pepechorva/Rabosa_micromouse/Documentacion/estado-del-proyecto.md

# 📊 Estado del proyecto — Rabosa-MVR

> **Última revisión:** 5 de octubre de 2026
> **Hito MVP:** 19 de septiembre de 2026 → **no alcanzado** (todo el hardware está validado;
> lo que falta es la capa de control)
> **Competición:** 🏁 **disputada y perdida el sábado 3-oct**: el robot se movió sin cable, pero se
> perdió en el laberinto (un pasillo de 8 celdas a tropezones hasta chocar con una pared). Lo que
> falló, **medido**, está en [plan-mejoras.md](./plan-mejoras.md), y la respuesta en
> [puesta-a-punto.md](./puesta-a-punto.md).
> **En curso:** se está acabando de **soldar el bloque analógico** (divisores de batería + 4 canales
> de sensores de pared). El **menú y la máquina de estados** pasaron de diseño a **implementados** el
> 2026-09-28: ver [maquina-estados-menu.md](./maquina-estados-menu.md).
> Este documento es un *snapshot*: se actualiza en cada revisión. El plan a largo plazo vive en
> [planificacion.md](./planificacion.md).

---

## 1. Resumen

| Área | Estado |
|:-----|:---:|
| Arquitectura por capas definida y compilando | ✅ |
| Capas HW / HAL / SENSOR y banco de pruebas | ✅ |
| Encoders (TIM2/TIM3) | ✅ |
| IMU MPU6500 por SPI2 | ✅ |
| Botones (4, pull-up interno, sin resistencias) | ✅ |
| Pantalla OLED SSD1306 128×32 por I2C1 | ✅ |
| Módulo de batería 2S (código + aviso) | ✅ (divisores soldados el 30-sep; **la celda 1 no se usa** mientras se alimente con fuente) |
| Telemetría Teleplot por USART3 | ✅ (+ **consola de órdenes** desde el 30-sep: `BAT`, `HELP`; + `PID` desde el 1-oct) |
| Sensores de pared IR y medida de batería por ADC | ⚠️ **Soldado** (30-sep) y **detección de paredes escrita (1-oct)**: `app/walls.c` con umbral por pared, **ajustable sin cable** (prueba 21). Pruebas **13–17 implementadas**, pendientes de ejecutar |
| Máquina de estados y menú con botones | ✅ **FSM (30-sep)**: menú y APP con el patrón `app/fsm.h` + árbol TEST/EXPLORE/RESOLVE/SETTINGS/DIAG/PARAR; el botón MENU va por **interrupción** (salida de emergencia) |
| Capa **CONTROL** (PID de velocidad + rampas) | ✅ **Implementada (28-sep), verificada en simulación y SINTONIZADA en el robot (1-oct)**: `Kp = 0,10` · `Ki = 0,50` · `Kd = 0` dan **0,5 % de error de régimen** y 0,6 s de asentamiento |
| Capa **FILTER** (odometría, filtros, IEKF) | ⚠️ **Odometría escrita (28-sep) y validada en el robot (1-oct)**: `filter/odometry.c` con la trocha efectiva ya medida · el resto (filtros, estimador de orientación) por escribir |
| Odometría (`odometry.c`) | ✅ **Validada en hardware (1-oct)**: recta de 1 m con **−0,3 %** de error, **trocha efectiva calibrada a 77,6 mm** y giro de 90° a mano **clavado (+90° / −90°)**. ⏳ Falta el cuadrado de cierre 4×300 mm |
| Pruebas de banco lanzables desde el menú | ✅ (28-sep) |
| Movimientos primitivos (`app/motion.c`) | ⚠️ **Escritos (1-oct)**: `MOTION_Avanzar(mm)` y `MOTION_Girar(grados)` con lazo cerrado sobre la odometría, y banco lanzable (**prueba 20**). Pendientes de medir en el robot |
| Navegación (wall follower / flood fill) | ❌ Pendiente |
| Chasis y montaje definitivo | ⚠️ Chasis impreso provisional + placa de prototipos (no breadboard) |
| Laberinto 4×4 | ⚠️ Pendiente de construir |
| PCB propia (KiCad) | ⏸️ **Aparcada a la V2** |
| Fotografías y capturas 3D | ⏳ Pendientes |
| Pinout oficial sincronizado desde `pinout.pdf` | ✅ |
| Lista de hardware (módulos reales + enlaces de compra) | ✅ |

---

## 2. Qué está hecho

### Código

| Capa | Módulos |
|:-----|:---|
| **CORE** | `profile` (perfil trapezoidal unit-agnóstico, validado en el PC) · `core_io.h` (el **contrato** con `drivers/`: lectura de pared, cuentas y velocidad por rueda, reloj, consigna y parada). ⚠️ Sin implementación todavía |
| **DRIVERS** | ❌ **Vacía a propósito**: el contrato se escribió antes que el driver para no descubrir la interfaz parcheando. Ver `firmware/drivers/README.md` |
| **HW** | `io.c/h`, `io_def.h` — acceso rápido a registros GPIO (BSRR/ODR) |
| **HAL** | `adc` (ADC1, 6 canales, polling) · `drv8833` (Init, SetSpeed −100..100, Brake, Coast) · `gpio` · `i2c` (I2C1 maestro 100 kHz) · `pwm` (4 canales TIM1) · `reset` (causa del último reinicio, de `RCC->CSR`) · `spi` (SPI2) · `systemclock` (72 MHz) · `timers` (TIM1 PWM) · `uart` (USART3 + helpers, **recepción por interrupción**) |
| **SENSOR** | `encoder` (TIM2/TIM3 modo encoder + `max_likelihood_counter_diff`) · `imu` (MPU6500 por SPI2 con `IMU_Init`/`IMU_Read`/`IMU_Detected`) · `battery` (divisores 22k/10k, media de 16 lecturas, clasifica OK/aviso/crítica) |
| **CONTROL** | `pid` (Kp/Ki/Kd con **anti-windup**, derivada sobre la medida y filtrada, `dt` validado) · `setpoint` (rampa de consigna) · `controller` (lazo de una rueda: consigna + PID → duty) — ver [control-pid.md](./control-pid.md) |
| **APP** | `application` (FSM de la APP + banco de **19** rutinas) · `menu` (FSM de navegación + tablas `const`) · **`fsm`** (macros del patrón de estados) · `telemetry` (formato Teleplot, **todo numérico**) · `console` (órdenes que llegan por USART3) · `buttons` (4 botones; MENU por interrupción) · `oled` (SSD1306 128×32 + framebuffer) |
| **Build** | `platformio.ini`, `extra_script.py`, `peripherals.h`, `pinout.h`, `main.c` |

### Pruebas de banco (confirmadas en hardware)

| # | Prueba | Estado |
|:-:|:---|:---:|
| 1 | ADC + sensores IR + telemetría | ✅ |
| 2 | Motores + encoders en bucle cerrado | ✅ |
| 3 | ADC → PWM | ➖ **Retirada** (28-sep): el robot no lleva potenciómetros |
| 4 | Encoders (solo lectura) | ✅ |
| 5 | IMU MPU6500 por SPI2 | ✅ |
| 6 | Loopback SPI2 (diagnóstico de bus) | ✅ |
| 7 | Calibración de encoders (PPR / µm por cuenta) | ❌ Pendiente |
| 8 | Botones MENU/UP/DOWN/OK | ➖ Sustituida por la 10 (botones + pantalla) |
| 9 | Rampa de PWM en lazo abierto **medida en ticks de encoder** (izq. PA8/PA9 · dcha. PA10/PA11) | ⚠️ v1 (temporal) validada con la rueda **izquierda** (18-sep) · v2 por ticks y rueda derecha, pendientes |
| 10 | Botones → pantalla OLED por I2C1 | ✅ 20-sep (pantalla girada 180° con `OLED_ROTACION_180`) |
| 11 | Diagnóstico del bus I2C1 (niveles en reposo + escaneo de direcciones) | ✅ 21-sep · `SCL=1`, `SDA=1`, `I2C_FOUND:60` (0x3C) ⇒ el módulo ya trae pull-ups |
| 12 | Batería 2S: pack + celda 1 con divisores **22 kΩ/10 kΩ** (montados 30-sep) | ❌ Pendiente de ejecutar |
| 13 | Chequeo de la **soldadura** del ADC (4 IR + 2 divisores), con veredicto por canal | ❌ Pendiente (función implementada 30-sep) |
| 14 | Emisores IR uno a uno, los cuatro y apagados (PB3/PB4/PB5/PB8) | ❌ Pendiente (función implementada 30-sep) |
| 15 | Receptores IR: **matriz 4×4** emisor↔receptor y elección de $R_L$ | ❌ Pendiente (función implementada 30-sep) |
| 16 | IR modulado: ON−OFF por software (cancela luz ambiente) | ❌ Pendiente (función implementada 30-sep) |
| 17 | Curva distancia↔ADC de los IR (3–15 cm), guiada por OLED | ❌ Pendiente (función implementada 30-sep) |
| 18 | **PID de velocidad por rueda** (capa CONTROL) | ✅ **Sintonizada el 1-oct**: `Kp = 0,10` · `Ki = 0,50` · `Kd = 0,00` → error de régimen **0,5 %** (298,5 mm/s pidiendo 300), asentamiento 0,6 s. `Kp` está limitado a ~0,2 por el **retardo del lazo**, no por la planta |
| 19 | **Odometría diferencial**: pose $(x, y, \theta)$ a partir de los incrementos de las ruedas (capa FILTER) | ✅ **Recta y giro validados (1-oct)**: 1 m con **−0,3 %** de error (confirma los 287,0 µm/cuenta); el giro medía un **7 % corto** y, tras poner la **trocha efectiva en 77,6 mm**, sale **clavado (+90° / −90°)**. ⏳ Falta el cuadrado de 4×300 mm |
| 20 | **Primitivas de movimiento**: avanzar una distancia y girar un ángulo (`app/motion.c`) | ⚠️ **Escritas (1-oct)**, con banco en la prueba 20 (OK avanza 180 mm, UP/DOWN giran ±90° y el error va **acumulado**). Pendiente de medir: celda < 5 mm y giro < 2°. Son la base del *wall follower* y del *flood fill* |

### Capacidades confirmadas

- Comunicación por USART3 y telemetría en formato Teleplot.
- Lectura de los **4** canales de sensores de pared por ADC (`WALL A1`–`WALL A4`) y de los **2** de batería (PB0 total, PB1 celda 1).
- Movimiento de motores por PWM a través del **DRV8833** y frenado.
- Lectura de encoders en modo hardware con detección de dirección y *overflow*.
- IMU MPU6500 respondiendo por SPI2 (se identificó el cruce `SDA/ADO` como causa de fallo típico).
- Diagnóstico de bus SPI con `App_Test_SPI2_Loopback()`.

---

## 3. Qué está pendiente

### 3.1 El *stash* es obsoleto (analizado el 2026-09-21)

`stash@{0}` se llama *«capas pendientes: control, filter, imu, sensor, menu, oled, spi»*, pero al
listar su contenido **no aparece ningún fichero de `control/`, `filter/`, `menu*` ni `oled*`**:

```bash
git stash show --name-only stash@{0} | grep -iE "control|filter|menu|oled"   # → (vacío)
```

Es una foto **anterior a la arquitectura por capas**, con versiones viejas de `application.c`,
`hal/*`, `src/main.c`, `encoder.c` y `platformio.ini`. **Decisión: se ignora.**

CONTROL y FILTER se escriben **de cero**, igual que ya se han escrito `oled.c`, `buttons.c`,
`battery.c` y `spi.c` (todos funcionando en hardware). Cuando ya no haga falta: `git stash drop`.

> Detalle de la comprobación en [pruebas-pendientes.md](./pruebas-pendientes.md) §8.

### 3.2 Pendiente de escribir

- ~~`filter/odometry.c` con la interfaz definida en [odometria.md](./odometria.md)~~ → ✅ **hecha el 28-sep**
  (integración de incrementos de arco; banco en el PC y prueba 19).
- Estimador de orientación (fusión IMU) y filtros de los sensores de pared, en la capa FILTER.
- ~~Máquina de estados en `application.c`~~ → ✅ **hecha el 28-sep** (`BOOT → MENU → {TEST, CAL, DIAG, EXPLORAR} → STOP/FAULT`).
- Movimientos primitivos: `avanzar_celda()`, `girar_90()`, `centrar_pasillo()`, `parar()`.
- Wall follower ("mano derecha") y, más adelante, flood fill.
- DMA para el ADC (lectura continua sin bloquear la CPU).

### 3.3 Pendiente de hardware
- ✅ **Botones cableados**: MENU=PC14 · UP=PB9 · DOWN=PC15 · OK=PA12, con **pull-up interno**
  (activo a bajo, sin resistencias externas). Pulsadores conmutados el 20-sep respecto al plan.
- ✅ **JTAG desactivado** (`__HAL_AFIO_REMAP_SWJ_NOJTAG()` + PB3/PB4/PB5 como salida, en `gpio.c`): los emisores IR ya pueden encender. Queda **verificarlo en hardware** con la prueba 14.
- **Montar los divisores de tensión** de la batería en PB0/PB1 y ejecutar la prueba 12 (⏳ **en soldadura**, 2026-09-28).
- **Medir** los parámetros que hoy son hipótesis: **trocha efectiva** (procedimiento en
  [pruebas-bringup.md](./pruebas-bringup.md) §15, prueba 19) y **radio de rodadura**. El PPR — **7** — y
  la reducción — **1:10** — ya los publica el fabricante ([hardware.md](./hardware.md#42-encoders)), y
  el radio efectivo va dentro de los µm/cuenta que verifica la prueba 7.
- Calcular las **resistencias de los emisores IR**: ✅ calculadas y montadas (22 Ω por emisor + transistor BC337, §4.4 de `hardware.md`), pendientes de la $R_L$ de los receptores (**3 kΩ**, a ajustar con las pruebas 1 y 15).
- **Montar los divisores de tensión** de la batería en PB0/PB1 y ejecutar la prueba 12.
- Decidir la **posición física** de los 4 canales IR.
- Rediseñar las **ruedas** (acercarlas al centro) y actualizar chasis/trocha.
- ✅ Montaje en **placa de prototipos** (se descarta la breadboard).
- Laberinto 4×4 de cartón pluma o DM.
- **Exportar los STEP** del montaje y del chasis a `mechanical/freecad/export/` y cerrar las cotas
  (hoy la trocha tiene tres valores distintos en la documentación).
- **Fotos** y capturas 3D del robot para la documentación (pendientes).
- ✅ **Rieles de alimentación confirmados (21-sep)**: los 3,3 V los genera el **regulador de la propia
  Blue Pill** (IMU, emisores IR y receptores IR); al riel de **5 V** cuelgan la **OLED** y los
  **encoders N20**. Los botones usan el **pull-up interno**. El módulo AMS1117 solo hace de soporte
  físico del display.
- ✅ **Encoders: riel y especificaciones (21-sep)**: van al riel de **5 V** (el módulo admite
  **3,3–5 V**), que es como se hicieron las pruebas de motores y encoders. La salida es de
  **colector abierto con pull-up de 3,3 kΩ** ⇒ el nivel alto acompaña al riel del pull-up.
  El código ya lleva las constantes del fabricante: **7 PPR**, **1:10**, **280 cuentas** por vuelta
  de rueda y **235,6 µm/cuenta**.
- ✅ **Nivel alto de los encoders medido (21-sep)**: con `VCC` = 5 V la salida de `C1`/`C2` da
  **≈3,6 V de pico a pico**, o sea que el módulo limita internamente la salida (el pull-up no va
  directo a `Vcc`). Queda dentro del **máximo absoluto** de 4,0 V de PA0/PA1/PA6/PA7 (pines `TTa`,
  sin `FT`) y muy por encima del umbral de lectura (2,31 V) ⇒ **se queda como está**.
  Opcional para la PCB V2: `VCC` del encoder a 3,3 V, que también está en su especificación
  ([hardware.md §4.2](./hardware.md#42-encoders)).
- **PCB propia en KiCad**: ⏸️ aparcada a la V2. Cuando se retome: **hay que sustituir el buck MP1584**
  (está **NRND**, *not recommended for new designs*) por uno activo de bajo Iq — criterios en
  [hardware.md §4.6](./hardware.md); y la **batería LiPo es provisional** (se actualizará cuando el
  usuario tenga una nueva).
- Completar los [cabos sueltos](./hardware.md#6-cabos-sueltos) de `hardware.md`.

### 3.4 Pendiente de calibración

- **Reducción del N20**: ✅ **1:10** según la tabla del fabricante; la prueba 7 lo verifica contando
  pulsos (10 vueltas de rueda ⇒ 2800 cuentas).
- `micrometers_per_count` (avanzar 1 m y dividir).
- Curva distancia IR (3–15 cm, error < 1 cm).
- Offset del giroscopio: ✅ **hecho el 2026-10-02**, pero **no a mano**: lo promedia el propio firmware (50 muestras con el robot parado) al entrar en las pruebas 20 y 21 (`motion_gyro_calibrar()`); el sesgo se queda en `Motion_t.gyro_sesgo`.
- Divisores de tensión de la batería: ✅ **montados y definitivos (30-sep)**: pack **22 kΩ + 10 kΩ** y celda 1 **3k9 + 10 kΩ** (no los 100 kΩ/56 kΩ calculados) → verificar la prueba 12 y **calibrar con `BAT CAL <mV>`** (`sensor/battery.c`).

---

## 4. Siguientes pasos

| # | Paso | Puerta de salida |
|:-:|:-----|:---|
| 1 | ~~**Terminar de soldar** el bloque analógico: divisores de batería + 4 canales IR~~ ✅ **hecho (30-sep)**: el robot está soldado; las 5 pruebas del bloque (13–17) están escritas | Soldaduras repasadas y 3.3 V del regulador de la Blue Pill verificados |
| 2 | ~~Ejecutar la **prueba 13** (chequeo de la soldadura del ADC)~~ ✅ **hecho (30-sep)**: los 4 receptores y PB0 `OK` (medida con sol: repetir con luz controlada) | Los 6 canales con veredicto `OK` |
| 3 | **Pruebas 14 y 15**: ✅ **pareja emisor↔receptor medida (30-sep)** — R0←IR3 · R1←IR1 · R2←IR2 · R3←IR0 — y posiciones físicas de emisores y receptores anotadas. ⏳ Falta cerrar la **14** por el lado eléctrico (caída en las 22 Ω, consumo y riel con los cuatro a la vez) | Los 4 pares identificados y la $R_L$ definitiva elegida |
| 4 | Ejecutar la **prueba 16** (modulado ON−OFF) — ⏳ **aplazada a la tarde (30-sep)**: necesita luz controlada | `DIF` estable al encender y apagar la luz de la sala |
| 5 | Ejecutar la **prueba 17** (curva IR) — ⏳ **aplazada a la tarde (30-sep)**: necesita luz controlada | Error < 1 cm entre 3 y 15 cm |
| 6 | 👉 **Siguiente (30-sep)**: ejecutar la **prueba 12** y **calibrar el divisor** con el multímetro (`BAT CAL <mV>`) | `VBAT` dentro del ±3 % |
| 7 | Ejecutar la **prueba 7** (PPR y µm/cuenta) | PPR entero y repetible; ≈660 mm |
| 8 | ~~Decidir los **glifos** y programar **M1**~~ ✅ **hecho (28-sep)**: glifos `F G R X + / >` añadidos a `oled.c` y menú programado en `app/menu.c/h` | Recorrer el árbol de menú con los 4 botones, sin PC |
| 8b | **Menú y APP como FSM** con el patrón `app/fsm.h` + árbol nuevo (✅ 30-sep) | Escribir estados y transiciones como el diagrama, con traza `>APP_EST`/`>MENU_EST` |
| 8c | **Pantallas de SETTINGS** (fase M6b): editor de valores con UP/DOWN/OK — BATERIA · VELOCIDAD · PID · LABERINTO · TELEMETRIA · GUARDAR/RESET | Cambiar un umbral o una ganancia con los botones y que sobreviva al reinicio |
| 9 | ~~Mover las pruebas a `bench.c` + `APP_Pump()`~~ ✅ **hecho de otra forma (28-sep)**: las pruebas siguen en `application.c` y salen con `while (!BUTTONS_SalidaSolicitada())` (MENU por interrupción) | Lanzar **y salir** de cualquier prueba desde la OLED |
| 10 | ~~Escribir `control/pid.c` + `setpoint.c` + `controller.c`~~ ✅ **hecho (28-sep)**: implementado y validado en simulación ([control-pid.md](./control-pid.md)) | PID de velocidad en ambos motores |
| 10b | **Sintonizar el PID sobre el robot** (prueba 18, Ziegler-Nichols) | Escalón sin sobreimpulso > 20 %; con la misma consigna en las dos ruedas, el robot va recto |
| 11 | Escribir filtros y `odometry.c` | Posición estimada con error < 5 % |
| 12 | Implementar la máquina de estados de misión + movimientos | 90° con error < 2° |
| 13 | Wall follower en laberinto 4×4 | Recorrido completo 10/10 |
| 14 | Validar la **prueba 9 v2** (rampas por ticks) en las dos ruedas | Ticks por vuelta repetible |
| 15 | ~~Completar la **prueba 3** (ADC→PWM)~~ ➖ **retirada** (28-sep): el robot no lleva potenciómetros | — |

---

## 5. Riesgos y bloqueos

| Riesgo | Impacto | Mitigación |
|:---|:---|:---|
| Reducción del N20 mal asumida | `micrometers_per_count` y odometría mal escalados | La tabla del fabricante da **1:10** y **7 PPR**; la prueba 7 lo verifica contando (2800 cuentas = 660 mm) |
| Cabos sueltos de hardware sin resolver | Compras equivocadas, firmware que no encaja | Resolver midiendo antes de comprar |
| CONTROL y FILTER hay que escribirlos **de cero** (el *stash* no los trae) | Es el camino crítico hacia el movimiento | Empezar por el PID de velocidad, con su prueba de banco |
| Sin DMA en el ADC | El bucle de control puede perder muestras a alta velocidad | Planificar DMA antes de subir la velocidad |
| Ruido en los sensores IR | Umbrales y PID inestables | Filtrar y calibrar antes de cerrar el lazo |
| El hito del 19-sep **no se alcanzó** | Hay que reencuadrar la fecha | El hardware está validado: priorizar control y movimiento, sin fecha cerrada |

---

## 6. Registro de decisiones

| Fecha | Decisión | Motivo |
|:---|:---|:---|
| 2026-07-23 | Migrar de estructura plana a arquitectura por capas | Aislar cambios de hardware en una sola capa |
| — | Telemetría por **USART3** en lugar de USART1 | Liberar pines y separar depuración de programación |
| — | IMU por **SPI2** en lugar de I2C | Mayor velocidad de lectura |
| — | Encoders en modo hardware (TI12, ×4) | Más resolución y sin *polling* de GPIO |
| 2026-09-10 | Documentar hardware/pruebas/estado y empaquetar el flujo como skill del agente | Trabajar de forma incremental y trazable |
| 2026-09-10 | Driver de motor confirmado: **DRV8833** | Resuelta la discrepancia con el BOM (TB6612FNG) |
| 2026-09-10 | Pinout actualizado desde `pinout.pdf` (3 sep) | Añade LEDs (PA12/PA15/PB9/PC13–15), doble medida de batería y 4 canales IR; PB1 deja de ser sensor de pared |
| 2026-09-10 | Reducción del N20 asumida como **desconocida (¿10:1?)** | Se determinará por prueba, no por datasheet |
| 2026-09-10 | **Lista de hardware completada** | Motores JGA12-N20B 6V, DRV8833, MT3608+MP1584, LiPo 2S 450mAh 80C, 4+4 IR |
| 2026-09-10 | Constantes cinemáticas actualizadas a $r = 10.5$ mm, $L \approx 83.6$ mm | Antes eran valores de ejemplo (16 mm / 50 mm) |
| 2026-09-10 | Añadida la prueba 7 de calibración de encoders + [calibracion-encoders.md](./calibracion-encoders.md) | Cerrar PPR, reducción y µm/cuenta por medición |
| 2026-09-10 | **4 botones** (MENU, UP, DOWN, OK) sobre pines de la lista de LED | Entrada de usuario para el menú; pines aún por asignar |
| 2026-09-10 | Detectado que **JTAG sigue activo** y PB3/PB4/PB5 como entrada | Los emisores IR L1–L3 no pueden funcionar así |
| 2026-09-10 | **Corregido**: `SWJ_NOJTAG()` + PB3/PB4/PB5 como salida en `gpio.c` | Habilita los emisores IR L1–L3 y libera PA15 |
| 2026-09-10 | Botones asignados: **MENU=PA12 · UP=PC15 · DOWN=PB9 · OK=PC14** | Se saca UP de PA15 para que ningún botón dependa del JTAG; PC13 se mantiene como LED |
| 2026-09-10 | Botones implementados en `app/buttons.c` (capa APP) | Es entrada de usuario y va parejo con el futuro `menu.c` |
| 2026-09-10 | `gpio.c` ya **no reconfigura PA13/PA14** | Eran SWDIO/SWCLK: ponerlos como GPIO dejaba sin depurador |
| 2026-09-10 | Depuración **solo por SWD** (SWDIO/SWCLK), JTAG desactivado de forma permanente | Los emisores IR necesitan PB3/PB4 como GPIO |
| 2026-09-19 | Prueba de banco 9: `App_Test_PWM_Rampa()` sobre **PA8/PA9** (canal A del DRV8833 = `motor1`) | Validar pinout de PWM, frenada en seco y sentido de giro sin encoders; identifica qué rueda cuelga del canal A |
| 2026-09-19 | **Ruedas identificadas**: canal A (PA8/PA9) = **izquierda** · canal B (PA10/PA11) = **derecha**; la prueba 9 pasa a elegir motor con `PWM_RAMPA_MOTOR` (1 izq · 2 dcha · 0 ambos) | Ya no hay que adivinar el montaje: el reparto se midió en banco moviendo cada par de pines por separado |
| 2026-09-19 | **Encoders cableados y confirmados**: izq. PA0/PA1 (TIM2) · dcha. PA6/PA7 (TIM3) — coincide con lo que ya esperaba `sensor/encoder.c`, sin cambios de configuración | El cableado estaba planificado así desde el pinout; se verifica que no hay que reasignar pines |
| 2026-09-19 | Prueba 9 rehecha con el **encoder como reloj**: rampas de 1500 ticks (500 ticks = 1 s) en vez de 3 s; las pausas de 2 s siguen en ms (parado no hay ticks) y se añaden timeouts anti-atasco | La rampa pasa a ser reproducible por distancia recorrida, no por tiempo, y de paso valida los encoders |
| 2026-09-20 | Eventos de botón con **potencias de dos**: 1 MENU · 2 UP · 4 DOWN · 8 OK (`BUTTONS_GetEvent()` + `>BTN:n`) | Coinciden con los bits de `BUTTONS_GetMask()`: evento y máscara se pueden combinar con `&` |
| 2026-09-20 | Freno de banco: `while(1){;}` en `main.c` antes de `APP_Run()` (preferencia del usuario; un define para elegir modo, más adelante) | Evita que los motores giren mientras se toca el hardware. Consecuencia anotada: `--gc-sections` elimina el banco de pruebas del binario |
| 2026-09-20 | **OLED SSD1306 128×32 en I2C1** (PB6/PB7, 0x3C) con driver propio `app/oled.c` (framebuffer de 512 B, sin librería externa) | Mostrar estado sin depender del PC. Prueba 10: cada botón enseña su nombre y su pin |
| 2026-09-20 | **Botones intercambiados**: MENU=PC14 · UP=PB9 · DOWN=PC15 · OK=PA12 (antes MENU=PA12 · UP=PC15 · DOWN=PB9 · OK=PC14) | El cableado real no coincidía con la asignación; se cuadra en firmware (`pinout.h` + `gpio.c` + nombres de `buttons.c`) |
| 2026-09-20 | Prueba 11: diagnóstico del bus I2C1 (niveles en flotante + escaneo de direcciones). Documentado que **en el F1 no hay pull-up interno en `AF_OD`** (el HAL ignora `Pull`) | Sin pull-ups nadie sube el bus; la prueba dice si hay que añadir 2× 4.7 kΩ |
| 2026-09-21 | **Divisores de batería calculados: 100 kΩ + 56 kΩ (1 %)** (pack en PB0, celda 1 en PB1; celda 2 = resta). k = 0.359 ⇒ 3.015 V a 8.4 V, 81 µA *(el filtro de 100 nF se retira ese mismo día: ver la fila «sin condensadores»)* | Pack de solo 450 mAh: se busca bajo consumo manteniendo resolución de 2.25 mV/cuenta |
| 2026-09-21 | **Reloj del ADC corregido a 12 MHz** (`RCC_ADCPCLK2_DIV6` en `HAL_ADC_MspInit`) y tiempo de muestreo a **239.5 ciclos** | El prescaler nunca se configuraba ⇒ 36 MHz, fuera de los 14 MHz máximos del F1. Y con 13.5 ciclos solo se admitían ~13 kΩ de fuente: los divisores (36 kΩ) y los fototransistores IR necesitan más |
| 2026-09-21 | **Datasheets añadidos al repo**: `Datasheets/sfh4550.pdf` (ams-OSRAM) y `Datasheets/st-1kl3a.pdf` (Kodenshi) | Sacar los números reales en vez de estimarlos |
| 2026-09-21 | **Resistencias IR calculadas**: emisores **220 Ω** (≈9.3 mA, 37 mA los cuatro); receptores **$R_L$ = 4.7 kΩ** *(sin condensador de filtro: ver la fila «sin condensadores»)* | La $I_L$ del ST-1KL3A (5 mA a 200 lx) hace que la luz ambiente sature el receptor en continua: hay que medir y ajustar, y modular más adelante |
| 2026-09-21 | **Sin condensadores** (decisión del usuario: **no queda espacio** en el chasis): se quitan los 2× 100 nF de los divisores de batería y los 4× 10 nF de los receptores IR. Se mantienen los valores de resistencia (100 kΩ/56 kΩ y $R_L$ = 4,7 kΩ) | El ADC no los necesita: la carga del nodo (36 kΩ × 8 pF ≈ 0,3 µs) es 70× más rápida que el muestreo de 21 µs. El ruido se combate con la **media de 16 lecturas** (`BAT_MUESTRAS`) y, en los IR, con la futura **modulación por PWM**, que ahora no tiene límite de frecuencia |
| 2026-09-21 | **Aviso de batería baja**: módulo `sensor/battery.c` (SENSOR, mide y clasifica) + `app_aviso_bateria()` (APP: LED a 1/4 Hz y mensaje en la OLED) | Separar medida de presentación; listo para llamarlo desde el bucle de la futura máquina de estados |
| 2026-09-21 | **Lista de módulos reales con enlaces de compra** (`hardware.md` §7) y **reparto de rieles confirmado**: 3,3 V del regulador de la Blue Pill (IMU, emisores y receptores IR), **OLED y encoders a 5 V**, botones con pull-up interno. El módulo AMS1117 **no regula**: es el soporte físico del display | Saber qué hay montado de verdad y de dónde cuelga cada carga |
| 2026-09-21 | **Encoder alimentado a 5 V** (como está montado y probado en banco). **Medido: la salida da ≈3,6 V de pico a pico**, así que el módulo limita internamente el nivel alto (el pull-up no va directo a `Vcc`) | Queda dentro del máximo absoluto de 4,0 V de PA0/PA1/PA6/PA7 (pines `TTa`, sin `FT`) aunque en el límite de `VDD + 0,3 V` ⇒ **no se cambia nada**; para la PCB V2 se puede pasar `VCC` a 3,3 V por margen |
| 2026-09-21 | **Especificaciones del motor+encoder volcadas al repo** (imágenes en `images/motor-encoder/`): familia **GA12-N20 (B1215)**, modelo `GA12-N20-S0310D-E`, 6 V 1500 RPM, caja GA12 **1:10**, encoder **7 PPR** / 100 kHz / AB · ⇒ **280 cuentas** y **235,6 µm/cuenta** con rueda Ø21 mm | Teníamos «1:10 hipótesis» y «PPR desconocido»: ahora la odometría arranca con números del fabricante y la prueba 7 solo verifica |
| 2026-09-21 | Constantes **`ENCODER_PPR_MOTOR`, `ENCODER_REDUCCION`, `ENCODER_CUENTAS_POR_VUELTA`, `RUEDA_DIAMETRO_MM`, `ENCODER_UM_POR_CUENTA`** en `sensor/encoder.h`, y `micrometers_per_count` se **siembra** con ese valor en `ENC_Init()` | La odometría deja de depender de que alguien llame a `set_micrometers_per_count()` a mano |
| 2026-09-21 | **Renombrado de la raíz del workspace descartado** (decisión del usuario): se deja `Rabosa-MVR.code-workspace` con las dos raíces (`"."` y `"firmware"`), documentado en [README.md](../README.md) | La extensión PlatformIO reconoce el proyecto y la duplicidad en el explorador no molesta |
| 2026-09-21 | **`Datasheets/` completado: 20 PDF** (~33 MB) y **índice** `Datasheets/README.md`. Añadido `!Datasheets/*.md` al `.gitignore` | Tener la documentación de los componentes en el repo; faltó solo el MP1584 (su web bloquea la descarga) |
| 2026-09-21 | **El buck MP1584 está NRND** y su hoja de datos lo dice con el sello «NOT RECOMMENDED FOR NEW DESIGNS · **REFER TO MP2338**»: el módulo sigue en el prototipo, pero **para la PCB V2 hay que elegir otro** buck (5 V @ ≥1 A, bajo Iq, ciclo de vida activo; candidato natural el **MP2338**; valorar buck-boost) | No diseñar la placa con un componente que el fabricante desaconseja para diseños nuevos |
| 2026-09-21 | **Batería LiPo provisional**: se sustituirá por una más nueva; las especificaciones se actualizarán cuando lleguen | No cerrar el diseño de alimentación con una batería que va a cambiar |
| 2026-09-21 | **`Obsidian/` eliminado** del repositorio: era un cuaderno personal y estaba desactualizado (TB6612FNG, otro pinout…) | Lo útil ya está volcado: receta de Ziegler-Nichols y *wall follower* en [pruebas-pendientes.md](./pruebas-pendientes.md), el 220 Ω de los emisores IR en [hardware.md](./hardware.md) §4.4 |
| 2026-09-21 | Se versionan **solo los `mechanical/freecad/*.FCStd`** (los ZIP de GrabCAD, 784 MB, siguen ignorados) | Guardar los diseños propios sin inflar el repo |
| 2026-09-21 | **PCB propia en KiCad aparcada a la V2** | Primero un robot que funcione |
| 2026-09-21 | La documentación se amplía con **`calculos-diseno.md`, `historial-pruebas.md` y `pruebas-pendientes.md`** | Trazabilidad: qué se hizo, qué falta y con qué números |

| 2026-09-28 | **Pruebas 13–17 dadas de alta** para el bloque analógico: 13 = chequeo de la soldadura del ADC, 14 = emisores IR uno a uno, 15 = receptores y elección de $R_L$, 16 = modulado ON−OFF, 17 = curva distancia↔ADC | Se está terminando de **soldar** el ADC (divisores + paredes): el bring-up se planifica **antes** de tener el hierro montado |
| 2026-09-28 | **Diseño de la máquina de estados y el menú** documentado en [maquina-estados-menu.md](./maquina-estados-menu.md): estados `BOOT/MENU/TEST/CAL/DIAG/INFO/RUN/STOP/FAULT`, `APP_Update()` a 1 kHz, `APP_Pump()` para las pruebas bloqueantes, ficheros (`menu.c`, `bench.c`), bocetos de API y fases **M0–M5**. **Sin programar todavía** | El banco actual obliga a tener el PC y el ST-Link al lado; el robot debe manejarse con los 4 botones y la OLED. Se documenta antes de codificar, como marca la skill |
| 2026-09-28 | ✅ **Cabo suelto cerrado**: el comentario de `App_Test_Bateria()` en `application.c` citaba `VBAT_K_DIVISOR`, que no existe; ahora apunta a **`BAT_K_DIVISOR`** (`sensor/battery.c`) | Evitar que la próxima calibración se haga sobre un nombre que no existe |

| 2026-09-28 | **Menú + máquina de estados implementados** (M0/M1/M2): `app/menu.c/h` con tablas `const`, FSM en `application.c`, glifos nuevos en `oled.c` y **el botón MENU por interrupción** (EXTI PC14 → `EXTI15_10_IRQHandler`) | El banco de pruebas ya no necesita el PC: cada prueba se lanza y se sale con los botones. La interrupción era la única forma de que MENU respondiera dentro de un `while(1)` |
| 2026-09-28 | **Prueba 3 retirada** (`App_Test_ADC_PWM`), borrada de `application.c` y de `application.h` | El robot no lleva potenciómetros: era un banco de la primera fase, con la Blue Pill sola |

| 2026-09-28 | **Capa CONTROL implementada**: `control/pid.c` (anti-windup, derivada sobre la medida y filtrada, `dt` validado), `setpoint.c` (rampas) y `controller.c` (lazo por rueda) + **prueba 18** `App_Test_PID()` en el menú (TEST → PID VELOCIDAD, CAL → SINTONIA PID) y **verificación en el PC** con una planta simulada (sobreimpulso −0.2 %, error 0.2 %) | Es el camino crítico hacia el movimiento y **no depende del ADC** (que está en soldadura): se podía adelantar y validar sin hardware |
| 2026-09-28 | **Repaso de estilo de las 17 pruebas heredadas** de `application.c` según §4 de [entorno-desarrollo.md](./entorno-desarrollo.md): un bloque Doxygen por función, fuera comentarios línea a línea y fuera banners `/* ===== */`. De paso se partieron las funciones que hacían dos cosas (prueba 7 en referencias/mano/motores, prueba 9 en `pwm_rampa`/telemetría/frenada). Compila **sin avisos** | La APP era el último fichero con estilo antiguo; ahora todo el firmware se lee igual. Se aprovechó para **corregir dos bucles sin salida** que dejó el incidente de ediciones en paralelo (pruebas 5 y 7) |
| 2026-09-28 | **Odometría escrita** (capa FILTER): `filter/odometry.{h,c}` + banco en el PC `firmware/test/odometry_sim.c` + **prueba 19** `App_Test_Odometria()` en el menú. Se **integra por incrementos de arco** (no $v\cdot dt$): sin `dt`, con la fórmula exacta del centro de rotación instantáneo. El módulo es matemática pura (no lee encoders: se los pasa la APP) | FILTER era la única capa vacía y no dependía del ADC en soldadura. El banco del PC cierra recta, cuadrado y círculo **con error 0**, así que al robot solo le queda la trocha y el deslizamiento. De paso: `BAT_K_DIVISOR` corregido y `App_RunLoop*` borrados |
| 2026-09-28 | **Presupuesto de Flash**: el banco de pruebas (menú + 19 pruebas) ocupa buena parte del binario (61 %). Decisión del usuario: **cuando haga falta espacio se recortan las pruebas**, que son temporales, en vez de optimizar el código de las capas | El banco solo sirve hasta tener los datos básicos y la conexión de cada periférico; descarta derivados como una tabla propia de seno/coseno para ahorrar los ≈3,3 KB de `sinf`/`cosf` de newlib |
| 2026-09-28 | **Emisores IR: 22 Ω + transistor BC337** (el usuario tenía 22 Ω montada) y **solo un emisor encendido cada vez** (barrido, decisión suya). Se añaden 5 datasheets de transistores que cubren los 10 de su caja | Con 22 Ω cada emisor pide **75 mA**, que un pin del STM32 no da (≈20 mA) ⇒ el transistor no es opcional; con un emisor por vez el riel de 3,3 V solo soporta 75 mA y se puede levantar la matriz 4×4 emisor↔receptor. Detalle en `hardware.md` §4.4 y `calculos-diseno.md` §2.1 |
| 2026-09-30 | **Pruebas 13–17 implementadas** (el robot ya está soldado): 13 = veredicto **automático** por canal (mide con los 4 emisores apagados y encendidos, así que ya no hay que tapar nada con la mano), 14 = secuencia `1→4→5(todos)→0`, 15 = **matriz 4×4** que publica `>IRn_DIF` de los cuatro receptores con cada emisor, 16 = diferencia de 8 pares con su dispersión `>IRn_VAR`, 17 = calibración guiada por OLED con `UP`/`DOWN` y estimación en vivo `>IRn_CM`. Las macros de los emisores van a `pinout.h` (APP ya lo incluye) | El bring-up del bloque analógico se ejecuta **una vez soldado** el hierro: hace falta que el banco diga *qué* está mal (pin mudo, saturado, crosstalk) sin PC ni depurador. `ir_pareja_emisor[]` queda como el sitio donde anotar la pareja medida en la prueba 15 |
| 2026-09-30 | **La celda 1 sin divisor ya no bloquea** (petición del usuario: en el banco alimenta con **fuente de alimentación** y la celda 1 no se usa): `sensor/battery.c` añade `BAT_V_CELDA_PRESENTE`/`BAT_V_PACK_PRESENTE` (0,5 V), `BATTERY_Celda1Presente()` y `BATTERY_PackPresente()`. Si PB1 lee ≈0 V se clasifica **solo con el pack** (`VCELL2` y `VBAT_DESEQ` a 0, sin aviso de desequilibrio); si es PB0 el que no mide (placa por USB/ST-Link) **no se clasifica nada** y el estado queda en `OK`. La prueba 13 estrena el veredicto `NO USADA` y la 12 publica `>PACK_PRESENTE`, `>CELDA1_USADA` y `>CELDA_AVISO` | Un 0 en un canal **sin medida** daba `BATTERY_CRITICA` ⇒ el robot quedaba clavado en **FAULT** (la única salida del FAULT exige que el estado ya no sea crítico) y **no se podía ni entrar al menú** para hacer las pruebas |
| 2026-09-30 | **La celda pasa a ser monitorización, no protección** (aclaración del usuario: «la celda solo se usa para monitorizar; no es crítico que no dé valor, porque igual uso otra batería o una fuente»): se borra `BAT_V_CRIT_CELDA` y la clasificación queda **`estado = pack`**, y después la celda solo puede **subir de `OK` a `AVISO`** (nunca a CRÍTICA). El FAULT queda reservado al pack | Solo el pack bloquea. Con otra química, con fuente o con el divisor de la celda sin montar, los umbrales por celda no significan nada, así que no pueden encerrar el robot. Es la separación **protección (pack) / monitorización (celdas)** |
| 2026-09-30 | **Consola de órdenes por USART3** (petición del usuario: «configurables por telemetría»): recepción **por interrupción** en `hal/uart.c` (anillo de 64 B, `UART_RxStart/RxGet`) + módulo nuevo **`app/console.c/h`** que monta la línea y la ejecuta. Órdenes: `HELP`, `BAT LIST`, `BAT <UMBRAL> <valor>`. `BATTERY_SetUmbral()`/`GetUmbral()` en SENSOR (índice + `BATTERY_UMBRAL_NOMBRES`, con el typedef de tamaño negativo que comprueba que cuadran) y los `#define` pasan a `_DEF` (valores de arranque). Los umbrales **no se guardan en Flash**: al reiniciar vuelven a los `_DEF` | Ajustar los umbrales sobre el robot sin recompilar ni flashear: el valor bueno se descubre mirando la tensión en Teleplot (la prueba 12 atiende órdenes dentro de su bucle). Coste: **+2,6 KB de Flash** (69,7 %), asumible según el presupuesto de recorte de pruebas |
| 2026-09-30 | **El FAULT se abandona con `OK`** (petición del usuario): con una batería que no sea 2S LiPo, una fuente o los umbrales sin ajustar, la crítica es lo normal y no puede encerrar el robot. `fault_reconocido` evita el bucle FAULT→MENU→FAULT (no se reintenta hasta que la medida se recupere) y al salir se apaga el LED. La pantalla del FAULT dice `MOTORES PARADOS` y `OK: VOLVER AL MENU` | Un aviso que no se puede reconocer es un bloqueo, no una protección: el robot sigue frenado y avisando por telemetría |
| 2026-09-30 | 🐛 **BUG ARREGLADO: la recepción por `HAL_UART_Receive_IT()` colgaba el robot.** Síntoma: el menú aparecía en la pantalla y **no respondía a ningún botón** (ni salía telemetría). Causa verificada en `stm32f1xx_hal_uart.c` (línea 3594): `UART_Receive_IT()` sale **sin leer el registro de datos** si `RxState != HAL_UART_STATE_BUSY_RX`, así que con `RXNEIE` activo el flag `RXNE` se queda puesto y **la interrupción se repite sin fin**; el bucle principal no avanza nunca. Arreglo: ISR propia en `hal/uart.c` (`UART_RxIRQHandler()`) que **siempre** lee `SR` y `DR` (eso limpia `RXNE/ORE/NE/FE`) y arma **solo `UART_IT_RXNE`**. De paso se añadió el `BATTERY_Init()` que faltaba en `APP_InitAll()` (los umbrales son variables desde el cambio de arriba y arrancaban a 0) | Regla general: **una interrupción tiene que limpiar siempre su flag en todas las ramas**, y el modo de recepción del HAL no garantiza eso. Lección: al añadir una ISR nueva, comprobar el camino por el que se puede salir sin limpiar el flag |
| 2026-09-30 | 🐛 **BUG ARREGLADO: el menú no respondía a los botones.** El antirrebote se medía en **llamadas** (30 muestras suponiendo 1 kHz) y `MENU_Update()` redibujaba cada 40 ms con un `OLED_Update()` de ~50 ms ⇒ el bucle caía a ~20 Hz ⇒ hacían falta **1,5 s** de pulsación. Arreglo: antirrebote por **tiempo real** (30 ms) y el menú **solo repinta al navegar** | Dos cosas aprendidas: el antirrebote **nunca** se mide en número de llamadas, y un dibujo bloqueante dentro del bucle es una bomba de relojería para los tiempos |
| 2026-09-30 | **Menú y APP como máquinas de estados** (`app/fsm.h`, patrón de Remo Dentato): `START` como **despachador** (se reanudan de llamada en llamada) y guardas globales dentro de `START`. Estados del menú: `LISTA/MOVIENDO/ENTRANDO/VOLVIENDO`; de la APP: `BOOT/MENU/TEST/STOP/FAULT/RUN`. Cada transición publica `>MENU_EST`/`>APP_EST` | El código se lee como el diagrama, el depurador salta entre etiquetas y **se puede reconstruir la sesión por Teleplot** sin estar delante de la pantalla. Árbol nuevo: TEST (4 bloques) · EXPLORE · RESOLVE · SETTINGS · DIAG · PARAR |
| 2026-09-30 | **El FAULT por batería deja de cortar el banco** (síntoma reportado: «el LED parpadea sin parar, puedo moverme por el menú pero las acciones no hacen nada»): la guarda de batería crítica ahora exige `app_state == RUN`, así que en el **menú y las pruebas** una batería baja (fuente de laboratorio) **no** tapa la pantalla, ni parpadea el LED, ni interrumpe nada. Además, al lanzar una prueba se pinta un **cartel** (`PRUEBA / <nombre> / MENU: SALIR`) porque las pruebas de banco solo mandan telemetría y parecía que OK no hacía nada | Dos lecciones: (1) una **alarma que interrumpe** en el banco convierte cada prueba en «no funciona»; la protección de la LiPo pertenece a la **misión**, no al banco; (2) una acción que no **cambia la pantalla** parece que no ha ocurrido |
| 2026-09-30 | **Toda la telemetría pasa a ser NUMÉRICA** (petición del usuario: «por Teleplot solo debe salir una etiqueta y un número»): fuera los textos (`>BOOT:init`, `>ADC_EST0:OK`, los mensajes de ayuda) y dentro **códigos enteros** con su tabla en la documentación (`>BOOT:1`, `>IMU:1`, `>OLED:1`, `>APP_EST:1`, `>ADC_EST0:3`). Se borra `adc_estado_nombre()` y las ayudas habladas de las 19 pruebas | Teleplot dibuja **todas** las etiquetas, en vez de descartar las que no son números. Coste: −1,2 KB de Flash. Las ayudas viven en la documentación y las órdenes de la consola en `comandos-serie.md` (los errores de la consola también son código: `>CMD_ERR:1..4`) |

| 2026-09-30 | **Calibrado de la medida de batería por consola** (`BAT CAL <mV>`): el factor del divisor pasa de `#define` a variable (`k_divisor`, con `BAT_K_DIVISOR_DEF` de arranque) y `BATTERY_CalibrarConPack()` lo recalcula con la tensión que se mida a mano. Se publican `>BAT_K` y `>VBAT` | Sin calibrar, `>VBAT` arrastra la tolerancia de las resistencias y la de VDDA (±5 %), que es justo lo que decide si el pack está «crítico». Síntoma que lo motivó: fuente a 7,4 V y el robot creyendo que estaba por debajo de 6,6 V. Tabla de diagnóstico por `>ADC_B0` en [comandos-serie.md §2](./comandos-serie.md#2-calibrar-la-medida-de-la-batería-bat-cal) |

| 2026-09-30 | **El divisor de batería montado es 22 kΩ/10 kΩ, no 100 kΩ/56 kΩ** (deducido al ver que el firmware medía 6,22 V con la fuente a 7,4 V): `BAT_K_DIVISOR_DEF` pasa a **0,3125** y se corrige toda la documentación (hardware §4.6, cálculos §4, comandos-serie §2, BOM). ⚠️ El orden importa: **22 kΩ arriba y 10 kΩ abajo**; al revés el pin se iría a 5,09 V, y PB0 **no** es tolerante a 5 V (aparece `I/O` **sin** `FT` en el datasheet: máximo 4,0 V) | Con estas resistencias el pin queda al **80 % del fondo de escala** y la **impedancia de fuente baja a 6,9 kΩ** (mejor para el ADC); el consumo sube a 0,39 mA, irrelevante frente a los 44 mA del robot. Confirmado con `>ADC_B0` ≈2772 cuentas = 2,23 V en el pin, que es lo que da esta pareja de resistencias |
| 2026-09-30 | **La prueba 12 publica `>BAT_K`** (el factor del divisor en uso) y se cierran los últimos restos del divisor viejo en el código: la cabecera de `battery.h`/`battery.c`, los `#define BAT_R_ARRIBA_K`/`BAT_R_ABAJO_K` y la nota de `App_Test_Bateria()` seguían diciendo 100 kΩ/56 kΩ, y la sección 12 de `pruebas-bringup.md` aún daba las cuentas esperadas del divisor viejo (3742/1648 en vez de 3258/1435) | Con `>BAT_K` se ve **sin consola** con qué factor está convirtiendo el ADC el firmware que corre: si sale 0,35897 es que el chip todavía tiene un binario anterior al cambio. Un comentario que dice 100 kΩ cuando hay 22 kΩ convierte el diagnóstico en una pérdida de tiempo: la constante era la correcta y la pista falsa la daba el comentario |
| 2026-09-30 | 🐛 **BUG ARREGLADO: la prueba 12 «no hacía nada».** Síntoma del usuario: el cartel `PRUEBA / BATERIA / MENU: SALIR` se quedaba fijo. No estaba colgada: la prueba solo pinta en pantalla cuando hay **aviso**, así que con el pack sano —ya mide 7,17 V con el divisor corregido— no escribía nada y el cartel se quedaba a la vista. Arreglo: `app_pantalla_bateria()` pinta cada 200 ms el pack, la celda 1 y el factor `>BAT_K` en uso, con `MENU: SALIR` en la última línea | Tercera vez en la sesión que muerde el mismo patrón: **una prueba que solo habla por telemetría parece muerta** si estás delante del robot sin el Teleplot abierto. Y confirma el diagnóstico anterior: el síntoma desapareció al corregir el divisor, o sea que el firmware nuevo **sí** está flasheado. El mismo criterio se aplica al **bloque IR**: veredicto por canal en la 13 y cartel con latido en la 14, 15 y 16 (la 17 ya tenía pantalla propia) |
| 2026-09-30 | **Posición física de los 4 emisores IR medida** (en la prueba 14, con la cámara del móvil): `L1` **frontal izquierdo** · `L2` **lateral derecho** · `L3` **lateral izquierdo** · `L4` **frontal derecho**. Anotada en `hardware.md` §4.4 y como comentario en `ir_emisor_pin[]` (`application.c`) | ⚠️ El orden `L1`..`L4` **no es geométrico** (dos frontales y dos laterales entremezclados), así que ni la telemetría de los emisores ni el emparejamiento emisor↔receptor se pueden leer «por número». Los **receptores** siguen sin posición física: la fija la prueba 15 |
| 2026-09-30 | **Renombrados los canales IR de la prueba 15** (petición del usuario: «no sé cuál es cuál»): emisores `>IR0`..`>IR3` (1 = encendido) y receptores `>R0`..`>R3` con las **cuentas crudas del ADC**, en vez de `>IR_EMISOR` más `>IRn_OFF`/`_ON`/`_DIF` (12 etiquetas). Barrido **continuo** (emisor cada `IR_PASO_MS` = 2 s) y pantalla propia con los 8 valores, sin latido | Doce etiquetas con nombres parecidos —`IRn_*` eran los **receptores** y `IR_EMISOR` el emisor— no hay quien las siga en Teleplot. Queda como regla: **`IR` = emisor, `R` = receptor** en todo el proyecto, y la 15 ya no resta ON−OFF (eso es cosa de la 16). ⏳ Renombradas también las etiquetas de canal de la 13 (`>ADC_Rn`, `>ADC_Rn_DIF`, `>ADC_Rn_EST`), la 16 (`>Rn_OFF/ON/DIF/VAR`) y la 17 (`>Rn_CAL`, `>Rn_CM`) |
| 2026-09-30 | **Cuatro submenús `VER R0`..`VER R3`** en el bloque IR (petición del usuario: «será mucho más fácil de ver»): son la prueba 15 vista por un receptor —mismo barrido de emisores, pero la pantalla se queda con su valor (`IR 1 0 0 0` / `R1 3960` / `MENU: SALIR`)—. Una función común `app_test_receptor(canal)` y cuatro envoltorios de una línea, porque el menú llama funciones **sin parámetros** | Sirven para emparejar emisor↔receptor y para ver moverse un canal al acercar la pared, en vez de cuatro números a la vez. El bloque IR pasa de 4 a 8 filas (se navega con scroll, como MOTORES). Cada `VER Rn` publica `>IR0`..`>IR3` y **solo** su `>Rn`: en Teleplot queda limpio |
| 2026-09-30 | ✅ **Prueba 15 ejecutada: pareja emisor↔receptor medida** con los submenús `VER Rn` (pared a 10 cm): **R0←IR3, R1←IR1, R2←IR2, R3←IR0**, anotada en `ir_pareja_emisor[]` **en la numeración de la telemetría** (0..3) y `ir_medir_par()` pasa a usar esa misma numeración (antes 1..4) | Con esto quedan **situados los receptores** (`hardware.md` §4.4): R0 frontal derecho, R1 lateral derecho, R2 lateral izquierdo, R3 frontal izquierdo ⇒ cerrado el último cabo suelto del bloque IR. ⚠️ Ni receptores ni emisores siguen un orden geométrico: **`R0..R3` no es un recorrido por el robot**, hay que mirar las tablas |
| 2026-09-30 | **Prueba 16 con pantalla de valores** (`app_pantalla_modulado()`): el `DIF` y el `VAR` de los cuatro canales, sin latido. El usuario **aplaza las pruebas 16 y 17 a la tarde** porque a esas horas hay sol directo | Las pruebas 16 y 17 son las de **luz ambiente**: con sol el fondo sube y el `DIF` se queda corto ⇒ darían un suspenso falso. Las 13 y 15 sí se hicieron con sol (el emparejamiento emisor↔receptor no depende del fondo, solo del `DIF`) y la condición queda anotada en el registro de §3 |
| 2026-09-30 | 🔧 **`BAT_K_DIVISOR_DEF` = 0,3015** (el calibrado contra el multímetro: pin a 2,241 V con la fuente a 7,40 V y el ADC leyendo 2,231 V ⇒ 2,231/7,40). Con 0,3125 marcaba 7,14 V (−3,5 %, la tolerancia de las resistencias y de VDDA). La **validación del canal de la celda 1** (puentear su divisor a 3,3 V) queda **opcional**: decisión del usuario, ahora no puede hacerla y no es crítica | El robot **arranca calibrado** sin depender de la consola (`BAT CAL` sigue disponible para afinar, pero no sobrevive al reinicio). La tabla de diagnóstico de `>ADC_B0` de `comandos-serie.md` pasa a estar en **tensión de pin**, que no depende de `k` (antes mezclaba las cuentas teóricas con la interpretación del firmware) |
| 2026-09-30 | **Prueba 7 (encoders) en marcha**: `PPR A MANO` da **2707 pulsos en 10 vueltas** (repetible) y **2993 en 11** ⇒ ratio 1,106 ≈ 11/10. El contador es **lineal y no pierde pulsos**, pero salen **≈271 cuentas por vuelta de rueda** frente a las **280 nominales** (−3,1 %) y el PPR implícito (6,77) **no es entero** | Hay que decidir entre dos hipótesis y lo hace la regla: **`UM MOTORES`** avanza 2800 cuentas y, con rueda Ø21 mm, debe recorrer **660 mm** si el factor nominal vale o **681 mm** si el real es 271. Para la odometría y el PID manda el **µm/cuenta medido**, no el PPR |
| 2026-09-30 | **Arranque suave en `UM MOTORES`** (prueba 7): cuenta atrás de `CAL_ARRANQUE_MS` (2 s, pantalla `SUELTA EL ROBOT`, abortable con MENU) + **rampa de duty del 8 % al 20 % en 500 ms**, y `CAL_DUTY_MOTOR` baja de 30 % a 20 % | Arrancar a duty fijo con el robot sujeto disparaba la **protección de la fuente** y reiniciaba la placa (pantalla en blanco). Regla que queda para el banco: **toda prueba que arranque motores debe dar margen para soltar el robot y subir el duty en rampa** |
| 2026-09-30 | **Tres pruebas nuevas de duty mínimo de arranque** (`MIN M1`, `MIN M2` y `MIN AMBOS`, en TEST → MOTORES): suben el PWM desde el 5 % en pasos del 2 % cada 400 ms y paran cuando el **encoder** de ese motor cuenta ≥3 cuentas ⇒ el mínimo con el que vence la fricción estática (`>ARR_DUTY`, `>ARR_M1`, `>ARR_M2`) | Con la rampa empezando al 8 % los motores **solo zumbaban**: por debajo del mínimo de arranque el PWM no mueve nada. El valor medido es el que hay que poner en `CAL_RAMPA_DUTY_INI` |
| 2026-09-30 | **Duty mínimo de arranque medido** con `MIN M1`/`MIN M2`/`MIN AMBOS`: `MIN M2` da **25 · 21 · 19 · 21 · 19 %** (seis pasadas, **peor caso 25 %**), `MIN M1` **21 %** y `MIN AMBOS` **19 / 17 %**. ⚠️ **La mesa inclinada y los cables** que tiran del robot cambian la medida (una pasada dio 11 % y hubo que descartarla): medir con el robot **nivelado** y los cables recogidos. La rampa de `UM MOTORES` queda en **20 % → 35 %**. Y se **invierte el motor 1**, que va montado al revés: se cruzan sus dos canales del DRV8833 en `APP_InitAll()` | Por debajo del mínimo el PWM no vence la fricción estática: por eso con la rampa al 8 % los motores solo zumbaban. La inversión de M1 afecta a **todo** lo que mueva motores (pruebas 2, 9, 18 y esta rampa), así que se arregla en el único sitio donde se configuran los motores |
| 2026-09-30 | **Rampa de arranque escalonada** en `UM MOTORES`: primero sube el motor 1 y después el 2 (dos tandas de `CAL_RAMPA_PASOS` pasos). ⚠️ **Revertida el mismo día** (ver última fila) | El robot **se reinició** al arrancar: los dos motores pedían su pico de corriente a la vez y la fuente entraba en limitación; separarlos en el tiempo reparte el pico. ⚠️ Detalle: con la rampa escalonada el robot arranca **torcido** durante medio segundo (una rueda sola), así que hay que darle espacio |
| 2026-09-30 | 🔍 **Rueda derecha: descartada la mecánica** (el usuario comprobó que las dos ruedas giran **suaves a mano**). Nueva prueba **`COMPARA M`** en TEST → MOTORES: mismo duty a los dos motores (rampa + `COMP_MS` = 2 s) y publica las cuentas de cada rueda (`>COMP_P1`, `>COMP_P2`) y su **desviación en %** (`>COMP_DESV`) | Es el número que explica la **curva** del robot: a lazo abierto los motores nunca son iguales. Si el desvío es grande hay que mirar motor, conexión o canal B del DRV8833, o compensar el duty por rueda hasta que el PID (prueba 18) cierre el lazo |
| 2026-09-30 | 🚨 **`COMPARA M` con el mismo duty da `>COMP_P1:1467` y `>COMP_P2:-849`** ⇒ la rueda derecha **cuenta al revés**: o el **encoder derecho está invertido** (hilos A/B cruzados) o lo está **el motor 2**. Se distinguen mirando hacia dónde gira la rueda; la comprobación limpia es girar la rueda derecha **a mano hacia adelante** con `PPR A MANO` y ver si `>CAL_P2` sube o baja | Si está invertido el **encoder**, afecta a la odometría (creería ir hacia atrás) y al PID (realimentación con el signo cambiado ⇒ inestable), así que hay que arreglarlo **antes** de las pruebas de movimiento. La medida de la desviación (|849| frente a 1467) todavía no vale: con las ruedas en sentidos opuestos el robot derrapa |
| 2026-09-30 | 🎯 **BUG DE RAÍZ ARREGLADO: el encoder de la rueda derecha contaba al revés.** Comprobado girando cada rueda **hacia adelante a mano**: `P1` subía y `P2` bajaba ⇒ el invertido era el **encoder**, no el motor (por eso **no** se cruzan los canales del DRV8833). Arreglo en `sensor/encoder.c`: se invierte `right_diff_count`, para que **positivo = hacia adelante** en las dos ruedas | Explicaba los tres síntomas de la tarde: la **curva** (el frenado por pulsos de `UM MOTORES` no se cumplía nunca, así que la rueda derecha **no paraba**), el **choque** y el **reinicio** que parecía de corriente. Y era una bomba para la odometría (signo) y el PID (realimentación). 📌 Lección: **comprobar el signo de los encoders antes de culpar a los motores** |
| 2026-09-30 | ✅ **Arreglado el signo del encoder derecho** (`PPR A MANO`: `P1` y `P2` suben las dos girando hacia adelante). `UM MOTORES` con las ruedas en el aire da **`P1 4941` y `P2 2964`** con el objetivo en 2800: la **derecha frena donde debe** (2964 = 2800 + inercia) y la **izquierda se pasa 2141 cuentas** ⇒ el **frenado de la izquierda no está cortando el motor**. Quitada la **rampa escalonada** (era la causa de que el motor derecho arrancara 500 ms más tarde y el robot saliera torcido) y añadido `>CAL_P1`/`>CAL_P2` a 10 Hz durante el avance para ver cuál se aplana y cuál sigue | ⚠️ **No se compensan velocidades a lazo abierto todavía**: los números no muestran un motor más lento (la derecha cumple clavada) sino un fallo de frenado en la izquierda; compensar taparía el síntoma. La igualdad de verdad entre ruedas la da el **PID** (prueba 18) |
| 2026-09-30 | 🔎 **Diagnóstico del reinicio de `UM MOTORES`**: **descartada la fuente** (7,4 V **5 A** y se reinicia igual). Se reinicia al **forzarse un motor** (al torcerse y chocar, o al sujetar el robot) y la **rueda derecha gira poco** ⇒ se investiga el motor/rueda derecha (mecánica o conexión al canal B del DRV8833). Añadido a la prueba un **corte por subtensión** (`CAL_VBAT_MIN` = 6 V) que frena y avisa (`VBAT SE CAE`, `>CAL_AVISO:3`) en vez de reiniciarse, y publica `>VBAT` a 10 Hz | Sin este corte, cuando el riel se cae la placa se reinicia y se pierde el diagnóstico. Si se reinicia **sin** el aviso, la causa es ruido eléctrico (⇒ condensadores de desacoplo en los motores) y no una caída sostenida |
| 2026-09-30 | 📏 **`COMPARA M` medido con el robot en el aire: `>COMP_P1:14387`, `>COMP_P2:13093`, `>COMP_DESV:-8`.** Los dos motores con **el mismo duty**: la **izquierda cuenta un 9 % más** que la derecha. En la mesa eso es exactamente el síntoma que se ve: **el robot gira a la derecha**. ❓ Falta el dato que lo cierra: **nunca se ha medido el `PPR A MANO` de la rueda derecha** (hasta hoy no salía por el signo invertido). Si 10 vueltas a mano en la derecha dan ≈2707 pulsos, **los encoders son iguales** y el desvío es del **motor**; si dan ≈2450, **el encoder izquierdo cuenta de más** y compensar con estos números sería un error | Se separa «el motor va más rápido» de «el encoder cuenta más» **antes** de tocar ninguna ganancia. Decidido **no compensar el duty a lazo abierto**: el lazo abierto solo vale para una velocidad y una carga, y la igualdad real la da el **PID** ya escrito en `control/controller.c` (prueba 18) |
| 2026-09-30 | 🔎 **Módulo nuevo `hal/reset.c/h`: la causa del último reinicio.** Lee las banderas de `RCC->CSR` (`RESET_LeerCausa()`) y `APP_InitAll()` las publica al arrancar como `>RESET:n` (1 = tensión/brownout, 2 = pin NRST, 3 = software, 4 = watchdog, 5 = bajo consumo) | Es la herramienta que cierra el diagnóstico del reinicio: el firmware **no tiene watchdog ni llama a `NVIC_SystemReset()`**, y el `HardFault_Handler` **no reinicia** (parpadea el LED onboard a 3 Hz), así que un reinicio espontáneo **solo puede ser eléctrico**. `PORRSTF` (tensión) y `PINRSTF` mandan a sitios distintos: el riel o el cable de NRST. 📌 El caso «se reinicia al **tocarlo con suavidad**» es la pista fuerte: un toque suave **no** bloquea los motores, así que no puede ser corriente |
| 2026-09-30 | ✅ **`PPR A MANO` en la rueda DERECHA: 2707 pulsos en 10 vueltas, igual que la izquierda** ⇒ **los dos encoders son idénticos**. Por tanto el `DESV -8` de `COMPARA M` **es del motor** (el izquierdo gira ~9 % más rápido), no de la cuenta. Y **mover cables no reinicia nada** ⇒ descartado el contacto mecánico. Forzando las ruedas hasta bloquearlas, la fuente marca **243 mA como máximo** ⇒ **descartada la corriente** | Con las dos ruedas medidas y la mecánica descartada, el trabajo se divide: **el 9 %** lo arregla el **PID** (prueba 18, lazo cerrado por rueda) sin compensar duty a lazo abierto; **el reinicio** es un transitorio eléctrico (condensadores en VM / filtro en NRST, `hardware.md` §4.6). 📌 Lección: **medir las dos ruedas antes de concluir que un encoder cuenta distinto** |
| 2026-09-30 | 🛠️ **`UM MOTORES` ya no es imprescindible para calibrar los encoders**: el **modo 1 de la prueba 7** (`PPR A MANO`) calcula también los **µm por cuenta** empujando el robot a mano `CAL_N_VUELTAS` vueltas y apuntando la distancia de la regla en `CAL_DISTANCIA_MEDIDA_MM` (pantalla `UM/C`, telemetría `>CAL_UM_CUENTA`). Y la pantalla de espera de las pruebas de motor muestra la **causa del último reinicio** (`RST n`) | Desbloquea la calibración: mientras el robot no vaya recto y se reinicie al forzar un motor, la pasada con motores no se puede hacer. Además, empujando **no hay deslizamiento de rueda** y la distancia incluye el **aplastamiento del neumático**, así que el µs/cuenta sale mejor que con motores |
| 2026-09-30 | 🔌 **Presupuesto de corriente por riel** (hojas de datos): **9 V** → MT3608 (switch **4 A**) con los dos motores: **1,4 A** de peor caso (*stall* 0,7 A por motor, `ga12-n20-especificaciones.jpg`). **5 V** → MP1584 (**3 A**) con Blue Pill + OLED + encoders: **<0,1 A**. **3,3 V** → AMS1117 de la placa: ≈0,3 A con los cuatro emisores. **Ningún riel va falto de corriente** ⇒ descartada la hipótesis «el boost no entrega» en régimen permanente. Y del `drv8833.pdf`: `IIH`/`IIL` de las entradas `xIN` = **1 µA**, `IVM` = 1,7–3 mA ⇒ **el driver no consume corriente de los PWM** (no hacen falta transistores) | 🎯 El problema del boost **no es la corriente, es que un *boost* no absorbe**: el `Brake` del DRV8833 devuelve la energía del motor al riel de 9 V y **la sube**, con solo **1,8 V de margen** hasta el máximo absoluto de `VM` (11,8 V). **Recomendación: `VM` directo del pack (7,4 V)** y el MT3608 fuera del camino de los motores (está en rango 2,7–10,8 V, la batería absorbe el frenado y es cambiar **un cable**) |
| 2026-09-30 | ✅ **RESUELTO EL REINICIO: era la fuente de laboratorio.** Repitiendo `UM MOTORES` **con la batería LiPo** y parando un motor a mano, **la placa ya no se reinicia**: se para la prueba por el corte de subtensión y sigue. Con la fuente regulada se reiniciaba siempre | El transitorio no era del robot: una fuente de banco tiene el **lazo lento** y su salida se hunde ante un escalón de corriente (y el cable hasta la fuente añade inductancia); una LiPo 2S de 80C a 10 cm no. ➡️ **Regla del banco: los motores se prueban con la batería**; la fuente se queda para medidas de tensión estables (divisores, prueba 12) y pruebas sin motores. 📌 Costó una tarde entera descubrirlo: **sospechar de la instrumentación antes que del robot** |
| 2026-09-30 | ⚠️ **RECTIFICADA en la fila siguiente.** Se atribuyó el desajuste del 15 % µm/cuenta a la goma. Los STEP del repo dan **llanta Ø20** (radio 10, `llanta-no-engranaje-Cuerpo.step`) y **goma Ø20 interior / Ø24 exterior** (`Goma-Goma003.step`), no los «Ø21 con goma» que decía la documentación. Empujando 1 000 mm salieron 3 694 cuentas ⇒ 13,65 vueltas ⇒ **circunferencia efectiva 73,3 mm (Ø23,3)**, por debajo de los 24 de la goma en reposo porque **se aplasta** en el contacto. `CAL_DIAMETRO_RUEDA_MM` corregido a **23,3** y las cotas de la rueda y de la tabla de conversión del encoder actualizadas en `hardware.md` §4.1 y §4.2 | El «nominal» de Ø21 mm daba 235,6 µm/cuenta y el medido es **270,7**: un 15 % de error en cada distancia y cada mm/s del lazo. ⚠️ **Las ruedas actuales entran torcidas en el eje** (lo vio el usuario) y eso infla la medida y mete oscilación una vez por vuelta ⇒ **el usuario las rediseña** (agujero **en D**, cubo más largo, concentricidad y perpendicularidad) y **después hay que repetir la medida** |
| 2026-09-30 | ⚠️ **RECTIFICADA otra vez (ver dos filas más abajo).** Se creyó que la rueda montada no llevaba goma. lo que hay puesto es la **`llanta` con engranaje, de Ø21 mm, PLA duro y sin goma** (diseño anterior), y con el **agujero redondo** (el eje del N20 lleva *D-cut* de 2,5 × 9,5 mm). El diseño nuevo del repo (`llanta-no-engranaje` Ø20 + `Goma` Ø20/Ø24) **no está montado**. Consecuencia: el µm/cuenta de 270,7 **no cuadra** con la geometría (Ø21 ⇒ 66 mm ⇒ **243,7 µm/cuenta**), así que ese 11 % es **patinaje** de la rueda de PLA sin goma (o que rueda sobre el borde por ir torcida), no diámetro. `hardware.md` §4.1 y §4.2 y `CAL_DIAMETRO_RUEDA_MM` corregidos; `ENCODER_UM_POR_CUENTA` **se queda con el nominal** | 📌 **Lección de método: antes de casar modelos 3D con medidas, preguntar qué está montado.** Se dedujo que la rueda llevaba goma a partir del STEP de `Goma`, y la montada es otra. Y esto **refuerza** el rediseño: agujero **en D**, goma para tener tracción y concentricidad. El **valor bueno del µm/cuenta saldrá de la rueda nueva** |
| 2026-09-30 | ⚠️ **RECTIFICADA (ver la última fila): el Ø es 24, no 23.** En su momento se cerró el factor con **Ø23 mm CON GOMA** (dato del usuario, con calibre). Ahora todo encaja: π × 23 = **72,3 mm** de circunferencia y 270,7 cuentas por vuelta ⇒ **≈267 µm/cuenta** teórico frente a los **270,7 medidos** empujando 1 m (1,4 % de diferencia: aplastamiento y tolerancia). El firmware **arranca con el valor medido**: `ENCODER_UM_POR_CUENTA_DEF = 270,7f` nuevo en `sensor/encoder.h` y `RUEDA_DIAMETRO_MM` a 23,0; `ENCODER_UM_POR_CUENTA` (258,0) queda como nominal. `hardware.md` §4.1, §4.2 y el resumen corregidos | Sin esto, la odometría y el PID iban con un factor **5 % bajo**. El agujero **redondo** sobre el eje con *D-cut* sigue siendo el problema a arreglar en el rediseño: es lo que hace que la rueda se incline y que la velocidad oscile una vez por vuelta. 📌 **Lección: preguntar con qué está montado antes de casar un modelo 3D con una medida** (hoy pasó dos veces: la fuente y la rueda) |
| 2026-09-30 | 🔋 **Celda 1: una $k$ por canal.** El usuario montó **3k9/10k** en el divisor de la celda (el pack lleva 22k/10k) y el firmware, que usaba **una sola $k$**, dividía la celda por el factor del pack: la celda 1 salía ≈9 V y la celda 2 —que sale por **resta**— daba **−1,29 V** con 2,733 V reales en el pin, disparando un aviso de batería inexistente. Arreglado con `BAT_K_DIVISOR_PACK_DEF` (0,3015) y `BAT_K_DIVISOR_CELDA_DEF` (**0,6941** = 0,7194 teórico corregido por el mismo factor del ADC), `BATTERY_CalibrarConPack()` reescala también la celda, y **una comprobación de coherencia** evita clasificar por celdas cuando la resta no cuadra (los valores crudos se siguen publicando) | El aviso de batería habría estado encendido para siempre con divisores asimétricos, y en el banco con fuente la celda 2 negativa daba un FAULT falso. 📌 **Lección: una sola constante solo vale si los dos divisores son idénticos** — y aquí no lo son |
| 2026-09-30 | 🔔 **Umbrales de batería bajados a 3,30 V/celda**, por petición del usuario: `AVISO_PACK` de 7,00 a **6,60 V**, `AVISO_CELDA` de 3,45 a **3,30 V**, `CRIT_PACK` de 6,60 a **6,00 V** y `DESEQ` de 0,15 a **0,40 V**. Y la pantalla de la prueba 12 enseña ya **el estado y las tres tensiones** (antes solo se pintaba sin aviso, así que con un aviso de celda desaparecía el total) | Con las celdas a 3,80 y 3,97 V (batería sana) el robot se pasaba el rato en AVISO y **parpadeaba entre OK y AVISO**: el desequilibrio de 0,17 V rozaba el umbral de 0,15 V y el ruido del ADC (±20 mV) lo cruzaba. ⚠️ El crítico se baja a 6,00 V para que el aviso no quede tapado por el FAULT, que se comprueba antes |
| 2026-09-30 | 🔋 **Prueba 12 completa: pack 7,77 V · celda 1 3,80 V · celda 2 3,97 V**, con los divisores definitivos (22 kΩ/10 kΩ y 3k9/10 kΩ) y una $k$ por canal | Las tres tensiones cuadran con el multímetro y el desequilibrio (0,17 V) es real: la batería pide un **ciclo de balanceo** |
| 2026-09-30 | 🛞 **RECTIFICADO EL DIÁMETRO DE RUEDA: es Ø24 mm con goma, no Ø23.** La medida de Ø23 era errónea (``esta tarde debo haber medido mal el diámetro, porque la llanta y la goma son iguales'', dijo el usuario), y el STEP de la goma era **orientativo**, no medido. Con **Ø24** el modelo y la medida **se confirman mutuamente**: nominal = π × 24 × 1000/280 = **269,3 µm/cuenta** y medido empujando 1 m = **270,7** ⇒ **0,5 %** de diferencia (que es el aplastamiento de la goma: el Ø efectivo de rodadura son **23,3 mm**, un 2,8 % menos). `RUEDA_DIAMETRO_MM` y `CAL_DIAMETRO_RUEDA_MM` puestos a **24,0**; corregidos `hardware.md` §4.1/§4.2, `mechanical/README.md`, `sensor/encoders.md` | ✅ **El factor 270,7 queda validado por dos vías independientes** (la medida empujando y la geometría), que es justo lo que no pasaba con el Ø21 viejo (daba 235,6, un 13 % bajo). Y las **ruedas nuevas están montadas**: llanta Ø20 con **agujero en D** de Ø3,15, goma Ø24 y ancho 8 mm (§5 de `mechanical/README.md`) |

| 2026-09-30 | 🧭 **Contador de posición en la cabecera del menú** (`menu_dibujar_cabecera()`): si la lista no cabe entera (`n > MENU_FILAS_VISIBLES`), el título va seguido de `i/n` — `TEST MOTORES 8/11`. Corregido de paso que [maquina-estados-menu.md](./maquina-estados-menu.md) decía que el cursor se marca con `-` cuando el código usa `>` | El usuario **no encontraba la prueba 19**: `TEST → MOTORES` tiene **11 entradas** y la OLED enseña **3**, y como las listas **dan la vuelta** por los extremos no había ni un indicio de que quedara algo por debajo. Las pruebas nuevas caen al final de la lista, que es justo donde nadie mira |
| 2026-09-30 | 📐 **Pantalla para la prueba 19** (`app_pantalla_odometria()`, refresco a 5 Hz): `D` (camino en mm), `ANG` (grados) y `X`; `OK` repinta al instante al poner el origen a cero. La `Y` y los µm de cada rueda siguen solo en telemetría | Era **la única prueba que no escribía nada en la OLED**: su cartel se quedaba fijo y parecía que OK no había hecho nada. ⚠️ La fuente de `oled.c` no tiene glifo de `H`, `Y` ni `Z`, así que el ángulo va como `ANG` (no `TH`) y la `Y` no se puede escribir |

| 2026-10-01 | 📐 **Trocha efectiva medida: 77,6 mm** (`ODOM_TROCHA_MM_DEF`, era 83,6 = distancia entre ejes de motor). Con la prueba 19, un giro de 90° a mano se estimaba en **83° y −84°** —7 % corto y con el **mismo sesgo en los dos sentidos**— ⇒ $L = 83{,}6 \times 83{,}5/90 = 77{,}6$. Sale **menor que la geométrica**, como corresponde a ruedas que arrastran al pivotar. Actualizados `hardware.md` (§4.1 tabla + aviso reescrito), `odometria.md` §6, `cinemáticas.md` §4.1, `pruebas-bringup.md` (§3, §6 y §15), `mechanical/README.md`, `README.md` y los digests del skill | ⚠️ **Un error del 7 % en los giros hacía inservible todo lo que venga después** (giros de 90°, muros, flood fill), y el sesgo simétrico descartaba los encoders: el único parámetro que queda en $\Delta\theta = \Delta s/L$ es $L$. 📌 **Lección: un parámetro geométrico no se mide con el calibre, se deduce del comportamiento del robot** |
| 2026-10-01 | ✅ **El factor de 287,0 µm/cuenta queda validado**: empujando 1 m recto, `>ODO_D` da **997 y 995 mm** (−0,3 % y −0,5 %). Se cierra la duda de si la mesa inflaba la medida (que habría bajado el factor a ≈270). También se confirma que **los dos encoders van en el mismo sentido** (θ positivo al girar a la izquierda y negativo a la derecha) | El factor venía de una única pasada recta de la prueba 7 y se sospechaba del roce con la mesa; ahora está **confirmado por una vía independiente** (la prueba 19). Se deja el valor sin tocar: un −0,3 % está dentro del ruido de la marca del suelo |

| 2026-10-01 | ✅ **Giro de 90° confirmado con la trocha nueva: +90° y −90°**, clavados a mano. Se cumple el criterio de la prueba (< 2° de error) en una sola iteración de ajuste | El valor de 77,6 mm era una **predicción** (83,6 × 83,5/90); ahora está **verificado en el robot**. La odometría ya sirve de base para los giros de 90° y el *wall follower*, que era el objetivo de la prueba |

| 2026-10-01 | 🎛️ **La prueba 18 (PID) se sintoniza en caliente por consola**: orden nueva `PID KP\|KI\|KD <valor>` / `PID VEL <mm/s>` / `PID LIST`, con los `#define` convertidos en variables de arranque (`PID_TEST_*_DEF`). API en la APP (`APP_PID_SetGanancia()`) y el lazo aplica el cambio con `CTRL_SetGanancias()` en su paso siguiente; **hay que llamar a `CONSOLE_Update()` dentro del bucle de la prueba**, que es bloqueante. Añadida también la **pantalla** de la prueba 18 (`SET`, las dos velocidades, los dos duties y `KP`/`KI`) | Ziegler-Nichols exige **barrer `Kp` muchas veces**: sin esto, cada tanteo es recompilar + flashear + un reinicio que **borra la observación en curso**. Es el mismo motivo por el que los umbrales de batería son ajustables en caliente. Con la pantalla, la prueba deja de parecer colgada |

| 2026-10-01 | 📐 **La prueba 19 se puede usar sin Teleplot**: la pantalla muestra `D` (camino), `ANG` (ángulo) y **`CIE`** (cierre, distancia al origen = $\sqrt{X^2+Y^2}$), y **UP congela** la lectura para apuntarla. Motivo: al hacer el cuadrado el robot va **en el suelo**, y ahí el cable de la UART estorba → la prueba quedaba inservible justo cuando más falta hacía. Se publica `>ODO_HOLD` (0/1) | El cierre es además lo único que cabe en pantalla: la fuente de `app/oled.c` **no tiene glifo de `Y`**, así que la posición en X/Y no se puede escribir y hay que darla como distancia al origen |

| 2026-10-01 | 🚶 **Primitivas de movimiento escritas** (`app/motion.c/h`, capa APP): `MOTION_Avanzar(mm)` y `MOTION_Girar(grados)`, con lazo cerrado sobre la odometría y **corrector de rumbo** al avanzar. Banco nuevo: **prueba 20 `MOVIMIENTO`** (OK avanza 180 mm, UP/DOWN giran ±90°, y la pantalla da el **error acumulado**, que es lo que dice si los errores se suman o se cancelan). Las ganancias del lazo de velocidad **no se duplican**: se cogen de la prueba 18 | Sin ellas no hay *wall follower* ni *flood fill*: son el cuello de botella de todo lo que queda. Se hacen **bloqueantes y despacio** porque aquí lo que importa no es la velocidad, es que 180 mm sean 180 mm y 90° sean 90° **hoy y con la batería a la mitad**. ⚠️ El **mínimo de velocidad al girar** (`MOTION_GIRO_VEL_MIN_MM_S`) es la constante crítica: por debajo de ella el duty no vence la fricción estática y el robot se queda a medio giro |

| 2026-10-01 | 🧱 **Detección de paredes** (`app/walls.c/h`) con **umbral por pared ajustable sin cable** (prueba 21 `PAREDES`: OK cambia de pared, UP/DOWN el umbral). La medida es `encendido − apagado`, así que **no depende de la luz de la sala**, y el veredicto lleva **histéresis** (60 cuentas) para que no parpadee con una medida que oscila alrededor del corte | El laberinto del sábado es **ajeno**: si sus paredes no reflejan como las de casa, el umbral de casa no vale, y **allí no se puede calibrar con el portátil enchufado**. El ajuste con botones es la única forma de dejarlo bien en dos minutos. ⚠️ Deuda anotada: la conmutación de emisores está duplicada respecto a la de `application.c`; lo suyo es que la medida cruda viva en `sensor/ir.c` |

| 2026-10-01 | ⚡ **BUG GORDO: la velocidad del encoder estaba cuantizada a 287 mm/s.** `update_encoder_readings()` calculaba `v = cuentas_del_último_ms × 287 µm × 1000 Hz`, así que **cada cuenta valía 287 mm/s**: a 300 mm/s (≈1,05 cuentas por ms) la medida saltaba entre **0, 287 y 574 mm/s**. Arreglado con una **media móvil de 20 muestras** (≈14 mm/s de resolución, ~10 ms de retardo) que promedia **cuentas y tiempo medido**, no velocidades ya calculadas, para que salga bien tanto a 1 kHz (el lazo) como a 100 Hz (las primitivas) | El PID no estaba mal sintonizado: **la realimentación era ruido** y el motor iba a bandazos (“se mueve completamente aleatorio”). ⚠️ El `dt` también se **suponía** constante (1 ms) cuando no lo era: en `app/motion.c` se llama cada 10 ms y la velocidad salía **10 veces menor**. Ahora el `dt` se mide con el reloj |

| 2026-10-01 | 🎯 **Modo 3 de la prueba 18: barrido automático de `Kp` para encontrar `Ku`.** Escalón **único** (el modo 1 alternaba cada 2 s y **cortaba la oscilación** justo cuando hay que ver si es sostenida), `Kp` subiendo 0,05 cada 3 s y medida de la **amplitud pico a pico**; cuando supera el 40 % de la consigna se para, publica `>PID_KU`/`>PID_TU` y deja puesta la `Kp = 0,6·Ku` | El usuario no tenía claro qué buscaba (“¿hasta que se mueva suave?”): **en Ziegler-Nichols no se busca suavidad, sino el punto de oscilación sostenida**. Y hacer el barrido a mano son 10-15 tanteos mirando cada uno |
| 2026-10-01 | 🐛 **BUG DE RAÍZ ARREGLADO: el integrador del PID no se reseteaba al cambiar ganancias.** `pid->integrador` guarda un **término de SALIDA en %**, no un acumulador del error: con `Ki = 0` deja de acumular pero **conserva su valor** y ese valor **sigue sumándose a la salida**. Consecuencia real: «dejar solo la P» **no dejaba solo la P**, y con `KP = KI = KD = 0` el duty seguía en 17,6 % y 60 % en vez de irse a cero. `PID_SetGanancias()` ahora llama a `PID_Reset()` | Se descubrió **leyendo el puerto serie desde el PC** (`PID LIST` devolvía `>PID_KP:0.000` pero el duty no bajaba). La tarde entera de sintonía estaba contaminada por ese duty fantasma |
| 2026-10-01 | 🎯 **El motor invertido era SOLO el izquierdo** (no los dos). Medido **en régimen** (con el integrador congelado, que da duty constante): `>DUTY_IZQ:+17,6 → >VEL_IZQ:+667` (**bien**) y `>DUTY_DER:+60 → >VEL_DER:-2500` (**invertido**). Arreglo: `motor1.invertido = 1`, `motor2.invertido = 0` — en un diferencial los motores van **en espejo**, así que **solo uno** necesita inversión | El diagnóstico anterior, hecho sobre una captura de Teleplot, era **precipitado**: eran datos de un lazo **oscilando** y el duty y la velocidad no estaban correlacionados en el mismo instante. **Lección de método: no se diagnostica un lazo oscilando; para averiguar un signo hay que congelar el lazo y medir en régimen.** ⚠️ Y ojo: cruzar los canales del PWM e invertir el signo son **la misma** inversión; hacer las dos a la vez se cancela |
| 2026-10-01 | ✅ **PID de velocidad SINTONIZADO: `Kp = 0,10` · `Ki = 0,50` · `Kd = 0,00`.** Método: **respuesta al escalón** (Ziegler-Nichols queda descartado, ver la fila del modo 3). Planta medida: `K ≈ 15 mm/s` por 1 % de duty, `tau ≈ 45 ms`. Resultado: **298,5 mm/s de mediana pidiendo 300 (0,5 % de error)**, asentamiento 0,6 s. Lo que limita `Kp` es el **retardo del lazo** (~25 ms: la media móvil del encoder + los 10 ms del lazo), que agota el margen en `Kp ≈ 0,2` — con 0,3 el lazo **satura y las dos ruedas se desincronizan**. Como `Kp` no puede subir, **el error de régimen lo quita el integrador** (con solo la P se quedaba en 180 mm/s, un 40 % de error). Valores grabados en `PID_TEST_*_DEF` para que el robot **nazca** con ellos | Las ganancias de la consola viven en **RAM y se pierden al apagar**: para el evento del sábado el robot tiene que arrancar ya sintonizado |
| 2026-10-01 | 🔌 **El agente lee el puerto serie del robot desde el PC** (`/dev/ttyUSB0`, adaptador Prolific, con `pyserial` del venv de PlatformIO): lee la telemetría **y manda órdenes** en el mismo script, así que la sintonía es un lazo cerrado desde el PC. Requiere que el usuario **cierre Teleplot** (un puerto serie solo lo abre un programa; se comprueba con `fuser -v /dev/ttyUSB0`) | ⚠️ El **ST-Link v2 original no expone puerto serie virtual** (solo el V2-1), así que por SWD no hay telemetría en vivo: la única vía es el adaptador USB-Serie |

| 2026-10-01 | 🎛️ **Orden `MOV` de la consola: las primitivas de movimiento se manejan a distancia** (`MOV OK\|UP\|DOWN [n]`). La consola deja la petición escrita en la APP (`APP_MOV_Pedir()`), el bucle de la prueba 20 llama a `CONSOLE_Update()` y la recoge (`APP_MOV_Recoger()`), y **botones y consola llaman al mismo `mov_test_ejecutar()`** | Las primitivas son **bloqueantes** y los botones son físicos: un cuadrado de cuatro celdas y cuatro giros son ocho pulsaciones que hay que repetir enteras cada vez que se toca una constante de `app/motion.h`. Con esto las pruebas se guionizan desde el PC, que es lo que hacía falta para llegar al laberinto del sábado |
| 2026-10-01 | 🐛 **BUG DE PRESENTACIÓN ARREGLADO en la prueba 20: `MOV_E_ANG` salía −360° a partir del tercer giro.** La odometría normaliza $\theta$ a $(-180, 180]$ (girando a la izquierda: 90 → 180 → **−90** → 0) y el error se calculaba restando el teórico acumulado, así que el desfase era de una vuelta **con el robot perfecto**. Se normaliza la diferencia (`mov_test_error_angulo()`) | El giro nunca estuvo mal (`MOTION_Girar()` ya normaliza su objetivo): era solo el número que se enseña, y habría hecho creer que la prueba suspende cuando aprueba. Mismo tipo de trampa que en la prueba 19 con la `Y` |

| 2026-10-01 | 🔴 **PRIMERA PASADA DE LA PRUEBA 20 Y BUG GORDO ENCONTRADO: el corrector de rumbo de `MOTION_Avanzar()` tenía el signo al revés.** La celda de 180 mm terminó con `>MOV_E_D:+53,6` y **`>MOV_ANG:35,8°`**: el robot **se fue en curva**. Causa: `motion_paso(m, vel + correccion, vel - correccion, …)` — con $\theta$ positivo = izquierda, y $d\theta = (ds_{der} - ds_{izq})/L$, sumarle la corrección a la izquierda **y restársela a la derecha** refuerza el desvío en vez de corregirlo. Es decir, **realimentación positiva**: $\dot\theta = (2K_p/L)\\,\theta$, un crecimiento $e^{4,43t}$, y cualquier desvío inicial —por pequeño que sea— acaba en decenas de grados. Arreglado **intercambiando los dos argumentos** | ⚠️ Es de los que **no se ven leyendo el código**: el signo «parece» razonable y el error se manifiesta como un robot que se va torcido, que es justo lo que se achaca al rozamiento o a los motores. Lo encontró **medir con motores**, no empujar a mano. 📌 Y es la justificación de la orden `MOV`: la prueba se pudo lanzar y medir **sin nadie delante**, con el robot en la mesa, y el dato de los 35,8° no habría salido de un «creo que se va un poco» |
| 2026-10-01 | ✅ **El corrector de rumbo de `MOTION_Avanzar()`, arreglado y verificado: la celda pasa de 35,8° / 100,7° de desvío a `>MOV_ANG:-2,5°`.** Medido en el suelo con la orden `MOV OK`: `D 196,6` · `ANG -2,5` · `OK 1`. Se añadió también `seguridad`: el error de rumbo se **normaliza** con `motion_error_angulo()`, porque `theta_0` y `odo.theta` están las dos en $(-\pi,\pi]$ y restarlas en crudo puede dar un salto de $2\pi$ — con el robot a 170° la corrección pedía diez veces la velocidad máxima | La primera pasada dio **35,8°** y la segunda **100,7°** para el **mismo comando**: esa dispersión es la firma de una **realimentación positiva** ($e^{4,43t}$), porque el ángulo final depende de un desvío inicial diminuto. Un lazo con el signo bien da siempre lo mismo |
| 2026-10-01 | 🐛 **La celda se pasaba 16,6 mm, y era el integrador del PID.** El movimiento no termina cuando la consigna llega a cero: el integrador, que valia ~13 % de duty para mantener la velocidad de salida, se descarga a `Ki·error` ≈ 25 %/s y **sigue empujando ~0,4 s más**, y la odometria lo sigue contando. Añadido `MOTION_FRENADA_MM` (19,6 mm medidos, que se descuentan del objetivo) | `196,6 = 177 (donde cortó el lazo) + 19,6 (la frenada)`. El número encaja **exacto**, así que no era ni la odometria ni el µm/cuenta: era el lazo siguiendo una consigna que ya era cero |
| 2026-10-01 | 🔬 **Los giros medidos son de fiar a partir de ahora: el guion del PC se comía líneas de telemetria.** Cuando se perdía un `>MOV_D`, el parser mezclaba dos movimientos en un grupo y **se saltaba una impresión**, dando deltas que parecian plausibles pero no lo eran ("3 de 4 movimientos" sin avisar). Reescrito el guion para leer bytes, partir por saltos de linea con buffer propio y **validar que cada movimiento trae sus cinco valores** | Un instrumento que no avisa cuando le falta un dato es peor que no tenerlo: los "giros erráticos" de −15°, −85°, −117° **no se pueden atribuir al firmware** hasta repetir la medida con el guion corregido |

| 2026-10-01 | ✅✅ **LA CELDA CUADRA: 178–181 mm, y `>MOV_X` vuelve a −11 mm.** Medido en el suelo: ocho movimientos entre **177,7 y 181,1 mm** (error ≤ 2,3 mm, criterio < 5 mm) y la deriva de rumbo durante el avance **+0,2° por celda** (antes +2…+9°). Ida y vuelta de dos celdas: **vuelve al sitio** | ⚠️ **La causa era el rodaje del asentamiento, no la odometría.** Descontar la frenada no servía (medida en cuatro celdas salió de 2, 20 y 44 mm, porque depende de cuánto le quedara al integrador). Lo que había que quitar era **el empuje del integrador después de llegar**: `CTRL_Parar()` + freno dinámico en `motion_asentar()` |
| 2026-10-01 | 🐛 **BUG ARREGLADO: `MOTION_Avanzar()` con distancia negativa no movía una rueda — y estaba roto por dos sitios.** **(1)** `falta_mm <= MOTION_TOL_MM` con `falta_mm` empezando en −180 ⇒ `−180 <= 3` ⇒ se daba por llegado en la primera vuelta. **(2)** El tope inferior `vel < MOTION_AVANCE_VEL_MIN_MM_S` convertía cualquier velocidad negativa en **+50**, y el cambio de signo posterior la dejaba en −50 ⇒ **retrocedía siempre a la velocidad mínima**, ignorando lo que le faltara. Arreglado con `fabsf(falta_mm)` y recortando los topes por los dos lados | ⚠️ **Retroceder no se había probado nunca**, y el código *parecía* contemplarlo (`if (mm < 0) vel = -vel;`). Una rama que solo se puede ejercitar con un argumento que nadie pasa está **sin probar por mucho que esté escrita** |
| 2026-10-01 | ➕ **Orden `MOV BACK [n]` y telemetría `>MOV_X` / `>MOV_Y`.** El retroceso **no tiene botón** (la prueba no tiene un cuarto botón libre) y existe para hacer ida y vuelta sin que el robot acabe cruzando la mesa. La posición hacía falta porque `>MOV_D` es el **camino recorrido** y solo sube: en una ida y vuelta vale el doble y no dice si el robot ha vuelto | Las dos cosas las pidió el usuario por el mismo motivo práctico: **el cable tira y el robot acaba contra el monitor del PC** |
| 2026-10-01 | ⚠️ **Residuo conocido de los giros: se desplazan ~15-19 mm y el ángulo sale ±4-7°.** Con el asentamiento frenando pasan de **+109° a +83,3° / +90,7°**, pero siguen trasladándose ~15 mm. Causa: **asimetría en el transitorio de arranque y frenada** (una rueda responde antes que la otra), y el corrector de centro es proporcional a lo ya desplazado, así que **reacciona tarde**. Pendiente: subir `MOTION_GIRO_CENTRO_KP` o añadir un integral | Para el *wall follower* del sábado es tolerable —las paredes corrigen la posición— pero es el siguiente número a mejorar. Medido: la vuelta de 360 mm acaba con `Y` desviada +36 mm, y de ahí sale la mayor parte |

| 2026-10-01 | 🧭 **`app/wall_follower.c` + prueba 22: el algoritmo de la mano.** Va en **EXPLORE**, no en TEST (es navegación, no banco). Decide en el **centro de la celda** con `WALLS_Hay()` y ejecuta con `MOTION_Avanzar`/`MOTION_Girar`; **se para sola si un avance agota sus 8 s sin llegar** (`>WF_ATASCO:1`). La **traza** se amplía con un cuarto canal (`>TR_EXTRA`) y graba **una muestra por celda**: es lo único que permite depurar un recorrido que se hace **sin cable** | ⚠️ **No se puede probar sobre la mesa**: necesita un laberinto o al menos un pasillo con cruces. Y la protección de atasco no es un adorno: sin ella, un umbral mal puesto hace que el robot «recorra» un laberinto que no existe, sin avanzar, hasta quedarse sin batería |
| 2026-10-01 | 🔌 **Módulo ESP8266 por AT (`hal/esp8266.c`) + prueba 23.** Va en HAL por el mismo motivo que `hal/drv8833.c`: es un chip de fuera gobernado por un periférico del MCU. La prueba manda `AT`, `AT+CWMODE=1` y `AT+CWLAP`, y enseña las redes en la pantalla (en mayúsculas y con puntos, porque la fuente de `oled.c` no tiene minúsculas ni `H/J/Q/Y/Z`) | **Es la única prueba que NO publica telemetría**, y es a propósito: el módulo ocupa la **USART3**, que comparten la telemetría y la consola, así que publicar sería mandarle `>ETIQUETA:valor` al ESP y leer sus respuestas como si fueran órdenes. Con el módulo puesto ya **no hay cable al PC**, y por eso el resultado sale solo en la pantalla |
| 2026-10-02 | ✅ **Puente WiFi transparente (prueba 24): el robot ya se controla y se mira SIN CABLE.** El ESP8266 se pone en modo transparente (`AT+CIPMODE=1`) y la **USART3 entera viaja por TCP** hasta un servidor de banco en el PC: la telemetría sale hacia fuera y las órdenes entran hacia dentro. Latido `>PUENTE_T` a **1 Hz** para saber que el enlace vive. Está en **TEST → VARIOS → WIFI AL PC**, *antes* del test del ESP: la prueba 23 averigua si el módulo habla y esta lo pone a trabajar. Los datos de la red (SSID, clave e IP del PC) van en `firmware/include/wifi_secrets.h`, que está **en `.gitignore`** —hay plantilla `wifi_secrets.h.example` versionada— porque lleva la contraseña | **Es lo que hacía falta para el sábado**: el objetivo es «moverse sin chocar» y el cable estorbaba justo en el suelo. Comprobado en los dos sentidos (`BAT LIST` y `>VBAT:7.394` leídos por WiFi, robot en **192.168.2.198**). Se descubre además que **el módulo se reconecta solo** al reiniciar el servidor del PC, así que no hay que volver a pulsar OK |
| 2026-10-02 | 🐛 **DOS BUGS ARREGLADOS, y los dos solo se veían con el módulo puesto.** **(1) Bucle de eco**: el ESP8266 **viene con `ATE1`** y repite todo lo que recibe; como la telemetría va por la **misma línea**, el STM32 oía su propia salida, la interpretaba como orden y volvía a contestar — `>CMD_ERR:4` rebotando, `REDES 0` y botones muertos. Arreglado **por los dos lados**: `ATE0` en `ESP_Preparar()` y la consola **ignorando las líneas que empiezan por `>`**. **(2) `FALLO EN ATE0` con el módulo contestando `OK`**: `esp_linea[]` no llevaba terminador **en cada byte**, así que quedaba el rabo de la anterior y `OK` + `E0` se leía como **`OKE0`** | Con `AT` funcionaba **por casualidad**, porque las dos cadenas miden lo mismo. Lo cazó la pantalla al enseñar la respuesta **en crudo**: por eso el veredicto de fallo lleva debajo lo que contestó el módulo |
| 2026-10-02 | ⚖️ **Recorte de Flash: 88,3 % → 74,2 % (−9 212 B), sin un solo aviso de compilación.** Se desconectan catorce pruebas de banco **ya validadas y sin uso previsto** (2, 3, 4, 5, 6, 7, 9, 10, 11, 12, 13, 14, 15 y 19) **comentando su fila del menú**, que es lo que libera la Flash: con `-ffunction-sections` + `--gc-sections`, una función que nadie referencia **se queda fuera del binario**. Los **cuerpos se quedan compilados**, con su Doxygen, a un descomentario de distancia. Se conservan `ADC` (prueba 1, pendiente de revalidar a 4 canales) y `BUS I2C` (el diagnóstico si la OLED no responde) para que **ninguna tabla quede vacía y no haya que renumerar `submenus[]`**, cuyos índices son un contrato | ⚠️ El código de banco ocupaba **~23 KB**, un tercio del mapa, cuando el sábado solo hace falta *moverse sin chocar*. Verificado en el ELF: de todas las funciones de banco quedan **diez `App_Test_*`** (1, 11, 16, 17, 18, 20, 21, 22, 23 y 24) más sus seis pantallas |
| 2026-10-02 | 🐛 **La prueba 8 (botones) nunca fue ejecutable.** `App_Test_Botones()` estaba declarada y definida pero **no figuraba en ningún menú**, así que el enlazador la llevaba tirando desde el principio: figuraba como «pendiente» cuando en realidad **no había forma de lanzarla**. Aparece al medir qué funciones están de verdad en el ELF | Se veía venir de que **nunca se anotó** en el registro de resultados pese a que los botones funcionan toda la noche. **Una prueba que no está en el menú no está en el firmware**, por mucho que el `.c` la tenga |
| 2026-10-02 | ❌ **`-flto`: se probó, liberaba 5 372 B (74,2 % → 66,0 %) y hubo que QUITARLO el mismo día, porque ROMPE LAS INTERRUPCIONES.** ⚠️ **NO PONERLO.** Los manejadores que define `src/main.c` son overrides de funciones `__weak` de la HAL, y esas `__weak` vienen **dentro del `.a` del framework**: el LTO resuelve el conflicto **al revés** y el vector table acaba apuntando **todos** los manejadores a `Default_Handler`. Sin `HAL_IncTick()` **`HAL_Delay()` se cuelga**, y el robot **se queda mudo en el arranque** (ni los tres destellos del LED); sin EXTI no hay botón MENU y sin USART3 no hay consola. **Compilaba sin un solo aviso** | ⚠️ **Diagnóstico sin flashear, y obligatorio antes de dar por bueno un cambio de enlazado**: `arm-none-eabi-nm firmware.elf \| grep -E "_IRQHandler\|_Handler"`. Los del proyecto tienen que salir **`T`** y **cada uno en su dirección**; si salen **`W`** y **todos en la misma**, están en el stub y no existen. Comparado: `SysTick_Handler` pasa de `T 08007aa0` a `W 08008818`. **Lección: medir el tamaño no es medir la corrección** |\n| 2026-10-02 | 📏 **Medido lo que cuesta el `%f`: 8 596 B, el 13 % de la Flash** (sin él el firmware se queda en **34 676 B = 52,9 %**). No lo usa solo la telemetría: lo usan las **pantallas de la OLED** (`%.2f V`, las ganancias del PID, `UM/C`, `PPR`), así que no es cuestión de quitar una opción sino de **formatear con enteros** (`%d.%02d`) y cambiar `%f` por `%s` | **Queda como grifo pendiente y no se toca ahora**: con el **74,2 %** hay 16,9 KB libres, y es un refactor con **salida visible** (todas las pantallas), que es justo lo que no apetece la víspera del evento. Es el mayor ahorro que queda |
| 2026-10-02 | 🐛 **«El botón OK no hace nada» en la prueba 21: era el SONDEO, no el botón.** El bucle miraba los botones cada `WALLS_PANTALLA_MS` = **250 ms**, con el antirrebote en **30 ms**: una pulsación corta caía **entre dos muestreos** y el firmware **no llegaba a ver el nivel pulsado**. Arreglado **separando los dos ritmos**: botones a **100 Hz** (`WALLS_PANTALLA_PASO_MS` = 10 ms) y pantalla a 4 Hz, porque el `OLED_Update()` se lleva ~50 ms por I²C. El ritmo lento era de la pantalla y se había contagiado a la lectura de botones | ⚠️ **No afecta a MENU**, que va por **interrupción** y por eso responde siempre — y eso es lo que despistaba. Sí afecta a OK/UP/DOWN de cualquier prueba que sondee más despacio que el antirrebote. **Si un botón «no hace nada» en el banco, mirar la cadencia del bucle antes de sospechar del hardware** |
| 2026-10-02 | 🐛 **En `IR MODULADO` solo se veían R0, R1 y R2: faltaba el `R3`.** `app_pantalla_modulado()` pintaba **una fila por canal** (1, 2, 3 y 4) y la OLED es 128×32 ⇒ **solo hay 4 filas (0..3)**: el `R3` caía en la **fila 4** y `OLED_Print()` **sale sin dibujar nada** (`y >= OLED_ALTO`) **en silencio, sin error ni aviso**. Arreglado **de dos en dos** —`R0 1250  R1 1240` / `R2 1350  R3 1600`— y **quitando el `VAR`** de la pantalla (para seguir el `DIF` estorbaba; como indicador sigue en telemetría) | ⚠️ **Regla nueva, anotada en el Doxygen de `oled_print_line()`: solo hay 4 filas; de la 4 en adelante el texto desaparece sin decir nada.** El mismo defecto tenía la pantalla de la prueba 13, con `VER TELEPLOT` y `MENU: SALIR` en las filas 4 y 5: nunca se vieron y se han borrado (allí las cuatro filas ya están ocupadas) |
| 2026-10-02 | 🔎 **La prueba 17 (curva distancia↔ADC) mide luz ambiente, no reflejo: los emisores están apagados.** `App_Test_CalibracionIR()` y `ir_cal_guardar_punto()` leen con un `adc_leer_media()` **pelado** y **en todo el fichero no hay una sola llamada a `ir_emisor_seleccionar()` entre el `while` de la prueba** (la única está al salir, apagándolos). Y como la 14 y la 16 también los apagan al salir, **al entrar en la 17 los cuatro están apagados**: la `tabla[][]` que se guarda es de fondo, y una curva de fondo no depende de la distancia. En el registro se ve: `>R0_CAL` = 4, 8, 14, 15, 15 (una pasada) y 0, 0, 0 (otra), todas a **emisores apagados** (3, 5 y 8 cm). | ⚠️ **Los números de la «curva IR» que se dieron por hechos no valen**: la curva hay que rehacerla con el emisor del canal encendido, que es un cambio de dos líneas en `ir_cal_guardar_punto()` (encender `ir_pareja_emisor[canal]` antes de leer y apagarlo después). No está en el camino crítico del sábado —los umbrales de pared salen de la prueba 21— pero invalida lo ya medido ✅ **ARREGLADO el mismo día**: helper nuevo `ir_cal_emisor(canal)` que enciende la pareja del canal **al entrar**, **al cambiar de canal** con `UP`/`DOWN` y **antes de congelar cada punto**, más el modo vivo (`ir_cal_estimar_vivo()`) conmutando por canal antes de cada lectura; al salir con `MENU` se apagan los cuatro |
| 2026-10-02 | 🐛 **El *wall follower* llamaba «atasco» a una parada con MENU.** `MOTION_Avanzar()` devuelve **0 tanto si agota los 8 s** (`MOTION_TIMEOUT_MS`) **como si se pulsa MENU** —el `break` de `BUTTONS_SalidaSolicitada()` deja `llegado` a 0— y `WF_Paso()` hacía `wf_atascado = 1U` sin mirar quién había cortado. Como MENU es **la forma normal de parar el robot**, la pantalla iba a decir `PARADO: ATASCO` (y `>WF_ATASCO:1`) cada vez que el usuario lo parase a mano, que es justo el diagnóstico que existe para distinguir un choque de una parada voluntaria. Arreglo: `wf_atascado = (BUTTONS_SalidaSolicitada() != 0U) ? 0U : 1U;` | ⚠️ Se encontró **leyendo** `motion.c` (el `@return 1 si llegó … 0 si agotó el tiempo **o se pidió salir**` del Doxygen lo delata), no ejecutándolo: **la prueba 22 nunca se ha corrido en hardware**. 📌 Lección: cuando una función devuelve un código de error, hay que mirar **si hay más de un motivo** para ese mismo código antes de etiquetarlo |
| 2026-10-02 | 🔬 **Medido con pared blanca de madera: R0 FUNCIONA y R3 SATURA.** Con el fototransistor de PA2 girado, R0 pasa de `OFF 184 · DIF +166` (al aire) a `OFF 2049 · ON 3473 · **DIF +1424**` con la pared delante: **contraste 8,6×** y estable al ±0,5 % en 47 ciclos. ⇒ **Se retira la sospecha de «R0 muerto»**, y de paso la de que el giro fuese la causa: el registro de la mañana ya tenía `R0_DIF` hasta 1390, así que lo que se puede afirmar es que **el canal vale ahora**, no que estuviera roto antes. Y aparece lo contrario de lo esperado: **R3 (el frontal que sí daba buena cuenta) está saturado**, con el `ON` a **3889 de 4095 = 95 %** y el `DIF` que incluso **baja** (1208 → 1026) cuando le llega más luz | ⚠️ Con luz fuerte el frontal que pierde sensibilidad es **R3**, no R0: su punto de trabajo está pegado al techo y la reflexión de la pared cae en la zona comprimida del fototransistor. Arreglo barato: **bajar su $R_L$ de 3 kΩ a 1,5 kΩ** (dos de 3 kΩ en paralelo, que el usuario tiene) para bajar el fondo y recuperar margen. 📌 Y la lección de método del día: en `walls.c` la frente es **`max(R0, R3)`**, así que **un número bueno de la frente no dice nada de ninguno de los dos por separado** — atribuir «los frontales van bien» a ese número fue el error que costó media tarde |
| 2026-10-02 | 🔌 **El puente WiFi se cae con CADA reflash, y su servidor se quedaba ciego con un socket zombi.** Al resetear el MCU el ESP **sale del modo transparente** (o se reinicia): el socket que queda en el PC está `ESTAB` pero **mudo**, y no llega **ni el `>BOOT:1` del arranque** (medido tres veces en la tarde). Encima `puente.py` **solo hacía `accept()` si no había ningún cliente**, así que con un zombi delante se quedaba en `select()` para siempre: la telemetría se **acumulaba sin leer** en el búfer del kernel —visto **17 030 B en `Recv-Q`**— mientras el registro no crecía ni un byte, y el síntoma parecía «el robot no envía». Arreglado: `select` incluye **siempre** el socket de escucha y atiende **todos** los clientes vivos | 📌 **Dos reglas nuevas**: (1) **después de flashear, volver a `TEST → VARIOS → WIFI AL PC`**, siempre; (2) si «el puente no funciona», **mirar `Recv-Q` con `ss -tn` antes de tocar el robot** — si hay bytes ahí, el robot está enviando y el que no lee es el servidor. Coste real del día: **una curva IR entera perdida**, porque los valores de la calibración viven en RAM dentro de la prueba |

| 2026-10-02 | 🔬 **EL `>WF_GYR` DE 272° ERA UN SESGO DEL GIROSCOPIO MAL MEDIDO, y es la causa del fallo en el laberinto.** El robot se atascaba **antes de cruzar la primera celda** chocando de lado, y el giroscopio acumulaba **272° y luego 257° más** mientras el robot, comprobado por el usuario, estaba **parado empujando contra la pared** (la odometría decía −26° y el desplazamiento iba a −36°, coherente consigo misma ⇒ la que mentía era el giroscopio). Causa: el **sesgo** se mide promediando 50 muestras al **entrar** en la prueba, y si en ese medio segundo están colocando el robot en el laberinto el sesgo sale falseado; con él, el integrador crece solo, el lazo cree que hay desvío y **corrige a tope (±60 mm/s) permanentemente** ⇒ el robot se va de lado y choca. En la prueba 20 no pasó porque ahí el robot ya estaba quieto al calibrar (el avance midió **−0,13°**). ✅ Dos protecciones, las dos en `app/motion.c`: **(1)** la calibración mira la **varianza** de la tanda y, si supera **2 °/s**, da por hecho que están moviendo el robot, tira la tanda y **repite hasta 3 veces**; **(2)** `motion_asentar()` —que ya dura 250 ms con el robot **frenado**— re-mide el sesgo en su bucle (no cuesta tiempo de más) y lo corrige con un filtro lento. La segunda hace que **el arreglo se autocure**: aunque la calibración inicial falle, el sesgo converge en los primeros movimientos | 📌 **El modo de fallo que más cuesta ver es una medida que se va sin que se mueva nada**: un sesgo de decenas de °/s integrado durante segundos son cientos de grados de giro **inventados**, y el lazo los obedece. La pregunta que lo desatasca no es del firmware sino del suelo: **«¿y el robot qué hace?»** — parado empujando, no girando. ⚠️ Y encaja con la otra observación del día: en el avance de la prueba 20 el giroscopio dio **−0,13°** porque ahí sí se calibró quieto. **+168 B** de Flash (78,4 % → 78,6 %). ⚠️ **Y el refinamiento tenía su propia trampa**: con las muestras tomadas **desde el primer milisegundo** del asentamiento —cuando el robot **aún gira por inercia** tras el frenazo—, el sesgo se llevaba el giro del movimiento. Medido esa noche: **16 °/s** de sesgo falso, con el giroscopio **sin ver la media vuelta** (marcó 3,5° donde el robot giró 146°) ⇒ como el giro se cierra con el giroscopio, el lazo **siguió pidiendo girar** hasta agotar los 8 s y el robot acabó **parado empujando** contra la pared (`>WF_ATASCO:1`). Corregido **muestreando solo en la segunda mitad** del asentamiento y **topando el paso** de cada refinamiento a 5 °/s, más telemetría **`>WF_SESGO`** para poder verlo (por encima de 1 °/s con el robot quieto es un fallo) |

| 2026-10-02 | 🧭 **El rumbo al avanzar pasa a corregirlo el GIROSCOPIO, porque el corrector por odometría era 13 veces más lento que una celda.** Medido en el pasillo con el *wall follower* y `>WF_DEC` = avanzar en todas las celdas, `>WF_ANG` fue **30,3 → 26,3 → 29,9 → 41,1°**: un desvío que **crecía** en vez de apagarse. Causa: la odometría saca el giro de la **diferencia de arcos de las ruedas** y `theta_0` se toma **al empezar cada avance**, así que cada celda **hereda** el desvío de la anterior; y el lazo, con $\tau = L/(2K_p) = 77{,}6/(2 \times 3)$, tarda **12,9 s** en corregir, frente a los **1 s** que dura la celda, así que dentro de una celda solo apaga el **7 %** del desvío. Ahora la referencia es el giroscopio —`motion_gyro_leer()` integra el eje Z, con el sesgo medido una vez en `MOTION_Init()` (50 muestras) y el integrador puesto a **cero en cada avance**—, con `MOTION_GYRO_KP` = **40** ($\tau$ = **1,0 s**) y tope de corrección `MOTION_GYRO_CORR_MAX_MM_S` = **60 mm/s** (24 % de la velocidad de crucero). Si la IMU no responde, o falla a mitad de movimiento, se cae al respaldo por odometría y `>MOV_GYROK`/`>WF_GYROK` lo dicen. Cuesta **+648 B** de Flash (77,3 % → 78,3 %) | 📌 **Ampliado más abajo, el mismo día**: los **giros** también pasan a cerrarse con el giroscopio (la odometría sobreestima el pivote un 44 %) y `MOTION_GYRO_KP` acaba en **12**, no en 40, porque con 40 el lazo saturaba con 1,5° de error y hacía **zigzag**. Y el sesgo hubo que hacerlo robusto: ver la fila del 🔬 | 📌 **Y el mismo día se midió que los giros van con la odometría MAL**: con `>MOV_GYR` como testigo, la odometría dijo **+125,4°** donde el robot había girado **+87,1°** (sobreestima el pivote un **44 %**), porque al girar sobre el centro las ruedas **deslizan lateralmente** para pivotar. Consecuencia práctica: `MOTION_Girar(90)` cortaba a los **62°** reales — un **30 % menos** en cada esquina. ⇒ **El ángulo del giro también se cierra con el giroscopio** desde ese día. ⚠️ Y **no se arregla tocando la trocha**: el factor 1,44 es del pivote, y en el **avance** la odometría es buena (medido el mismo día: **+2,3°** frente a **−0,1°** del giroscopio) ⇒ un solo parámetro no puede servir para los dos |

| 2026-10-02 | ✅ **EL ROBOT YA VA RECTO, y se mide: tres celdas seguidas con el giroscopio en −2,4 · −0,9 · −0,6°** (avances de **179,3 · 180,2 · 177,4 mm**) y **detectando la pared** en la celda 4 (`>WF_FRENTE:1`). Es la primera vez que el *wall follower* cruza un pasillo sin torcerse: antes de hoy el mismo recorrido daba **30 → 26 → 30 → 41°** de desvío. Con el rumbo resuelto, el fallo se mudó al **giro**: en la celda sin salida el robot se quedaba empujando contra la pared (`>WF_ATASCO:1`), y eran **dos causas**, las dos del giro. **(1) El corrector de centro no tenía tope**: `centro_mm_s = -MOTION_GIRO_CENTRO_KP × desplazamiento_mm` es un término **común** a las dos ruedas, así que no toca la diferencia —que es lo que gira— pero **mueve el robot**; y girando **rozando las paredes** la odometría cuenta desplazamiento falso, así que con 100 mm de cuenta falsa y $K_p = 8$ pedía **800 mm/s a las dos ruedas** y el robot **salía disparado contra la pared** en vez de pivotar ⇒ tope `MOTION_GIRO_CENTRO_MAX_MM_S` = **60 mm/s**. **(2) Cinco giros por decisión**: comprobar la izquierda girando (a la mano, deshacer, al otro lado, media vuelta) son hasta **cinco** giros de 90° en un fondo de saco, y en el laberinto **cada giro roza** (el chasis barre ~147 mm en una celda de 180) ⇒ orden nuevo **frente → mano → atrás**, que lo resuelve con **dos** | 📌 **El precio del cambio de algoritmo**: un cruce en «T» hacia la izquierda se pasa de largo. Se cambia **explorar más** por **atascarse menos**, que es lo que hace falta para moverse sin chocar. ⚠️ **Y la lección de método del día**: los dos fallos que costaron la tarde —el sesgo del giroscopio y el corrector de centro— eran **correcciones que se creían una medida que no era real**, y en los dos casos el dato que los destapó **no salió del firmware** sino de preguntar **qué hacía el robot**: «parado empujando, no girando». **+4 KB** de Flash en todo el día (74,2 % → 78,6 %) |
| 2026-10-02 | 🎯 **LOS GIROS DE 90°, RESUELTOS — y la causa raíz era MECÁNICA, no del firmware.** El eje de la **rueda izquierda iba duro**, y mientras una rueda arrastra el robot **pivota sobre ella**: el chasis gira 90 y el giroscopio lo mide bien (`>MOV_GYR` daba 88-91 en todas las tandas), pero el morro acaba **descentrado**. Por eso el robot «no completaba el giro» mientras la telemetría cantaba que sí, y por eso acababa «de lado» una y otra vez. En cuanto el usuario arregló el eje, **la medida empezó a responder de forma monótona a la escala**. Los cuatro valores que se fijaron en `app/motion.h`, todos medidos: **`MOTION_GYRO_ESCALA` = 1,20**, **`MOTION_GIRO_KD` = 0,3**, **`MOTION_GIRO_VEL_MIN_RODANDO_MM_S` = 35 constante** y **`MOTION_GIRO_RODANDO_DPS` = 0**; más el **anti-windup** del término I (`MOTION_GIRO_I_MAX_MM_S` = 30) y el tope de movimiento a **3,5 s** | 📌 **Las tres lecciones de método, y las tres costaron horas.** **(1) `>MOV_GYR` no puede calibrar la escala del giroscopio**: el lazo cierra sobre `gyro_total`, que ya está escalado, así que al subir la escala el robot gira menos **pero la telemetría vuelve a decir 90** — la referencia se valida a sí misma. Para la escala hace falta una **cinta en el suelo**. **(2) Un mínimo de velocidad con umbral es un relay**: con `VMIN` 0 y `VARR` 40 el mínimo saltaba según si el robot rodaba o no, y la histéresis **oscilaba** (el usuario: «rebota»). Constante y moderado, no oscila. **(3) 1,00 y 1,25 eran las dos malas, y por eso el robot parecía hacer lo mismo con las dos**: 1,00 se pasaba 45°, 1,25 se quedaba 45° corto, y **1,20 es el cero**. ⚠️ **Y ninguna calibración vale con una rueda dura** |
| 2026-10-02 | 🔌 **`GYRO`, la orden que sintoniza el lazo de giro sin reflashear** (siete ganancias: `KP`, `KI`, `KD`, `ESC`, `VMIN`, `VARR`, `VDPS`, más la referencia `ODOM\|GIRO\|FUSION`). El motivo es de tiempo medido: **un flasheo son tres minutos y además reinicia el robot, y con él la calibración del giroscopio**, así que dos tandas de sintonía no se podrían ni comparar. Con la orden, cada prueba cuesta **segundos**, y toda la escalera de la escala (1,00 → 1,125 → 1,19 → 1,21 → 1,20) se hizo sin volver a flashear. **+640 B** de Flash | 📌 **Es la herramienta que faltaba desde el principio**: la dispersión de los giros pasó de **26°** entre tandas a **1,2-2,9°**, porque por primera vez se pudo repetir la misma maniobra cambiando un solo número. Y dejó escrita la tabla de síntomas ⇒ ganancia, en [comandos-serie.md](./comandos-serie.md) |
| 2026-10-05 | 🏁 **Competición disputada (sábado 3-oct) y analizada.** El robot llegó a moverse sin cable pero **se perdió en el laberinto**: hizo **un pasillo de 8 celdas a tropezones**, cada vez más torcido, hasta que se encontró una pared delante y ya no pudo seguir. Lo **medido y descartado** esa tarde: los giros de 90° (cuatro giros, **361,9° en total**, dispersión **2,1°**), el avance recto (179/180/177 mm con rumbo **−0,9°**), el sensor frontal (**0** sin pared / **179** con pared, umbral 75), la decisión del *wall follower* (correcta) y el pivote (`MOV_D` de 3-6 mm). Lo que **falla**: **(1)** `WF_Paso()` mide la pared **una vez** y avanza los 180 mm **a ciegas**; **(2)** los laterales no sirven —la derecha da **2687 con el robot en el aire** y su umbral es 2050, así que **siempre ve pared**— y la izquierda está a **158 cuentas** del corte; **(3)** **no hay ninguna referencia absoluta**: la posición depende solo de la odometría y del giroscopio | 📌 Quedan **tres hipótesis**, ninguna confirmada: **H1** el error se acumula por celda (avanzar a ciegas), **H2** el robot balancea porque el actuador es más grueso que el sensor (**1 % de duty = 15 mm/s** frente a los **14 mm/s** que resuelve el encoder: relación **1:1**), y **H3** el robot no arranca centrado. La tentación es arreglar las tres a la vez; la lección de la noche del 2 de octubre es que **lo que falta no es una idea, es una prueba** |
| 2026-10-05 | 📚 **Analizados tres firmwares de referencia** ([firmwares-referencia.md](./firmwares-referencia.md)): **UKMARSBOT** (`micromouseonline`, hardware sin software: el código vive en `ukmarsbot-examples` y `ukmarsbot-mazerunner`), **ZoroBot3** (OPRobots, STM32F405 con libopencm3, 8 382 líneas de C, GPL-3.0) y **KERISE** (kerikun11, ESP32 con FreeRTOS). Lo que **aplica a nuestro robot**: UKMARSBOT cerró el lazo por **posición** con un perfil (*«the previous code used a velocity control model and it was not proving stable»*) y **sin término integral**, con lo que el problema del mínimo de velocidad **no existe por construcción**; ZoroBot3 lleva el **PWM a 20 kHz** (34:1 frente al sensor, contra nuestro 1:1), **compensación de tensión de batería** (`voltage / get_battery_voltage() * MAX_PWM`) y seis lazos PID distintos para explorar y para correr; y los **tres** muestrean la pared **al cruzar el borde de la celda** (UKMARSBOT: *«unos pocos milímetros de recorrido pueden doblar la señal»*). Descartados **con motivo**: **FreeRTOS** (20 KB de RAM), **succión** (no hay hardware), **perfiles en S con *jerk*** (a 250 mm/s no se notan), **reescribir en C++** y **cambiar de MCU** | 📌 **Lo que se adopta no es código, es una lista de ideas ordenada por lo que desbloquea**: primero los **laterales que funcionen** (habilitan todo lo demás) y la **pared como referencia absoluta** (壁切れ), que es la respuesta directa al fallo #3 |
| 2026-10-05 | 🗺️ **Plan de mejoras en cuatro bloques** ([plan-mejoras.md](./plan-mejoras.md)) y **guion de la campaña** ([puesta-a-punto.md](./puesta-a-punto.md)), cada bloque con **una puerta de salida medible**: **1** encoders y PWM (resolución del actuador, µm/cuenta y ganancias **por rueda**, *feedforward* de fricción), **2** sensores (crosstalk, alineado de emisores, barrido de $R_L$, apantallado), **3** movimiento (error por celda en el 6×6, medido **con cinta**), **4** aceleraciones (perfil angular en vez del mínimo artificial). ⚠️ **Nada se ejecuta todavía**: primero se escribe el protocolo, y el bloque 2 puede esperar al **rediseño en KiCad**, porque es hardware | 📌 **Dos decisiones de método**: el orden es **1∥2 → 3 → 4** (medir rectitud con el actuador grueso es medir el ruido) y **la puerta se comprueba contra una referencia EXTERNA al robot** — la odometría y el giroscopio no pueden validarse a sí mismos, que es exactamente el error que costó media tarde del 2 de octubre con `>MOV_GYR` |
| 2026-10-05 | ⚠️ **Hallazgo del guion: las pruebas que necesitan los bloques 1 y 3 están RETIRADAS del menú.** `MIN M1`/`MIN M2`/`MIN AMBOS`, `COMPARA M`, `RAMPA PWM` (9), `UM MOTORES`, `PPR A MANO` y `ODOMETRIA` (19) se desconectaron el 2-oct para liberar Flash —**con razón**: sus números quedaron grabados en los ajustes—. Pero el bloque 1 **cambia el actuador** (PWM a 20 kHz), y con él **todo lo medido deja de valer**: hay que volver a medirlas con la resolución nueva, así que **lo primero de la campaña es descomentar sus filas** | 📌 Es el precio de haber recortado el banco para llegar al sábado: las pruebas **se quedaron compiladas**, con su Doxygen, **a un descomentario de distancia**, así que recuperarlas es barato — pero hay que acordarse **antes** de ponerse a medir |
| 2026-10-05 | 📐 **Chasis V1: placa base de 70 × 90 mm** con el **frente redondeado (R25; ése es el lado de 70 mm)** y **muescas laterales de 26 × 10 mm centradas** para las ruedas ([chasis-v1.md](./chasis-v1.md)). El robot actual va **soldado sobre *protoboard* y cableado con *wrapping***, y eso hace imposible apantallar los sensores: el rediseño en KiCad empieza por la placa. Se genera con un **script parametrizado** (`mechanical/freecad/chasis-v1.py`) y FreeCAD en consola, y se verifica **contra el área teórica calculada de forma independiente** (**0,000 % de error**), releyendo el STEP recién escrito y con una **prueba de forma por puntos** (10 puntos dentro/fuera, **0 fallos**). Se exporta además un **DXF**, para meterlo en KiCad como `Edge.Cuts` | ⚠️ **Tres trampas que cazó la comprobación**: (1) un contorno mal construido **se delata por el área** (un arco invertido o un tramo ausente no cuadran); (2) `Part.export([shape], ruta)` escribe un STEP **con cabecera y SIN geometría** (1,6 KB frente a los 24,7 KB buenos) ⇒ hay que usar el exportador del propio *shape*; (3) **el área y el *bounding box* NO distinguen un frente redondeado de uno trasero**, así que hay que preguntarle al sólido por puntos concretos. Y una del `.gitignore`: la excepción para versionar el STEP lleva prefijo **`chasis`** a propósito, porque un `!.../freecad/*.step` a secas reabría los **≈784 MB** de modelos de GrabCAD |
| 2026-10-09 | 🏷️ **Nomenclatura de versiones fijada, y el chasis renombrado.** Las piezas dejan de nombrarse por **orden de creación** y pasan a hacerlo por **versión del robot**: `chasis_v2.py` —que en realidad *era* la V1— pasa a `chasis-v1.py` / `chasis-v1.step`, el verificador a `verifica-chasis.py` (ahora **parametrizado**: el nombre de la pieza, sus cotas y los puntos de la prueba de forma están juntos al principio, para reaprovecharlo con la V2 sin duplicarlo) y el documento a [chasis-v1.md](./chasis-v1.md). **Los ficheros del prototipo no se renombran**: siguen en los `.FCStd` y quedan identificados por el hito **`OSHWDem26`**. No cambia el contenido: el STEP regenerado da el **mismo volumen** (16 576,4 mm³), **0,000 %** de error de área y **0 fallos** en la prueba de forma | 📌 **El motivo es que «v2» significaba dos cosas a la vez**: el chasis de 70 × 90 (que es la **V1**, el primer robot montado de verdad) y la futura iteración de hardware. Con eso se cierra además la discusión de **cómo versionar**: se descartan los **submódulos** (rompen la atomicidad del commit y no permiten representar «la V1 completa»), los **repos por versión** (triplicarían 76 ficheros de firmware y no se ahorra nada: el repo versionado son **157 ficheros**) y las **ramas por robot** (un ajuste es un **valor**, no una historia). La decisión: **un repo, una sola historia**, la versión como **eje de configuración** (`boards/` + `[env:]`) y los hitos como **tags**; el único caso que partiría el repo es un **cambio de microcontrolador**. Un `chasis*.step` en el `.gitignore` ya cubría el nombre nuevo, así que **no hubo que tocar la lista blanca** |
| 2026-10-10 | 🔍 **Analizado `ukmars/mazerunner-core`**, que resulta ser **el software de verdad del UKMARSBOT** (la ficha del 2026-10-05 decía que ese robot «no tenía software»: lo que faltaba era el código **en el repo del hardware**, no en el proyecto). Son **5 735 líneas en 18 cabeceras** (*header-only* más un `.ino` de 103 líneas) y corre en un **ATmega328 con 2 KB de RAM**, con un **ISR de control a 500 Hz** y el bucle principal para la navegación. Trae **su propia auditoría de código** (`review/`, 2 419 líneas). Tres hallazgos que nos tocan de lleno: **(1)** su `config.h` resuelve la configuración multi-robot con **tres ejes compilados** —`HARDWARE` (la placa), `EVENT` (el laberinto) y `ROBOT` (la variante física)— con **cuatro juegos de calibración del mismo robot para cuatro recintos**: justo el problema de «el laberinto de casa no es el del sábado», **resuelto compilando otro juego de números en vez de reajustando con el cable puesto**, y con **µm/cuenta por rueda**; **(2)** el **control de dirección por CTE**, donde el error lateral de las paredes **se convierte en un error angular que se suma al ángulo del robot**, de forma que lo corrige el lazo de rumbo **que ya existe** (*«no hace falta un lazo nuevo»*); **(3)** el ***feedforward* del modelo** (velocidad + aceleración + *bias* **con signo**), que es lo que permite perfilar sin mínimo de velocidad artificial | 📌 **Lo más incómodo del informe**: hacen perfiles trapezoidales, PD de posición con tres términos de *feedforward*, control de dirección por pared, mapa 16×16 y *flood fill* **en 2 KB de RAM**. Nosotros tenemos **diez veces más** y no llegamos: **la diferencia no es el microcontrolador, es el diseño**. Y su auditoría **confirma el análisis de nuestro firmware**: la capa de aplicación es portable y la de hardware no, porque los drivers no están detrás de ninguna interfaz. ⚠️ Con dos avisos que nos afectan: al barrer un **borde de poste** el controlador puede intentar «seguir el borde» y desviarse —**y nuestro *wall follower* barre un borde en cada celda**—, y su cola del BFS tiene **desbordamiento silencioso** |
| 2026-10-02 | 🧱 **El *wall follower* sigue atascándose, y ahora se sabe exactamente por qué: `WF_Paso()` mide la pared UNA vez, al principio del paso, y después avanza 180 mm a ciegas** (`wf_buscar_direccion()` → `MOTION_Avanzar(WF_CELDA_MM)`). Medido en el laberinto: en la celda 4 el robot **sí ve** la pared (`>WF_FRENTE:1`), **decide bien** (`>WF_DEC:4`, media vuelta) y **gira bien** (`>WF_GYR` = **−178,9°** tras los dos giros de 90), pero el avance final acaba **empujando contra la pared**: del centro de la celda 4 al `>WF_ATASCO:1` pasaron **11 s**, con 8 de rueda patinando. O sea: **«choca y sigue avanzando» NO es un fallo del sensor de pared**, que era la sospecha. Lo único que se cambió es el tope de movimiento: **8000 → 3500 ms** | ⚠️ **Queda pendiente y NO se tocó la víspera**: el arreglo correcto es **avanzar la celda por tramos comprobando el frente**, y eso es un rediseño de `WF_Paso()` que necesita varias tandas en el pasillo que no hay. 📌 **Regla de método para no repetir la noche**: cuando llevas cuatro cambios seguidos en el mismo lazo sin poder probar entre medias, **lo que falta no es una idea, es una prueba** — y a las 22:40 se paró 
| 2026-10-11 | 🎛️ **Árbol de menú por bloques de trabajo**: la raíz pasa de `TEST`/`EXPLORE`/`RESOLVE`/`SETTINGS`/`DIAG`/`PARAR` a **nueve bloques** — `BATERIA` · `IR` · `MOTORES` · `TELEMETRIA` · `EXPLORACION` · `RESOLUCION` · `AJUSTES` · `DIAGNOSTICO` · `PARAR` —, con las pruebas agrupadas por **para qué se usan** y no por de dónde vienen. `submenus[]` renumerado (ahora son **nueve**, y ese array es un contrato). Se **reactivan** `PPR A MANO` y `UM/CUENTA` (en `MOTORES → CALIBRAR`, que es justo lo que pedía la fila del 5-oct para el bloque 1), `ENCODERS`, `IMU` y el chequeo de soldadura del ADC (en `DIAGNOSTICO`); se retiran el `ADC` crudo y `VER R0`..`VER R3`, que los cubre `IR → LECTURA` | Los nombres viejos no decían **qué se estaba haciendo**: para calibrar los encoders había que saberse de memoria que la prueba 7 estaba dentro de `TEST → MOTORES`, y `PAREDES` —el **único** ajuste que hay que hacer en el laberinto, sin PC— estaba enterrado en el tercer nivel. ⚠️ Coste medido: **+2 720 B de Flash** (66,7 % → 71,3 %), que son precisamente las pruebas reactivadas: con `--gc-sections` el linker las había tirado por no estar referenciadas |
| 2026-10-11 | 🔋 **Voltaje del pack en la cabecera de la raíz**, a la derecha y **sin unidades** (`7.7`): `MENU_SetVoltaje()` (el menú **no lee la batería**, se lo empuja la APP, así sigue sin conocer `sensor/battery.h`) y `MENU_RefrescarVoltaje()`, que repinta **solo el número** y no la pantalla entera (`MENU_Dibujar()` hace `OLED_Clear()` y el parpadeo se ve). Refresco cada **2 s** desde el bucle del menú | Saber si quedaba batería obligaba a entrar en `BATERIA` y salir: cuatro pulsaciones cada vez, y en el laberinto se agradecen. El refresco es **por tiempo y no por vuelta** a propósito: el bucle del menú corre a ~40 Hz y cada `OLED_Update()` son ~50 ms de I²C ⇒ a 40 Hz se comía el 20 % del tiempo, y ese error **ya dejó el menú sin responder el 30-sep**; a 2 s es un 2,5 % |
| 2026-10-11 | 🔤 **Los cinco glifos que faltaban** (`H J Q Y Z`), añadidos **al final** de `oled_font[]` y `oled_chars[]` en `app/oled.c` | Sin ellos no se podían escribir `DERECHA`, `IZQUIERDA` ni `AJUSTE`, y los nombres del árbol nuevo los piden. Van al final a propósito: el `typedef` que comprueba que las dos tablas cuadran **solo cuenta glifos**, no verifica glifo a glifo, así que reordenar la tabla entera sería un cambio a ciegas. Coste: **25 B** |

| 2026-10-11 | ⏱️ **Cronómetro de tramos para poner número al retardo del lazo** (TIM4 a 2 µs por cuenta, `hal/timers.h`) + **orden `LAZO`** de consola, que publica los máximos y los reinicia. Se cronometran tres cosas: la **vuelta del lazo** (en los dos bucles de `app/motion.c` y en el de la prueba 18), un **`OLED_Update()`** y **una línea de telemetría** (`UART_SendData`) | El «retardo del lazo» no es una cifra: son **cuatro fuentes con costes muy distintos** — el filtro de 20 muestras del encoder (**~9,5 ms**, algorítmico), el periodo del lazo (**10 ms**), la telemetría bloqueante (**~7,5 ms** de golpe cada 50 ms: `HAL_UART_Transmit` con `HAL_MAX_DELAY`, 86 B a 115200) y el volcado de la OLED (**~47 ms** de golpe cada 200 ms: 528 B de I²C a 100 kHz). Solo las dos últimas se arreglan **sin tocar el estimador**, y había que medirlas antes de tocarlas. ⚠️ **Medir el lazo no puede costar telemetría dentro del lazo** —sería justo el retardo que se está midiendo—, así que los máximos se piden a mano y no se publican solos. ⚠️ Hallazgo del mismo día: **`app/motion.c` y `app/wall_follower.c` no tocan la OLED**, así que el agujero de 47 ms está solo en los **bancos de prueba** (la pantalla del PID se repinta cada 200 ms, justo cuando se juzga `Kp`) ⇒ las ganancias que salen del banco son **conservadoras** para la misión. Coste: **+688 B** de Flash (71,3 % → 72,3 %) |

| 2026-10-11 | 🎯 **Decisión sobre el lazo de control** (a raíz de la pregunta «por qué hay retardo del lazo»): se separa en **dos trabajos**. (1) **Ahora, lo barato**: medir con `LAZO` y quitar los **bloqueos** (telemetría por DMA o anillo, e I²C a 400 kHz), **sin tocar el lazo ni las ganancias**. (2) **Estudio aparte, con banco en el PC**: el estimador de velocidad (**método M/T**) o el ***feedforward*** del modelo, que es lo único que rompe el acoplamiento resolución↔retardo. Se descarta de momento mover el lazo a un ISR de timer: **no arreglaría el filtro** (los 9,5 ms son del algoritmo, no de dónde corra el código) | `resolución = µm/cuenta ÷ T_ventana` ⇒ con 270,7 µm/cuenta, 20 ms dan 13,5 mm/s y 5 ms dan 54 mm/s: **acortar la ventana para ganar tiempo pierde precisión**. El método M/T mide el **tiempo entre cuentas** con un timer de 1 µs en vez de contar cuentas en un tiempo fijo, y rompe ese compromiso; el *feedforward* del modelo (lo que hace `mazerunner-core`) lo evita del todo, porque la mayor parte de la velocidad la pone el modelo y el lazo solo corrige. ⚠️ **Las ganancias actuales (0,10 / 0,50 / 0) siguen valiendo** si algún día se baja el retardo: un lazo más rápido **sube** el margen de fase, así que se quedan conservadoras y la re-sintonía es para **aprovechar** el margen nuevo, no para arreglar nada |

| 2026-10-11 | 🔁 **Etapa 1 del lazo de control en interrupción, grabada y verificada**: módulo nuevo `app/control_loop.c/h` que corre al **evento de actualización de TIM1** (~999 Hz, el mismo que genera el PWM) y hace **muestreo de encoders + PID + escritura del duty**, con registro de controladores (`LOOP_Activar/Desactivar`) para que solo regule quien deba. **En esta etapa la interrupción solo muestrea**: el PID sigue en el bucle principal. El estimador (`update_encoder_readings()`) pasa a recibir el `dt` **por parámetro** y a llamarse **solo** desde la interrupción | ⚠️⚠️ **El hallazgo gordo del día, y salió de leer el estimador con los números delante**: la ventana de la media móvil es la **suma de los `dt`**, no 20 ms. Con 20 muestras, la ventana dura lo que tarde el que llama ⇒ **~38 ms en la prueba 18 y ~200 ms en `MOTION_Avanzar`** (que va a 10 ms) ⇒ **~95 ms de retraso al regular en la misión**, cinco veces el del banco. O sea que **`Kp` se sintonizó en un lazo y se aplica en otro**. ⚠️ Y eso **solo lo arregla fijar el ritmo**, no mover el código: por eso el ISR va antes que las ganancias por rueda (etapa 3), que si no se afinarían contra el lazo equivocado. ✅ Medido tras grabar: **8834 pasos en ~8,8 s (~1004 Hz)** y **22 µs por paso** de los 1001 disponibles (**2,2 % de CPU**, margen 45×) |

| 2026-10-11 | 🧰 **Método: el agente lee el robot por SWD y por el puente, y escribe en el repositorio lo que mide.** Corregido a petición del usuario («¿por qué no las lees tú?»): describir la prueba 18 como «el que apunta las ganancias eres tú, a mano» era describir una limitación que no existe. **Por SWD** (`openocd -c "mdw <dir> <n>"`, direcciones de `arm-none-eabi-nm`) se lee cualquier variable de la RAM —el cronómetro, `app_state`, las ganancias del PID— **sin cable serie, sin puente y sin pulsar nada**; **por el puente** llega la respuesta entera con marcas de tiempo, que es lo que permite sacar sobreimpulso, tiempo de subida y error de régimen **por rueda** sin que nadie apunte números a mano | Y «guardar» no necesita emular Flash: las ganancias buenas se leen de la RAM y se escriben en el código como los `_DEF`, que es como se persistió la sintonía del 1-oct. Lo único que sigue necesitando manos humanas es **pulsar los botones** — y a propósito: forzar la FSM por SWD para lanzar una prueba **arranca motores sin nadie mirando** |

| 2026-10-11 | 🎛️ **Ganancias de PID independientes por rueda, y la medida que dice que hoy valen lo mismo.** `pid_test_kp/ki/kd` pasan de escalares a **arrays de dos** (`App_Rueda_t`), la orden es `PID KP 0.12 DER` (sin rueda, las dos), la telemetría publica **una etiqueta por rueda** (`>PID_KP_I`/`>PID_KP_D`…) y la pantalla enseña el parámetro marcado con las dos ruedas a la vista. `MOTION_Init()` suelta las ganancias y nace `MOTION_SetGanancias(m, kp_izq, ki_izq, kd_izq, kp_der, ki_der, kd_der)`: el banco y las primitivas de movimiento **siguen compartiendo** sintonía, pero ahora cada lazo recibe la suya. De paso, órdenes `TEST <etiqueta>` y `SALIR` para guionizar el banco desde el PC | ✅ **Medido por el puente, sin tocar un botón**: a **80 mm/s** el duty de las dos ruedas difiere en **−0,028 % ± 0,181** (0,2 σ) y a **300 mm/s** en **+0,061 % ± 0,113** (0,5 σ). El método **detectaría** una asimetría del 9 % (daría +6,3 mm/s, diez veces el error de la media) ⇒ **los dos motores están igualados dentro del 1 %** y **hoy las dos ruedas llevan las mismas ganancias**: escribir una asimetría que no existe sería peor que no tocar nada. ⚠️ Lo que la medida **no** cubre: se hizo con las **ruedas en el aire** y sin carga, que es justo donde la asimetría de un N20 aparecería. La estructura por rueda queda puesta y probada para el día en que las pruebas pasen al suelo |

| 2026-10-11 | 🔬 **Números del lazo después de la interrupción**: a 300 mm/s con 0,10/0,50 ⇒ **error +0,46 y +0,55 mm/s (0,15-0,18 %)** y **σ(v) de 10,3-13,2 mm/s (0,7-0,9 cuentas de encoder)**, o sea ruido de cuantización, no oscilación. **`Kp = 0,20` oscila** (σ de 151 y 83 mm/s, σ(duty) del **28 %**, picos de 817 mm/s pidiendo 300) ⇒ **0,10 queda confirmada**. Y sale la **planta real**: los puntos (10,93 % → 77,4 mm/s) y (12,32 % → 176,8 mm/s) dan $v \approx 71{,}5\,(duty - 9{,}85\,\%)$, o sea **71,5 mm/s por punto de duty con un escalón muerto de ~10 %**, que es lo que explica que a duty bajo el motor solo zumba (el tercer punto se sale un 10 %: el modelo es una aproximación, buena para *feedforward*, no para lazo abierto) | 📌 **Lo que el ISR no ha comprado, dicho con el número**: se esperaba poder subir `Kp` al doble y **no se puede**. En el **banco** el bucle ya iba a 1,9 ms, así que la media móvil ya duraba sus 20 ms y lo único que el ISR quitó fueron los 10 ms del lazo: el retardo pasó de ~20 a ~15 ms (**1,3×**). **El premio está en la misión**, donde ese mismo filtro pasaba de 200 a 20 ms (10×). Y la prueba de que la ventana ya es la de diseño se lee **en la telemetría**: las velocidades salen en escalones de **14,336 mm/s = 287 µm / 20,02 ms** |

| 2026-10-11 | 🔬 **Experimento de la ventana del filtro: lo que limita `Kp` es el RETARDO, no la resolución.** Se llevó `ENCODER_VEL_VENTANA` a 10, 20 y 40 muestras —la palanca que mueve **a la vez** el retardo y la cuantización, en sentidos opuestos— midiendo en cada caso con `Kp = 0,20` y `Ki = 0`, que es la ganancia que hace oscilar el lazo | **σ(duty) medido**: 10 muestras (retardo ~10 ms, cuantía 28,7 mm/s) → **8 %** · **20 (la de diseño)** (~15 ms, 14,3 mm/s) → **28 %** · 40 (~25 ms, 7,2 mm/s) → **51 %**, y el lazo se iba a **428 mm/s pidiendo 300 con duty medio negativo**. ⇒ **Con la medida 4× más fina el lazo va mucho peor: manda el retardo**, no la cuantización. Y con `Kp = 0,10` (la buena) la σ de la velocidad **medida en cuentas** sale **la misma con 10 y con 20 muestras (0,7)** ⇒ el residuo es cuantización pura y el lazo está en el suelo de la medida | ⚠️ **Pero acortar tampoco sube el límite**, porque la cuantización se come lo que se gana ⇒ **el acoplamiento resolución↔retardo es real y 20 muestras está cerca del óptimo: medido, no supuesto**. 📌 Lección de método: **antes de construir un estimador mejor, medir si la resolución es lo que limita** — aquí no lo era, y el experimento costó tres flasheos en vez de una semana de trabajo. Se comparó la σ **en unidades de la cuantía**, no en mm/s, que es lo que hace comparable lo incomparable |

| 2026-10-11 | 🎯 **Reordenado el trabajo pendiente a la luz de esa medida.** La **etapa 2 (meter el PID dentro de la interrupción)** baja el retardo un 30 % (~15 → ~10,5 ms) y ese factor mueve poco el límite de `Kp` ⇒ **deja de ser prioridad**. El **estimador M/T** seguiría valiendo, pero por lo que **rompe el acoplamiento** (resolución fina *y* ventana corta a la vez), con un premio esperable en `Kp` de **~1,5-2×**, no un cambio de escala ⇒ **mejora de segundo orden**. Y **`Kp = 0,10` no es una limitación a resolver**: el lazo da **0,15 % de error** con un ruido por debajo de una cuenta de encoder | 📌 **El problema del robot no está en el lazo de velocidad**: está en los **giros de ±4-7°** y en el desplazamiento residual de las primitivas, que son del lazo de giro y de la mecánica. Con esto, el lazo de velocidad queda **cerrado**: sintonizado, medido, con su planta identificada (escalón muerto del 10 % de duty) y con su límite explicado |

| 2026-10-11 | 📐 **La escala del giroscopio era 1,20 y vale 1,01 — y el que estaba mal era el número del firmware, no el sensor.** Medido contra **dos líneas perpendiculares marcadas en la mesa**, la única referencia que no depende del sensor que se calibra (la telemetría del giro **se valida a sí misma**, porque el lazo cierra sobre la misma cuenta que se quiere calibrar). Pedir 90° con `ESC` = 1,20 daba **~80°**: diez grados cortos **en cada esquina**. El barrido se hizo **en caliente** con `GYRO ESC`, sin regrabar (un flasheo reinicia el robot y con él la calibración del sesgo, así que dos tandas no se podrían comparar): 1,20 → 80°, 1,07 → 85°, **1,01 → ~89,5°**. De paso quedó medido el sensor: **±0,03° de dispersión entre cuatro giros de 90°** (las cuentas dan ±0,5°) y **menos de 0,1° de deriva por minuto** en reposo | ✅ `MOTION_GYRO_ESCALA` **1,20 → 1,01**. ⚠️ La tabla del 02-oct (cinta en el suelo, $L$ = 62 mm) queda **retirada**: medía el **desplazamiento del morro**, y esa conversión solo vale si el pivote es sobre el centro — y esa noche el robot pivotaba sobre una rueda dura |

| 2026-10-11 | 📐 **`MOTION_TOL_GRADOS` 1,5 → 0,5: la tolerancia era el error dominante del giro, no la mecánica.** El lazo suelta en la **primera muestra** que entra en la banda, así que deja un sesgo **del tamaño de esa banda**: con 1,5 el giro cortaba a 88,55° ⇒ **1,45° cortos por esquina**, que son los **−5,8° de `>MOV_E_ANG`** en `MOV UP 4` (y el usuario lo confirmó a ojo contra su marca: «unos 5°»). Con 0,5 sale **0,47° por esquina** y **−1,89°** al cerrar la vuelta, el robot acaba a **5 mm del origen** y el pivote se desplaza **±1,1 mm** | ✅ El giro de 90° queda **cerrado** (criterio < 2° ✓) y el presupuesto de una esquina baja de ~2,5° a **~1,1°** |

| 2026-10-11 | 🔴 **`SALIR` no funcionaba, y llevaba sin funcionar desde que se escribió la orden.** `BUTTONS_SolicitarSalida()` llamaba a `GPIO_MenuBtnIRQ_Handler()`, que despacha por `HAL_GPIO_EXTI_IRQHandler()` — y esa **solo llama al callback si el flag de EXTI está puesto**, cosa que en una orden de consola no ocurre porque **no hay flanco**. El contador no subía: la consola acusaba `>CMD_SALIR:1` y el robot seguía como si nada. Encadenados había **dos fallos más**: `BUTTONS_GetEvent()` consumía la misma bandera antes de que la viera el `while` (y eso afectaba **solo a la prueba 20**, porque llama a `CONSOLE_Update()` antes que a `GetEvent()` en el cuerpo — la del puente los llama al revés y por eso no le tocaba), y el contador del HAL se borraba **antes** de que el antirrebote decidiera, así que la pulsación se destruía en vez de esperar | ✅ **Arreglado y verificado en el robot**: nace `GPIO_MenuBtnIRQ_Solicitar()` (que llama al callback directamente), `BUTTONS_GetEvent()` deja de devolver MENU —el menú lo consume explícitamente en `LISTA`— y la bandera se **latcha**. Medido: `SALIR` dentro de la prueba 20 sale **en el mismo milisegundo** (`>CMD_SALIR:1` + `>APP_TEST:0` + `>APP_EST:1`). 📌 **La ISR atiende un flanco; no sirve para inventarlo** |

| 2026-10-11 | 🔬 **El sesgo del giroscopio se contaminaba al asentar: `MOTION_GYRO_REFINAR_ALFA` = 1,0 se llevaba al sesgo la inercia del frenado.** Medido: `>MOV_SESGO` saltaba **+0,64 °/s** con pivotes de −8,5 mm de desplazamiento, +0,51 con −3,3 mm y 0,00 con −0,8 mm ⇒ **«frenado» no es «quieto»**, y el tope de ±20 °/s no protege de una contaminación de 0,6 °/s (el número tiene que ser del orden de la deriva que se quiere seguir) | ✅ **Puerta de dispersión** nueva (`MOTION_GYRO_REFINAR_DISP_MAX` = 0,5 °/s) —el mismo criterio que la calibración inicial de 50 muestras— y `MOTION_GYRO_REFINAR_MAX_PASO` 20 → 5. Se mantiene `ALFA` = 1,0 con su argumento térmico, porque quien garantiza que la muestra es buena es la puerta. Verificado en giros limpios: sesgo 0,11-0,16 y **sigue refinándose** (no se bloquea de más). ⏳ **El caso contaminado NO se ha podido reproducir a propósito**: con `KP` = 12 para forzar el modo relé los pivotes siguen saliendo limpios (±0,3 mm) porque el corrector de centro los mantiene derechos |

| 2026-10-30 | ⚖️ **Doble licencia**: **GPL-3.0-or-later** para el software (`LICENSE`) y **CERN-OHL-S-2.0** para el diseño de hardware (`LICENSE-HARDWARE`). El `.gitignore` de lista blanca las incluía, porque solo deja pasar lo que se nombra a mano. **Hojas de datos y modelos de GrabCAD NO se relicencian** (siguen con la licencia de su autor) | Se va a **publicar el diseño** y sin licencia explícita el valor por defecto es «todos los derechos reservados», que es justo lo contrario de lo que se quiere. De las tres variantes de CERN-OHL se elige la **S** (fuertemente recíproca) porque es la que obliga a devolver las mejoras, y su equivalente más cercano en software es la **GPL-3.0** — antes de esto se reutilizaba MIT (`mazerunner-core`, `ukmarsbot`), y **MIT → GPL-3.0 es compatible**, así que lo ya adaptado (`core/profile.c`) conserva su aviso de copyright dentro del fichero |
| 2026-10-30 | 🧱 **Nacen las capas `core/` y `drivers/`, y con ellas `core/core_io.h`**: la aplicación (perfiles, movimiento, mapa) **no toca la HAL** y pide el robot por un contrato; el driver es quien lo implementa. `drivers/` está **vacía a propósito**: la interfaz se escribe **antes** que la implementación. Primera pieza: `core/profile.c` (perfil trapezoidal unit-agnóstico), portada del `Profile` de `mazerunner-core` (MIT) y validada en el PC (`firmware/test/profile_test.c`, 9 movimientos, **0 fallos**) | Es la conclusión que quedaba pendiente de la auditoría del 2026-10-10: en `mazerunner-core` la aplicación es portable y los drivers no, pero **no había interfaz escrita** que lo garantizara. Se adelanta el contrato para no descubrirlo parcheando, y de paso el perfil elimina el «avanza 180 mm a ciegas» que hizo chocar al robot en la celda 4 |
| 2026-10-30 | 🧭 **[estado-del-arte.md](./estado-del-arte.md)**: documento **de decisión** que junta la matriz de capacidades, lo que funciona **medido**, lo que está escrito y no vale, lo que falta con su coste y las fases **F1–F9** con su puerta de salida | Los análisis estaban repartidos en tres documentos (referencias, mejoras, puesta a punto) y **ninguno decía en qué orden se ataca**. Este sí, y se contrasta contra el build del día (RAM 32,3 % / Flash 79,1 %) |

> Añade una fila al tomar cualquier decisión que afecte a más de un módulo.
