pepechorva/Rabosa_micromouse/Documentacion/Pinout.pdf

STM32F103

Pin # Port Función Hardware Uso | Etiqueta de Net Telemetría
10 A0 | TIM2_CH1 | Encoder 1A | M1ENCA | E1
11 A1 | TIM2_CH2 | Encoder 1B | M1ENCB | E2
12 A2 | ADC1_IN2 | Sensores pared | WALL A1 | A1
13 A3 | ADC1_IN3 | Sensores pared | WALL A2 | A2
14 A4 | ADC1_IN4 | Sensores pared | WALL A3 | A3
15 A5 | ADC1_IN5 | Sensores pared | WALL A4 | A4
16 A6 | TIM3_CH1 | Encoder 2A | M2ENCA | E3
17 A7 | TIM3_CH2 | Encoder 2B | M2ENCB | E4
29 A8 | TIM1_CH1 | PWM Motor1A | PWM1A | M8
30 A9 | TIM1_CH2 | PWM Motor1B | PWM1B | M9
31 A10 | TIM1_CH3 | PWM Motor2A | PWM2A | MA
32 A11 | TIM1_CH4 | PWM Motor2B | PWM2B | MB
33 A12 | GPIO | Botón MENU | BTN_MENU
34 A13 SWDIO | programación y debug | SWDIO
37 A14 SWCLK | programación y debug | SWCLK
38 A15 | GPIO | GPIO LED | LED 1
18 B0 | ADC1_IN8 | estado batería total (vcc-gnd) ADC_BAT 1 | B1
19 B1 | ADC1_IN9 | estado batería celda 1 | ADC_BAT 2 | B2
20 B2 BOOT1 | programación y debug | BOOT1
39 B3 | GPIO | LED IR pared 1 | WALL L1
40 B4 | GPIO | LED IR pared 2 | WALL L2
41 B5 | GPIO | LED IR pared 3 | WALL L3
42 B6 | I2C1_SCL | I2C | SCL
43 B7 | I2C1_SDA | I2C | SDA
45 B8 | GPIO | LED IR pared 4 | WALL L4
46 B9 | GPIO | Botón DOWN | BTN_DOWN
21 B10 | UART3-TX | Telemetría / programación | TX
22 B11 | UART3-RX | Telemetría / programación | RX
25 B12 | SPI2_CS | SPI | CS
26 B13 | SPI2_SCK | SPI | SCK
27 B14 | SPI2_MISO | SPI | MISO
28 B15 | SPI2_MOSI | SPI | MOSI
2 C13 | GPIO | LED onboard | LED 2
3 C14 | GPIO | Botón OK | BTN_OK
4 C15 | GPIO | Botón UP | BTN_UP
