pepechorva/Rabosa_micromouse/images/3d-articulacion-barras.png

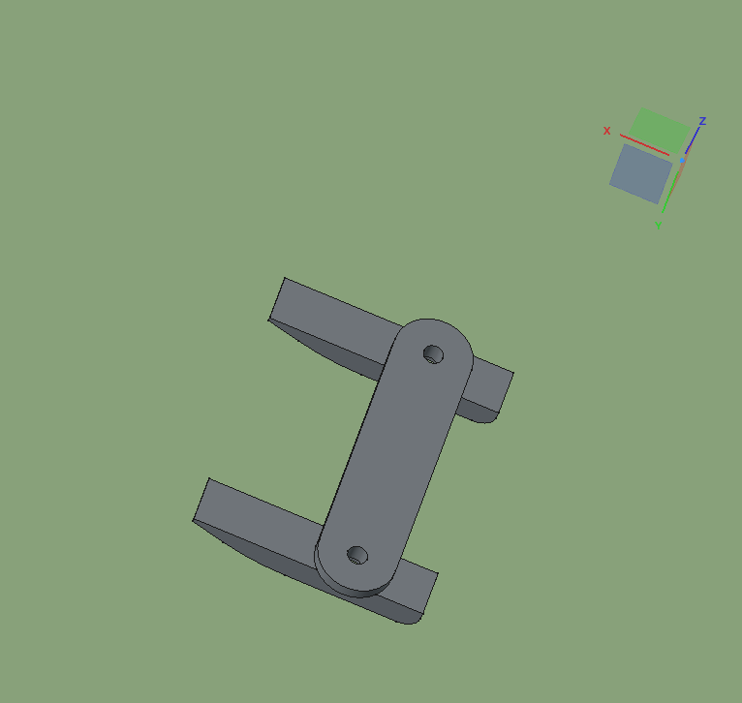
images/3d-articulacion-barras.png
