pepechorva/Rabosa_micromouse/images/3d-electronica-botones.png

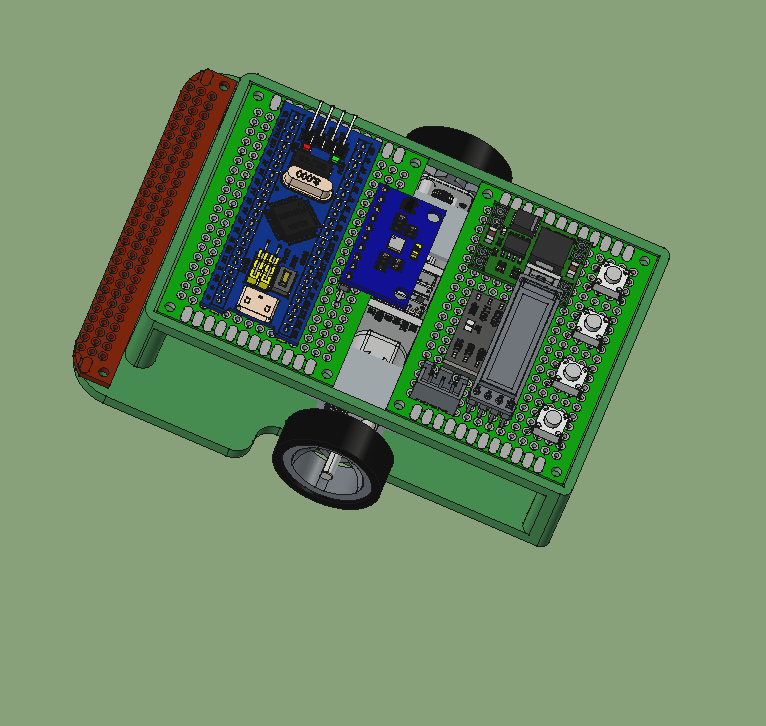
images/3d-electronica-botones.png
