pepechorva/Rabosa_micromouse/images/3d-electronica-superior.png

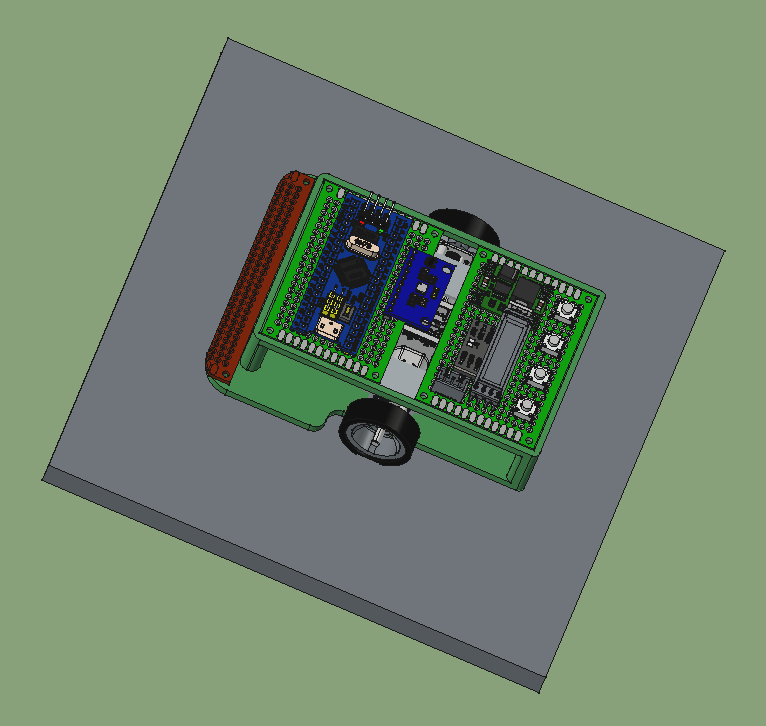
images/3d-electronica-superior.png
