pepechorva/Rabosa_micromouse/images/3d-placa-perforada.png

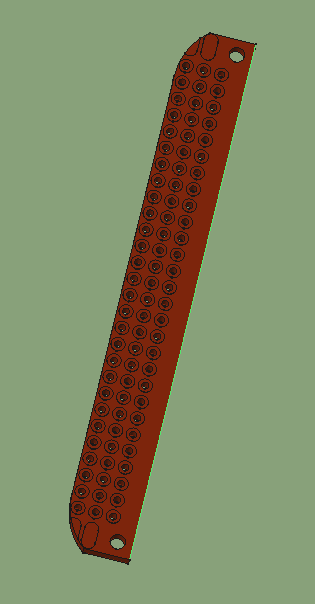
images/3d-placa-perforada.png
