pepechorva/Rabosa_micromouse/images/3d-robot-general.png

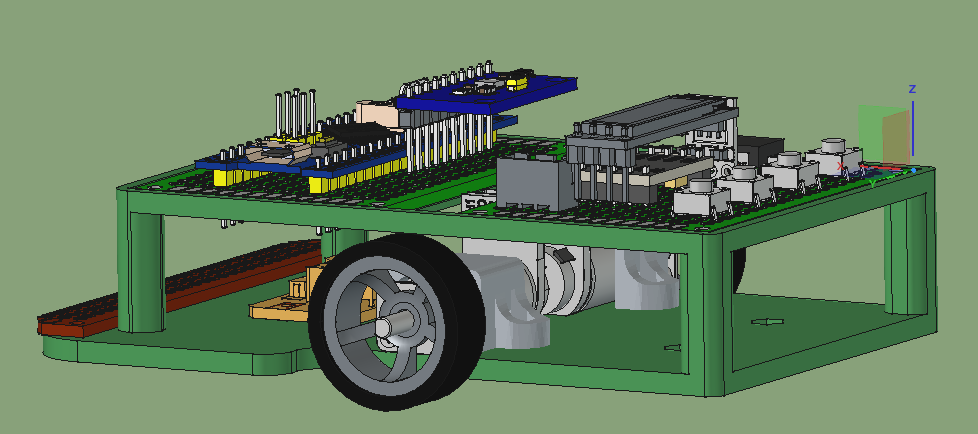
images/3d-robot-general.png
