pepechorva/Rabosa_micromouse/images/3d-soporte-electronica.png

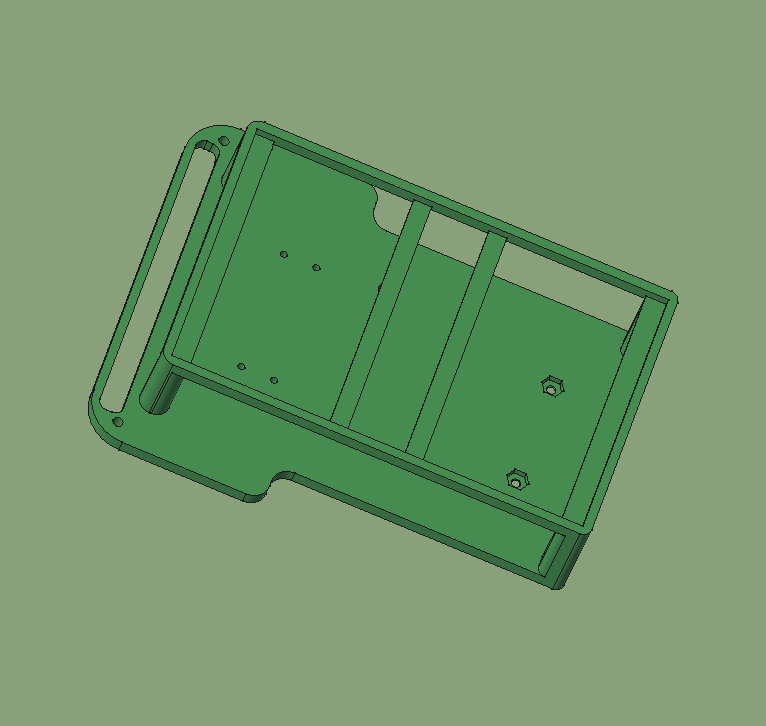
images/3d-soporte-electronica.png
