pepechorva/Rabosa_micromouse/mechanical/freecad/Rabosa_montaje-2.FCStd

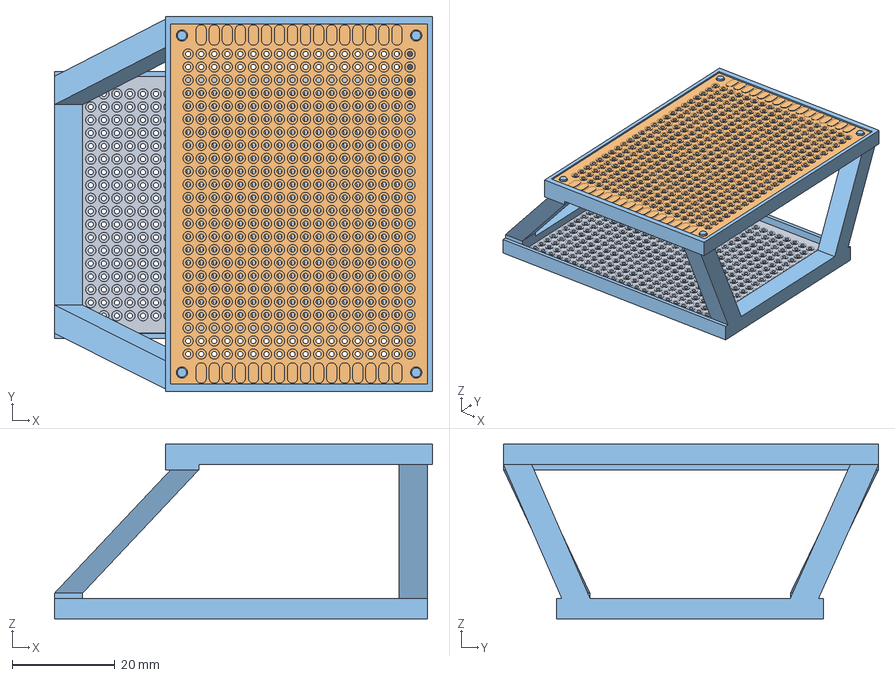
[picture p11: CAD file, 2026-10-02]
mechanical/freecad/Rabosa_montaje-2.FCStd
73.6 x 73.0 x 34.0 mm
pcb_5x_001
pcb_5x_002
Cuerpo001
