pepechorva/Rabosa_micromouse/mechanical/freecad/Rabosa_montaje-5.FCStd

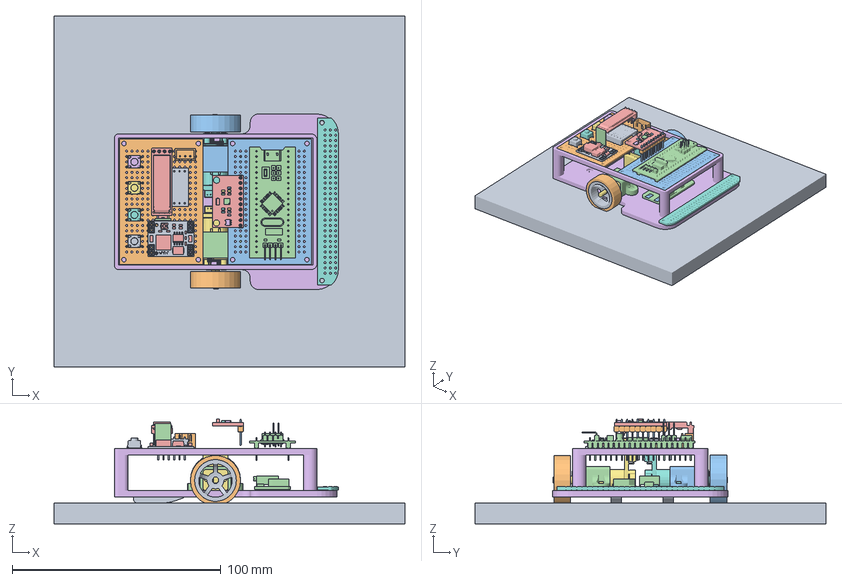
[picture p12: CAD file, 2026-10-02]
mechanical/freecad/Rabosa_montaje-5.FCStd
168.0 x 168.0 x 50.2 mm
main001
silk-TOP
pins
silk-bot
comp-top
Cuerpo
N20 Mini Micro Metall Gear Motor DC 3/6/12V v1
N20 Mini Micro Metall Gear Motor DC 3/6/12V v001
PCB002
PCB003
MC STM32F103C8T6
board
hole_plating
hole_plating001
hole_plating002
hole_plating003
hole_plating004
hole_plating005
hole_plating006
hole_plating007
hole_plating008
hole_plating009
hole_plating010
hole_plating011
hole_plating012
hole_plating013
hole_plating014
hole_plating015
hole_plating016
hole_plating017
hole_plating018
hole_plating019
QFN-24 3x3 0.4mm
tantalum 10uF
SOT23_5
Cuerpo001
Goma003
TFT Display 0.69_96x16
Cuerpo002
Goma004
PCB
AMS1117
SmallComponent
SmallComponent001
Cuerpo003
Cuerpo004
XH 2,54_3p
motor mount-Body
motor mount-Body001
