pepechorva/Rabosa_micromouse/mechanical/freecad/Rabosa_montaje-4.FCStd

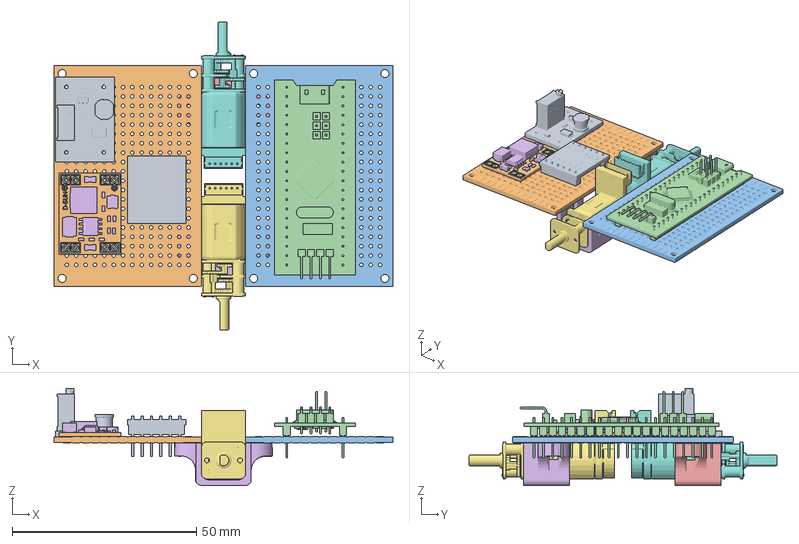
[picture p13: CAD file, 2026-10-02]
mechanical/freecad/Rabosa_montaje-4.FCStd
92.0 x 83.6 x 26.4 mm
YAAJ_DCDC_StepUp_SX1308_cp
main001
silk-TOP
pins
silk-bot
comp-top
N20 Mini Micro Metall Gear Motor DC 3/6/12V v1
N20 Mini Micro Metall Gear Motor DC 3/6/12V v001
PCB002
PCB003
MC STM32F103C8T6
motor mount-Body
motor mount-Body001
