pepechorva/Rabosa_micromouse/mechanical/freecad/Rabosa_montaje.FCStd

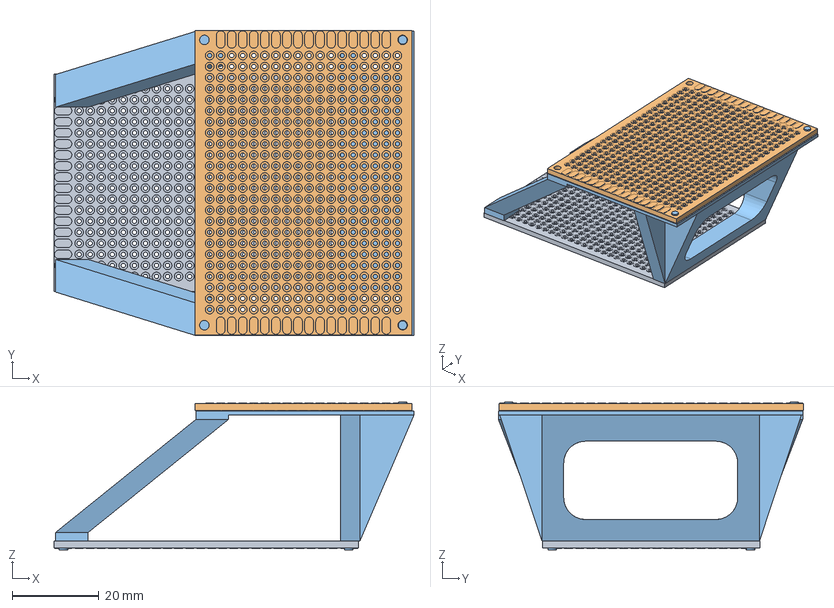
[picture p14: CAD file, 2026-10-02]
mechanical/freecad/Rabosa_montaje.FCStd
82.8 x 70.2 x 34.0 mm
pcb_5x_001
pcb_5x_002
Cuerpo
