pepechorva/Rabosa_micromouse/mechanical/freecad/llanta-N20.FCStd

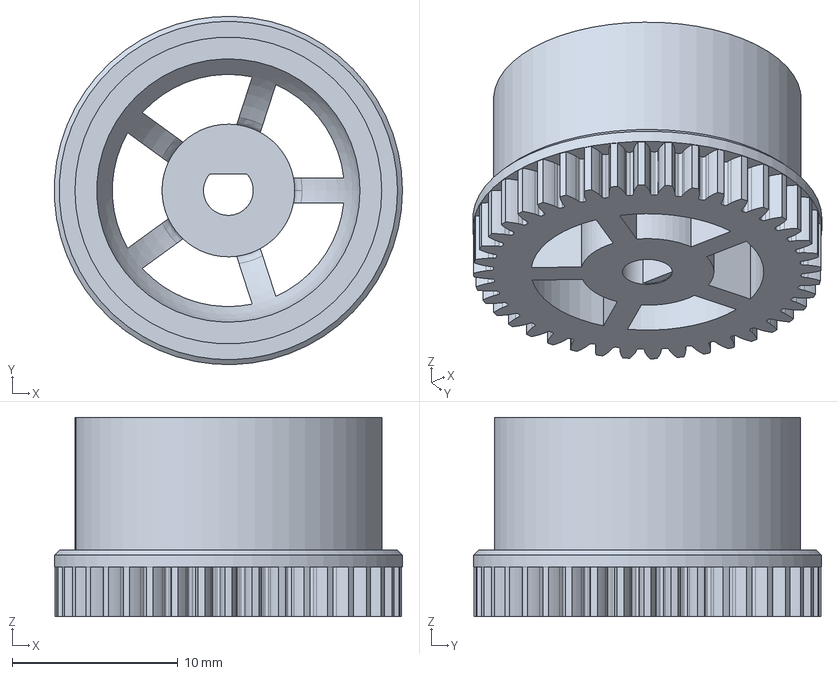
[picture p15: CAD file, 2026-10-02]
mechanical/freecad/llanta-N20.FCStd
21.0 x 21.0 x 12.0 mm
