pepechorva/Rabosa_micromouse/mechanical/freecad/Rabosa.FCStd

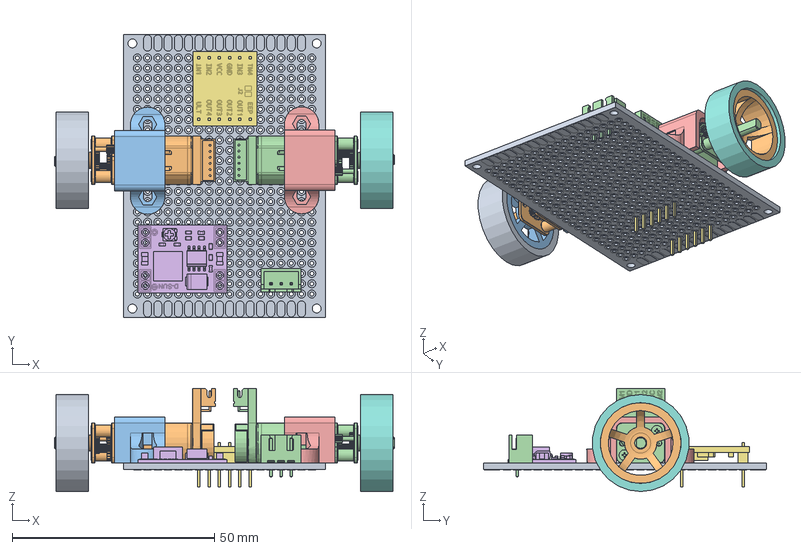
[picture p16: CAD file, 2026-10-02]
mechanical/freecad/Rabosa.FCStd
84.1 x 70.0 x 25.5 mm
pcb_5x_001
N20 Mini Micro Metall Gear Motor DC 3-6-12V v_001
motor mount-Body_001
N20 Mini Micro Metall Gear Motor DC 3-6-12V v_002
motor mount-Body_002
D-SUN_dcdc_step_down_SIMPLE_001
HBridgeDRV_001
Goma-Goma_001
Goma-Goma_002
llanta-no-engranaje_001
llanta-no-engranaje_002
XH 2,54_3p_001
