pepechorva/Rabosa_micromouse/mechanical/freecad/Rabosa_montaje-3.FCStd

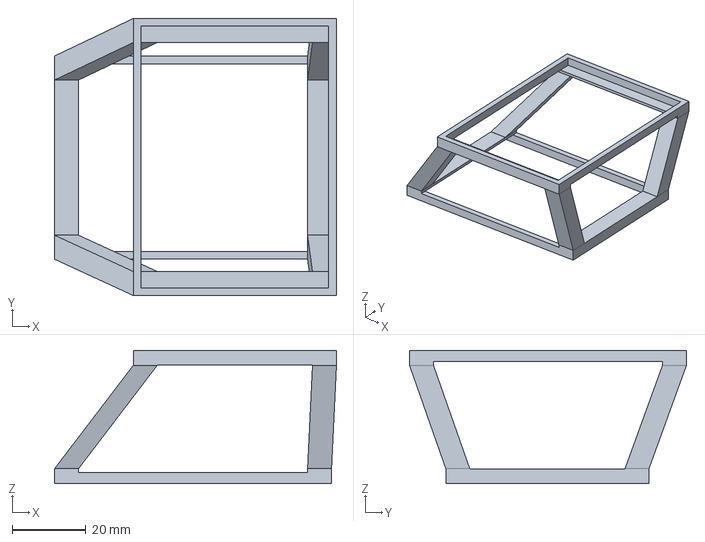
[picture p17: CAD file, 2026-10-02]
mechanical/freecad/Rabosa_montaje-3.FCStd
76.3 x 75.0 x 36.0 mm
