pepechorva/Rabosa_micromouse/mechanical/freecad/llanta-no-engranaje.FCStd

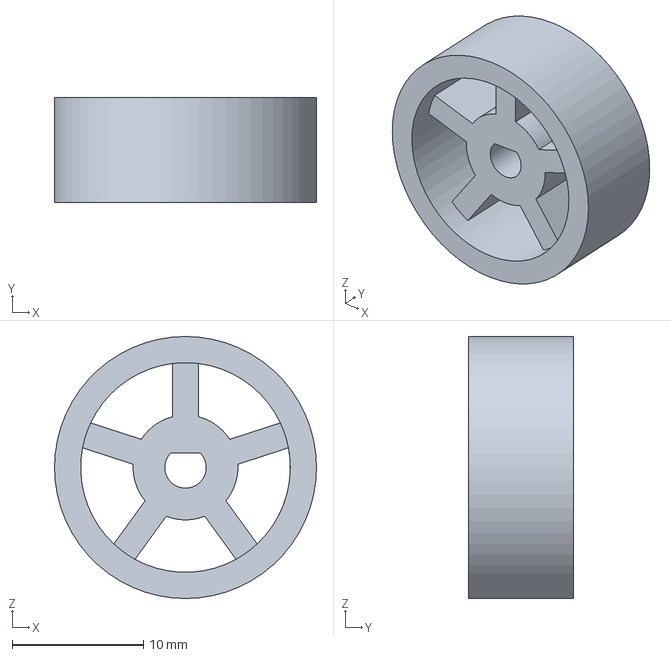
[picture p18: CAD file, 2026-10-02]
mechanical/freecad/llanta-no-engranaje.FCStd
20.0 x 8.00 x 20.0 mm
