pepechorva/Rabosa_micromouse/mechanical/freecad/Goma.FCStd

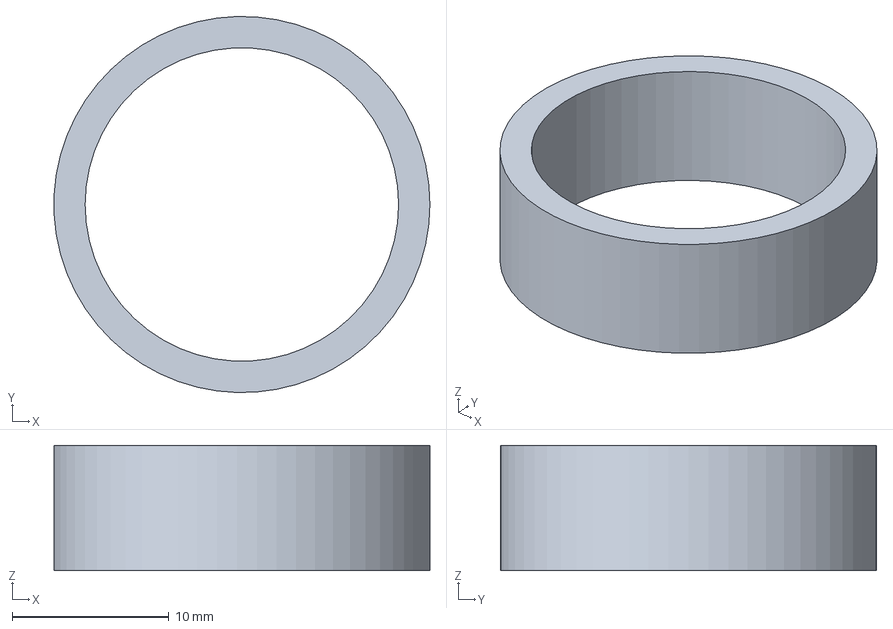
[picture p19: CAD file, 2026-10-02]
mechanical/freecad/Goma.FCStd
24.0 x 24.0 x 8.00 mm
