pepechorva/Rabosa_micromouse/mechanical/freecad/Rabosa-logica.FCStd

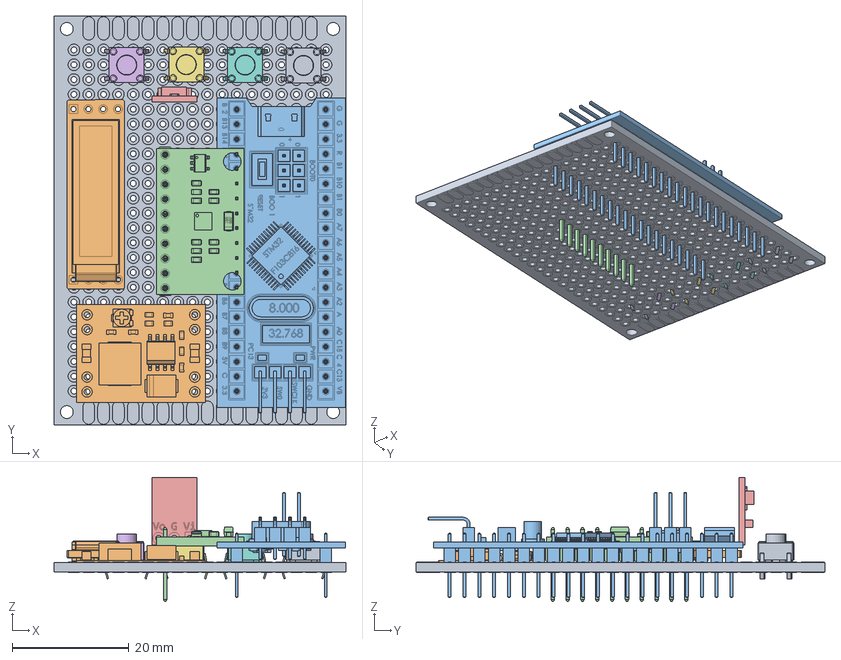
[picture p20: CAD file, 2026-10-02]
mechanical/freecad/Rabosa-logica.FCStd
50.0 x 70.0 x 21.2 mm
pcb_5x_001
D-SUN_dcdc_step_down_Simple_NoSilk__001
MC STM32F103C8T6_pin_001
MPU-_001
Buck Converter AMS1117 3.5-6v to 3.3v_002
push button_001
push button_002
push button_003
push button_004
TFT Display 0.69_96x16_sp_001
