pepechorva/Rabosa_micromouse/(list of files, cad)

Other CAD files:
mechanical/freecad/llanta.FCStd
