pepechorva/Rabosa_micromouse/firmware/hal/systemclock.c

#include "hal/systemclock.h"

/* ------------------------------------------------------------------
 * Configuración del reloj del sistema:
 *   HSE (8 MHz) → PLL x9 → SYSCLK = 72 MHz
 *   APB1 = 36 MHz, APB2 = 72 MHz
 * ------------------------------------------------------------------ */
void SystemClock_Config(void)
{
    RCC_ClkInitTypeDef clkinitstruct = {0};
    RCC_OscInitTypeDef oscinitstruct = {0};

    oscinitstruct.OscillatorType      = RCC_OSCILLATORTYPE_HSE;
    oscinitstruct.HSEState            = RCC_HSE_ON;
    oscinitstruct.HSEPredivValue      = RCC_HSE_PREDIV_DIV1;
    oscinitstruct.LSEState            = RCC_LSE_OFF;
    oscinitstruct.HSIState            = RCC_HSI_OFF;
    oscinitstruct.PLL.PLLState        = RCC_PLL_ON;
    oscinitstruct.PLL.PLLSource       = RCC_PLLSOURCE_HSE;
    oscinitstruct.PLL.PLLMUL          = RCC_PLL_MUL9;
    if (HAL_RCC_OscConfig(&oscinitstruct) != HAL_OK)
        while (1);

    clkinitstruct.ClockType      = RCC_CLOCKTYPE_SYSCLK | RCC_CLOCKTYPE_HCLK
                                 | RCC_CLOCKTYPE_PCLK1 | RCC_CLOCKTYPE_PCLK2;
    clkinitstruct.SYSCLKSource   = RCC_SYSCLKSOURCE_PLLCLK;
    clkinitstruct.AHBCLKDivider  = RCC_SYSCLK_DIV1;
    clkinitstruct.APB2CLKDivider = RCC_HCLK_DIV1;
    clkinitstruct.APB1CLKDivider = RCC_HCLK_DIV2;

    if (HAL_RCC_ClockConfig(&clkinitstruct, FLASH_LATENCY_2) != HAL_OK)
        while (1);
}
