pepechorva/Rabosa_micromouse/firmware/include/peripherals.h

#ifndef __PERIPHERALS_H
#define __PERIPHERALS_H

#include <stdint.h>

#if STM32F0
#include "stm32f0xx_hal.h"
#elif STM32F1
#include "stm32f1xx_hal.h"
#elif STM32F2
#include "stm32f2xx_hal.h"
#elif STM32F3
#include "stm32f3xx_hal.h"
#elif STM32F4
#include "stm32f4xx_hal.h"
#elif STM32F7
#include "stm32f7xx_hal.h"
#elif STM32L0
#include "stm32l0xx_hal.h"
#elif STM32L1
#include "stm32l1xx_hal.h"
#elif STM32L4
#include "stm32l4xx_hal.h"
#else
#error "Unsupported STM32 Family"
#endif

/* Incluye stdbool, stddef, string, math si se necesitan globalmente */
#include <stdbool.h>
#include <stddef.h>
#include <string.h>
#include <math.h>

/* Pin del LED onboard */
#define LEDINBOARD_PIN                GPIO_PIN_13
#define LEDINBOARD_GPIO_PORT          GPIOC
#define LEDINBOARD_GPIO_CLK_ENABLE()  __HAL_RCC_GPIOC_CLK_ENABLE()

#endif
