pepechorva/Rabosa_micromouse/firmware/include/app.h

#ifndef __APP_H
#define __APP_H

#include "peripherals.h"

void App_RunLoop(void);
void App_RunLoop2(void);
void App_RunLoop3(void);
void App_RunLoop4(void);
void App_RunLoop_Encoders(void);
void App_RunLoop_CalcularReductora(void);

#endif
