pepechorva/Rabosa_micromouse/(commit log)

2026-06-30 contador binario de 4 leds
2026-06-30 primera prueba PWM
2026-06-30 cambiar configuración para usar 72 MHz en el micro
2026-06-30 jugando con PWM: efecto coche fantástico
2026-07-02 añadida telemetría por uart para Teleplot
2026-07-02 estructurando el proyecto en librerías separadas
2026-07-05 Cambiado puerto uart del 2 al 3 para ganar 2 ADC
2026-07-05 Movido el proyecto Platformio a la carpeta firmware
2026-07-05 creada documentación básica, el pinout de la bluepill
2026-07-13 Agregado el driver de motores DRV8833
2026-07-13 Agregado módulo ADC y creado un nuevo control para testear los ADC y PWM en el loop principal (app.c)
2026-07-21 añadidas pruebas con el driver de motores y los encoders
2026-10-02 Firmware por capas: control, odometria, paredes y wall follower
    Primer commit desde a6aa9ce (2026-09). Entra todo lo que la lista blanca del
    .gitignore estaba ignorando en silencio: 85 ficheros, entre ellos toda la
    documentacion y casi todo el firmware.
    - firmware/: capas CONTROL (PID sintonizado: Kp=0,10 Ki=0,50 Kd=0),
    FILTER (odometria, trocha efectiva 77,6 mm), SENSOR y HAL completas.
    Menu por tablas en la OLED, consola de ordenes por USART3, telemetria
    Teleplot, primitivas de movimiento en lazo cerrado, deteccion de paredes
    por ON-OFF e wall follower por la regla de la mano.
    - Documentacion/: hardware, calculos de diseno, calibracion, estado del
    proyecto, procedimientos de bri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
2026-10-02 Versionada la plantilla de wifi_secrets.h
    El fichero `firmware/include/wifi_secrets.h.example` existia desde el primer
    dia, pero no estaba en git: la regla `*` del .gitignore lo cazaba y ningun `!`
    lo des-ignoraba. Quien clonara el repositorio no tenia forma de saber que ese
    fichero hace falta, ni que campos lleva.
    - .gitignore: anadida la excepcion `!firmware/include/*.h.example`.
    - El fichero REAL sigue ignorado por su regla explicita, que es lo que
    garantiza que la contrasena no se publique nunca.
    - Comprobado ANTES de commitear, por huella md5 del SSID y de la clave, que la
    plantilla no lleva los valores reales.
2026-10-02 Giro cerrado con el giroscopio: escala 1,20, orden GYRO y umbrales de pared medidos
    - motion: escala del gyro 1,20 (medida con cinta en el suelo), KD 0,3, mínimo de giro
    35 constante y tope de movimiento 8 s -> 3,5 s; término I con anti-windup (KI = 0)
    - console: orden GYRO (KP|KI|KD|ESC|VMIN|VARR|VDPS|LIST) para sintonizar sin reflashear
    - walls: umbral frontal 500 -> 75 (medido: 0 sin pared, 149 con ella a media celda)
    - wall_follower: decisión frente -> mano -> atrás, sin medir el otro lado
    - puente.py: acepta clientes siempre y atiende a todos (arregla el socket zombi)
    - Documentación: orden GYRO, registro de decisiones y pruebas de la sesión
2026-10-11 Lazo de control en interrupción, PID por rueda y banco guionizable
    El retardo del lazo tenía cuatro fuentes y la más gorda no era el filtro: la
    ventana de la media móvil es la SUMA de los dt, así que duraba ~200 ms en la
    misión y ~20 ms en el banco. Lo que arregla eso es fijar el RITMO, no mover el
    código de sitio.
    Lazo de control (app/control_loop.c/h, nuevo)
    - Muestreo de encoders al evento de actualización de TIM1 (~999 Hz), con registro
    de controladores (LOOP_Activar/Desactivar) para que solo regule quien deba.
    Medido: 22 us por paso de los 1001 disponibles (2,2 % de CPU, margen 45x).
    - update_encoder_readings() recibe el dt POR PARÁMETRO: lo llena la interrupción,
    así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
2026-10-11 La ventana del filtro, medida: el retardo limita Kp, no la resolución
    Experimento sobre ENCODER_VEL_VENTANA, que es la palanca que mueve A LA VEZ el
    retardo y la cuantización y en sentidos opuestos. Tres medidas, todas con
    Kp = 0,20 y Ki = 0 (la ganancia que hace oscilar el lazo):
    10 muestras (~10 ms de retardo, 28,7 mm/s de cuantía) -> sigma(duty) 8 %
    20 muestras (~15 ms, 14,3 mm/s) <- la de diseño -> sigma(duty) 28 %
    40 muestras (~25 ms, 7,2 mm/s) -> sigma(duty) 51 %
    y con 40 el lazo se iba a 428 mm/s pidiendo 300, con duty medio negativo.
    Con la medida 4x más fina el lazo va mucho peor => manda el retardo, no la
    resolución. Pero acortar tampoco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
2026-10-11 Giro cerrado: la escala del giroscopio era 1,20 y vale 1,01
    Medido contra una referencia externa, que es la única que vale aquí: dos líneas
    perpendiculares marcadas en la mesa. La telemetría del giro NO sirve para
    calibrar el giro, porque el lazo cierra sobre la misma cuenta que se quiere
    calibrar: sube la escala, el robot gira menos, el lazo corta igual a 90 y la
    telemetría vuelve a decir 90. La referencia se valida a sí misma.
    El barrido se hizo en caliente con la orden GYRO ESC, sin regrabar (un flasheo
    reinicia el robot y con él la calibración del sesgo, así que dos tandas no se
    podrían comparar). MOV UP 4 = 360° pedidos, contra la marca:
    ESC 1,20 -> 80° por esquina (diez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
2026-10-11 El escape con MENU (tres bugs encadenados) y el sesgo del giroscopio
    SALIR NO FUNCIONABA, y no era donde parecía
    Medirlo en el robot tiró mi primer diagnóstico, que era solo lectura de código. La
    causa real:
    BUTTONS_SolicitarSalida() -> GPIO_MenuBtnIRQ_Handler()
    -> HAL_GPIO_EXTI_IRQHandler()
    y esa última solo despacha el callback SI EL FLAG DE EXTI ESTÁ PUESTO. En una orden
    de consola no hay flanco, así que el callback no se llamaba, el contador no subía y
    SALIR no hacía absolutamente nada: el >CMD_SALIR:1 era el acuse de la consola. Nace
    GPIO_MenuBtnIRQ_Solicitar() en hal/gpio.c, que llama al callback directamente.
    Encadenados había otros dos, tamb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
2026-11-12 Doble licencia: GPL-3.0-or-later en software y CERN-OHL-S-2.0 en hardware
    Una licencia por tipo de obra: GPL-3.0-or-later para el firmware y los scripts de
    banco, y CERN-OHL-S-2.0 (fuertemente reciproca) para el diseno de hardware. Sin
    licencia explicita el valor por defecto es "todos los derechos reservados", que es
    justo lo contrario de lo que se quiere.
    Se anaden los creditos, porque el proyecto se apoya en trabajo ajeno: core/profile.c
    adapta el Profile de mazerunner-core (MIT, compatible con GPL-3.0) y su aviso se
    conserva en el propio fichero; de ZoroBot3 (GPL-3.0) solo se toman ideas. Las hojas
    de datos y los modelos de GrabCAD no se relicencian.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
2026-11-12 Capa CORE portable: el contrato core_io.h y el perfil trapezoidal
    core/ es la aplicacion (perfiles, movimiento, mapa) y no toca la HAL: habla con el
    robot por el contrato de core/core_io.h, que implementara drivers/. La interfaz se
    escribe antes que la implementacion, a proposito, para no descubrirla parcheando.
    Primera pieza: core/profile.c, el perfil trapezoidal unit-agnostico portado del
    Profile de mazerunner-core (MIT, aviso conservado en el fichero), con su banco en
    firmware/test/profile_test.c: 9 movimientos y 0 fallos en el PC.
    drivers/ nace vacia con su README porque aun no hay nada que implementar; todavia no
    entra en extra_script.py.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
2026-11-12 Estado del arte frente a los firmwares de referencia
    Documento de decision que junta la matriz de capacidades, lo que funciona MEDIDO, lo
    que esta escrito y no vale, lo que falta con su coste y las fases F1-F9 con su
    puerta de salida. Contrastado con el build del dia: RAM 32,3 % y Flash 79,1 %.
    Se anade al indice y al registro de decisiones junto con las dos decisiones del
    2026-10-30 que lo acompanan: la doble licencia y el nacimiento de core/ y drivers/.
2026-11-12 Medidas de la rueda unificadas: Ø24, 270,7 cuentas y 287,0 um/cuenta
    El nominal con Ø24 da 269,3 y el medido es 287,0 (6,6 % mayor), porque el calibre
    comprime la goma al medir; las cuentas por vuelta medidas son 270,7, no 280. La
    fila de hardware.md decia "Ø efectivo 23,3 con 2,8 % de aplastamiento", que
    contradecia el §4.1 del mismo documento.
    Se corrigen tambien el glosario y el README, que aun arrastraban 235,6 um/cuenta y
    ruedas Ø21, y se pone al dia el estado del proyecto: CONTROL y FILTER ya existen,
    la odometria esta validada y lo que falta es navegar.
2026-11-12 El repositorio se declara prototipo y el arbol de capas queda al dia
    Se deja escrito, arriba del README, que todo lo medido es del montaje de prototipo
    (hito OSHWDem26) y que la V1 hereda la geometria del actuador pero NO los umbrales
    de pared ni la calibracion del ADC, que dependen de donde van los sensores.
    La estructura incorpora core/, drivers/ y test/, y corrige control/ y filter/, que
    seguian anunciados como "por escribir".
2026-11-12 Alta de hardware/pcb-v1/kicad para el diseno de la V1
    Se retira mechanical/kicad, que solo tenia stubs vacios (Rabosa.kicad_sch de 1,8 KB
    sin simbolos y los dos .kicad_pcb de 79 B); el esquema de fuente que habia dentro
    se ha guardado fuera del repositorio antes de borrarlo.
    En su lugar nace hardware/pcb-v1/kicad con su README. La lista blanca del .gitignore
    deja entrar solo los README y lleva las cuatro extensiones de KiCad comentadas, para
    que versionar el proyecto sea una decision explicita cuando exista.
2026-11-12 Conexionado de la V1 por bloques, y las cinco decisiones del esquematico
    hardware/pcb-v1/conexionado.md ordena que terminal de que componente va a que
    red, bloque por bloque (rieles, nucleo, puente H, encoders, emisores y receptores
    IR, bateria, IMU, OLED, botones, consola, LED), con los valores ya medidos y una
    convencion de nombres de red para KiCad. Sale de pinout.h, de hardware.md 2-4 y de
    gpio.c, no de memoria.
    Decisiones cerradas al revisarlo:
    - D2: VM de los motores desde un boost a 9 V, como en el prototipo. Obliga a
    condensador de 100-470 uF junto al driver (un boost no absorbe el frenado) y a
    un boost de >=2 A de salida.
    - D3: encoders a 3,3 V. A 5 V el nivel alto medido era 3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
2026-11-12 El modulo del DRV8833 no trae el condensador que necesita el boost
    Revision del esquema del breakout contra el datasheet:
    - C2 (10 nF entre VCP y VM) y C1 (2,2 uF en VINT) son los que pide el fabricante.
    - C3 (10 uF en VM) se queda corto: con 0,7 A de frenado y el riel a 9 V solo hay 2,8 V
    de margen hasta el maximo absoluto (11,8 V). Hacen falta 470 uF externos mas
    100 nF. Se documenta la cuenta (dV = I·t/C) para que el numero no sea un dogma.
    - R1 (47 k a nSLEEP) es correcto para VM > 6,5 V: 53 uA, bajo el limite de 250 uA.
    - nFAULT SI esta expuesto (P1-6) y SIN pull-up: corrige lo que decia el documento.
    - El modulo tiene DOS redes llamadas VCC y hay que comprobar con el polimetro si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
2026-11-12 Corregido el analisis del condensador: frenar no vuelca energia en el riel
    El datasheet del DRV8833 (tabla 1) dice que con xIN1 = xIN2 = 1 las dos salidas
    quedan a L: es Brake/slow decay, el motor queda cortocircuitado y la corriente
    circula por el bobinado. Esa energia NO entra en VM. Solo Coast (0,0, salidas en
    alta impedancia) la manda por los diodos de cuerpo al riel.
    Con eso el requisito baja de 470 uF a >=100 uF: el caso realista (un flanco de PWM,
    0,15 mJ) sube 0,7 V en 22 uF, y el peor caso de Coast (4,5 mJ, robot de 100 g a
    0,3 m/s) sube 2,8 V en 100 uF en vez de 13 V en 22 uF.
    Tambien queda escrito el argumento a favor de D2 = boost que faltaba: su diodo
    Schottky bloquea el camin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
2026-11-12 Resuelto en hardware: VCC del modulo al boost (9 V) y nSLEEP al riel de 5 V
    El montaje esta probado y funciona: el VCC del modulo es el VM del chip y va a la
    salida del boost; el nSLEEP (EEP) esta soldado al riel de 5 V del step-down. Son
    dos nets distintas a proposito, potencia a 9 V y logica a 5 V.
    Con eso el zener interno de nSLEEP no llega a conducir: a 5 V la corriente es
    5 V / 500 k = 10 uA y el umbral VIH es 2,5 V, asi que hay 2,5 V de margen. Se
    anota la regla para la V1: nSLEEP puede ir a 3V3, y lo que no debe hacerse es
    atarlo al VM de 9 V sin resistencia limitadora.
    Nota no alarmista: con nSLEEP a 5 V, R1 queda entre 9 V y 5 V y deja pasar unos
    85 uA al riel de 5 V. El buck no a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
2026-11-12 Recuento real de pines (2 libres) y por que una AND con nFAULT no basta
    Recuento verificado contra AN2586 tabla 2: con BOOT0 = 0 el valor de BOOT1 es
    indiferente, asi que PB2 es un GPIO normal. Quedan por tanto DOS pines: PA15 y
    PB2. Para tener mas hay que quitar algo: un decodificador 2 a 4 en los emisores IR
    libera dos, un boton menos libera uno.
    Sobre nSLEEP = MCU_habilitar AND nFAULT, del datasheet salen dos cosas:
    - La proteccion del DRV8833 es de reintento automatico cada tOCP = 1,35 ms, no un
    pestillo, y solo desactiva el puente afectado.
    - nFAULT es salida open-drain del propio chip, asi que la AND realimenta: averia,
    nFAULT baja, nSLEEP baja, el chip duerme, la averia desaparec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
2026-11-12 nSLEEP a un GPIO (PA15) y nFAULT descartado
    Decision: nFAULT no se cablea; nSLEEP pasa a PA15. El motivo principal no es
    tanto el consumo como lo que pasa si el firmware falla: con nSLEEP atado a 5 V, un
    MCU colgado deja TIM1 con la ultima comparacion y los motores siguen girando. Con
    el pin en un GPIO, al resetear o colgarse queda en alta impedancia, el pull-down
    interno de 500 k lo lleva a 0 y el driver duerme: el robot se para.
    Numeros del datasheet, porque el ahorro es menor de lo que parece: el DRV8833
    despierto consume 1,7-3 mA y en sleep unos pocos uA, pero el MT3608 sigue
    consumiendo 100-200 uA en reposo (PFM sin conmutar) porque su EN sigue alto. Solo
    baja a 0,1-1 uA con V_EN = 0.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
2026-11-12 nFAULT como LED rojo: el antiparalelo no funciona con salida open-drain
    nFAULT solo puede hundir a 0 V, nunca empujar a 3,3 V, asi que de dos LEDs en
    antiparalelo entre nFAULT y 3V3 solo luce el que va de 3V3 al pin: se comporta como
    un unico LED rojo y el verde no tiene tension que lo encienda.
    El verde ya existe: el modulo trae R2 (4k7) + LED1 sobre VCC, que es el riel de 9 V
    del boost, o sea "boost vivo". Solo falta el rojo: 1 k desde 3V3, mas un pull-up de
    10 k para que nFAULT tenga nivel definido con la salida en alta impedancia. 1,4 mA,
    frente a los 5 mA que aguanta el pin (VOL 0,5 V a 5 mA).
    Y se ve fijo, no parpadeando: el reintento del OCP deja nFAULT bajo 1,35 ms y alto
    unos 4 us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
2026-11-12 nSLEEP: el ahorro que importa es el del driver, no el del boost
    El modulo MT3608 no tiene EN accesible (el chip si, pin 4, pero los modulos lo atan
    a VIN), asi que nSLEEP no apaga el convertidor. Se anaden los numeros sobre la
    bateria de 450 mAh para que la decision no dependa de la intuicion:
    - DRV8833 despierto: 1,7-3 mA => ~16 % de la bateria al dia. Merece dormirlo.
    - MT3608 en reposo: 100-200 uA => ~0,8 % al dia. No compensa perseguirlo.
    O sea, el convertidor consume un 5 % de lo que consume el driver en reposo. Si en la
    V1 el MT3608 va desnudo el pin EN queda libre y apagarlo con el mismo GPIO sale
    gratis, pero no debe ser criterio para elegirlo.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
2026-11-12 Protecciones en la entrada de bateria, que el prototipo no tiene
    Tres amenazas distintas y tres respuestas distintas:
    - Corto: PTC rearmable de retencion 2,6 A en serie con VBAT, 1812 y 40 mohm, o sea
    0,08 V y 160 mW a 2 A. Cuesta centimos y evita que una pista haga de fusible con
    un pack que puede dar 36 A teoricos.
    - Polaridad inversa: P-MOSFET en serie, opcional porque el JST XH va con llave. Se
    avisa de que un AO3401A a 2 A deja 240 mW y calienta: si se pone, de baja Rds(on).
    - Descarga profunda: ya la cubre el firmware con BAT_CRIT_PACK, pero solo con el MCU
    vivo; el UVLO del boost no protege una LiPo.
    Orden: PTC ANTES del interruptor, para que tambien proteja el interruptor y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
2026-11-12 Polaridad inversa resuelta por el JST, interruptor decidido y politica de bateria baja
    - Polaridad inversa: el JST XH va con llave y no admite la conexion al reves, asi
    que se descarta el P-MOSFET en serie: no compensa perder 240 mW a 2 A por el caso
    aislado de un cable mal crimpado.
    - Interruptor de encendido: decidido que se pone; queda el tipo, la posicion y si
    corta tambien el conector de balance.
    - PTC: en estudio, no descartado.
    - Bateria baja: la controla el firmware. Se anota el limite real: el MCU cuelga del
    riel de 5 V del buck, y un buck no da 5 V con 5 V de entrada, asi que la ventana
    "solo OLED" va de 6,0 V a unos 5,5 V. Por debajo se apaga tambien la pantalla.
    El um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
2026-11-12 Politica de bateria: no arrancar por debajo de 6,6 V, con aviso en OLED y LED rojo
    Con dos baterias se cambia la baja y se pone a cargar la otra, asi que el estado
    critico no tiene que durar y no hace falta "solo OLED": basta con negarse a
    arrancar.
    Elegir 6,6 V en vez de 6,00 V arregla el problema de la ventana que se habia
    documentado antes: a 6,6 V el buck tiene 1,6 V de margen hasta su minimo, asi que
    la pantalla se lee con holgura. Y comprobarlo al arrancar, con los motores parados,
    elimina los falsos positivos por la caida de tension del arranque.
    Correccion importante sobre el LED rojo: nFAULT lo manda el DRV8833, no el MCU, asi
    que el firmware no puede encenderlo. Para que sirva de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
2026-11-12 Anotado que el firmware actual no usa ni PA15 ni PB2
    Asi la V1 no tiene que quitarle ningun pin al prototipo para anadir nSLEEP y
    nFAULT: PA15 no se configura en ningun sitio y PB2 se deja como entrada sin pull
    con el comentario de que es BOOT1 y no se usa como GPIO.
2026-11-12 Resumen de las decisiones del 2026-11-12 en el conexionado de la V1
    Tabla compacta para poder retomar el diseno sin releer el documento entero:
    succion fuera de la V1, nSLEEP en PA15, nFAULT en PB2 con LED rojo, PC13
    parpadeando ante cualquier error (patron a definir en firmware), bateria baja por
    debajo de 6,6 V no arranca, polaridad inversa resuelta por el JST, PTC en estudio,
    interruptor si, emisores IR sin decodificador y los cuatro botones.
